RadeonHD6750/Relay4bitComputer/README.md

# Relay4bitComputer
릴레이로 만드는 4bit 컴퓨터

였느나 이왕하는거 8bit로 했다.

2026-05-25, 3-8디코더의 입력단LED 배치가 이상하게 되었으나 디코딩 기능 자체는 정상,
Enabler를 통하여 신호 전력 유지를 하려 했으나 의외로 없어도 잘 됨.
근데 있기는 해야 되는게 신호를 Enable/disable 해야 됨
