RadeonHD6750/Relay4bitComputer/Counter/tDDIFFF.png

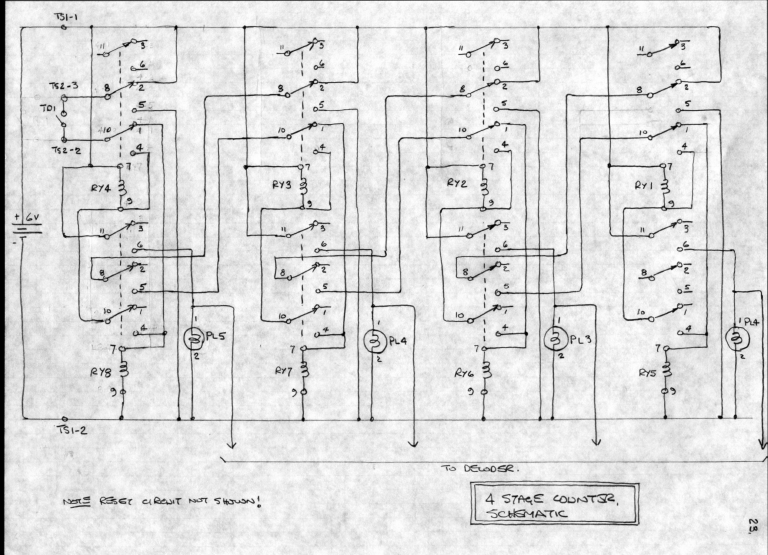
Counter/tDDIFFF.png
