RadeonHD6750/Relay4bitComputer/설계/4bit 가감산기 논리회로.png

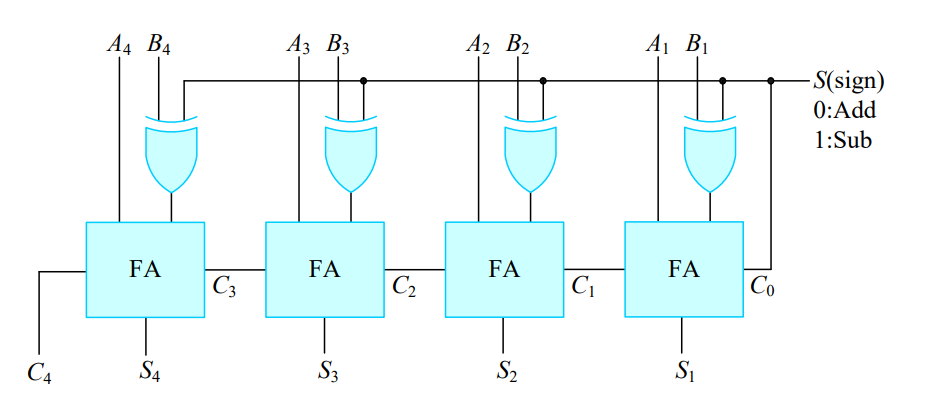
설계/4bit 가감산기 논리회로.png
