RadeonHD6750/Relay4bitComputer/제조/네트클래스 제약조건.png

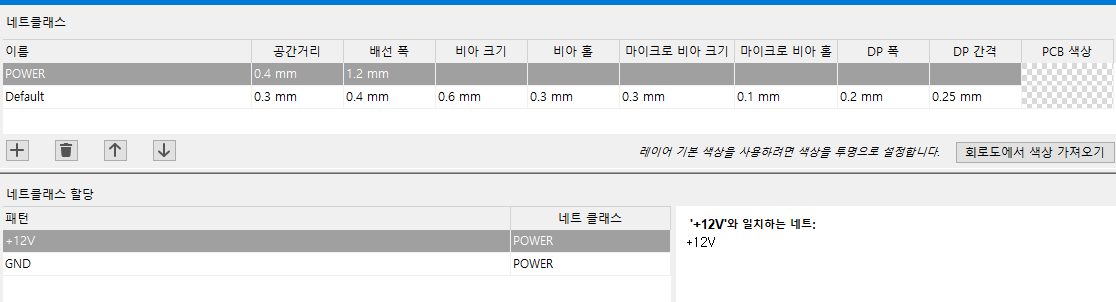
제조/네트클래스 제약조건.png
