RadeonHD6750/Relay4bitComputer/제조/제약조건.png

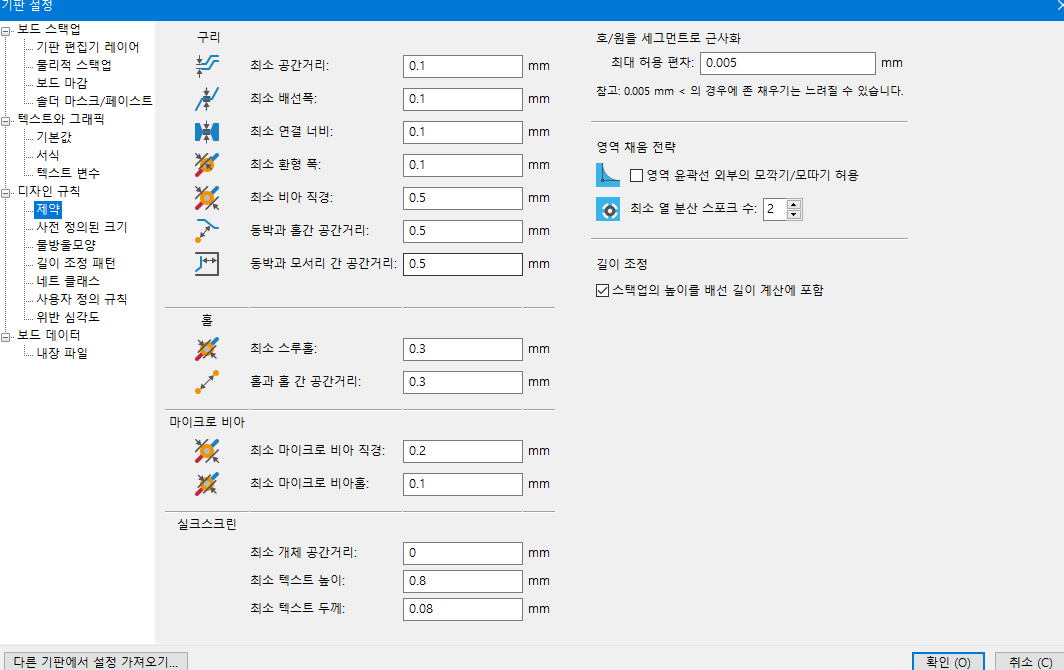
제조/제약조건.png
