RadeonHD6750/Relay4bitComputer/회로도/diode-matrix.jpg

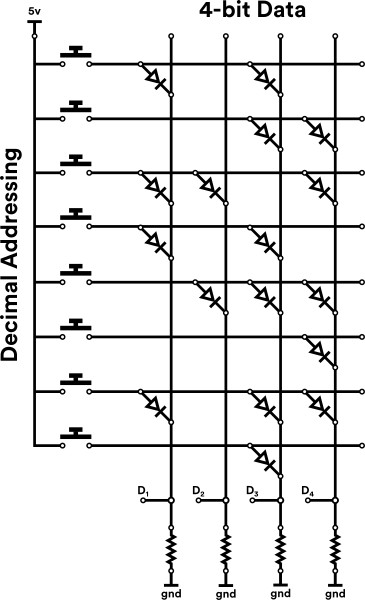
회로도/diode-matrix.jpg
