RadeonHD6750/Relay4bitComputer/Counter/Counter.pdf

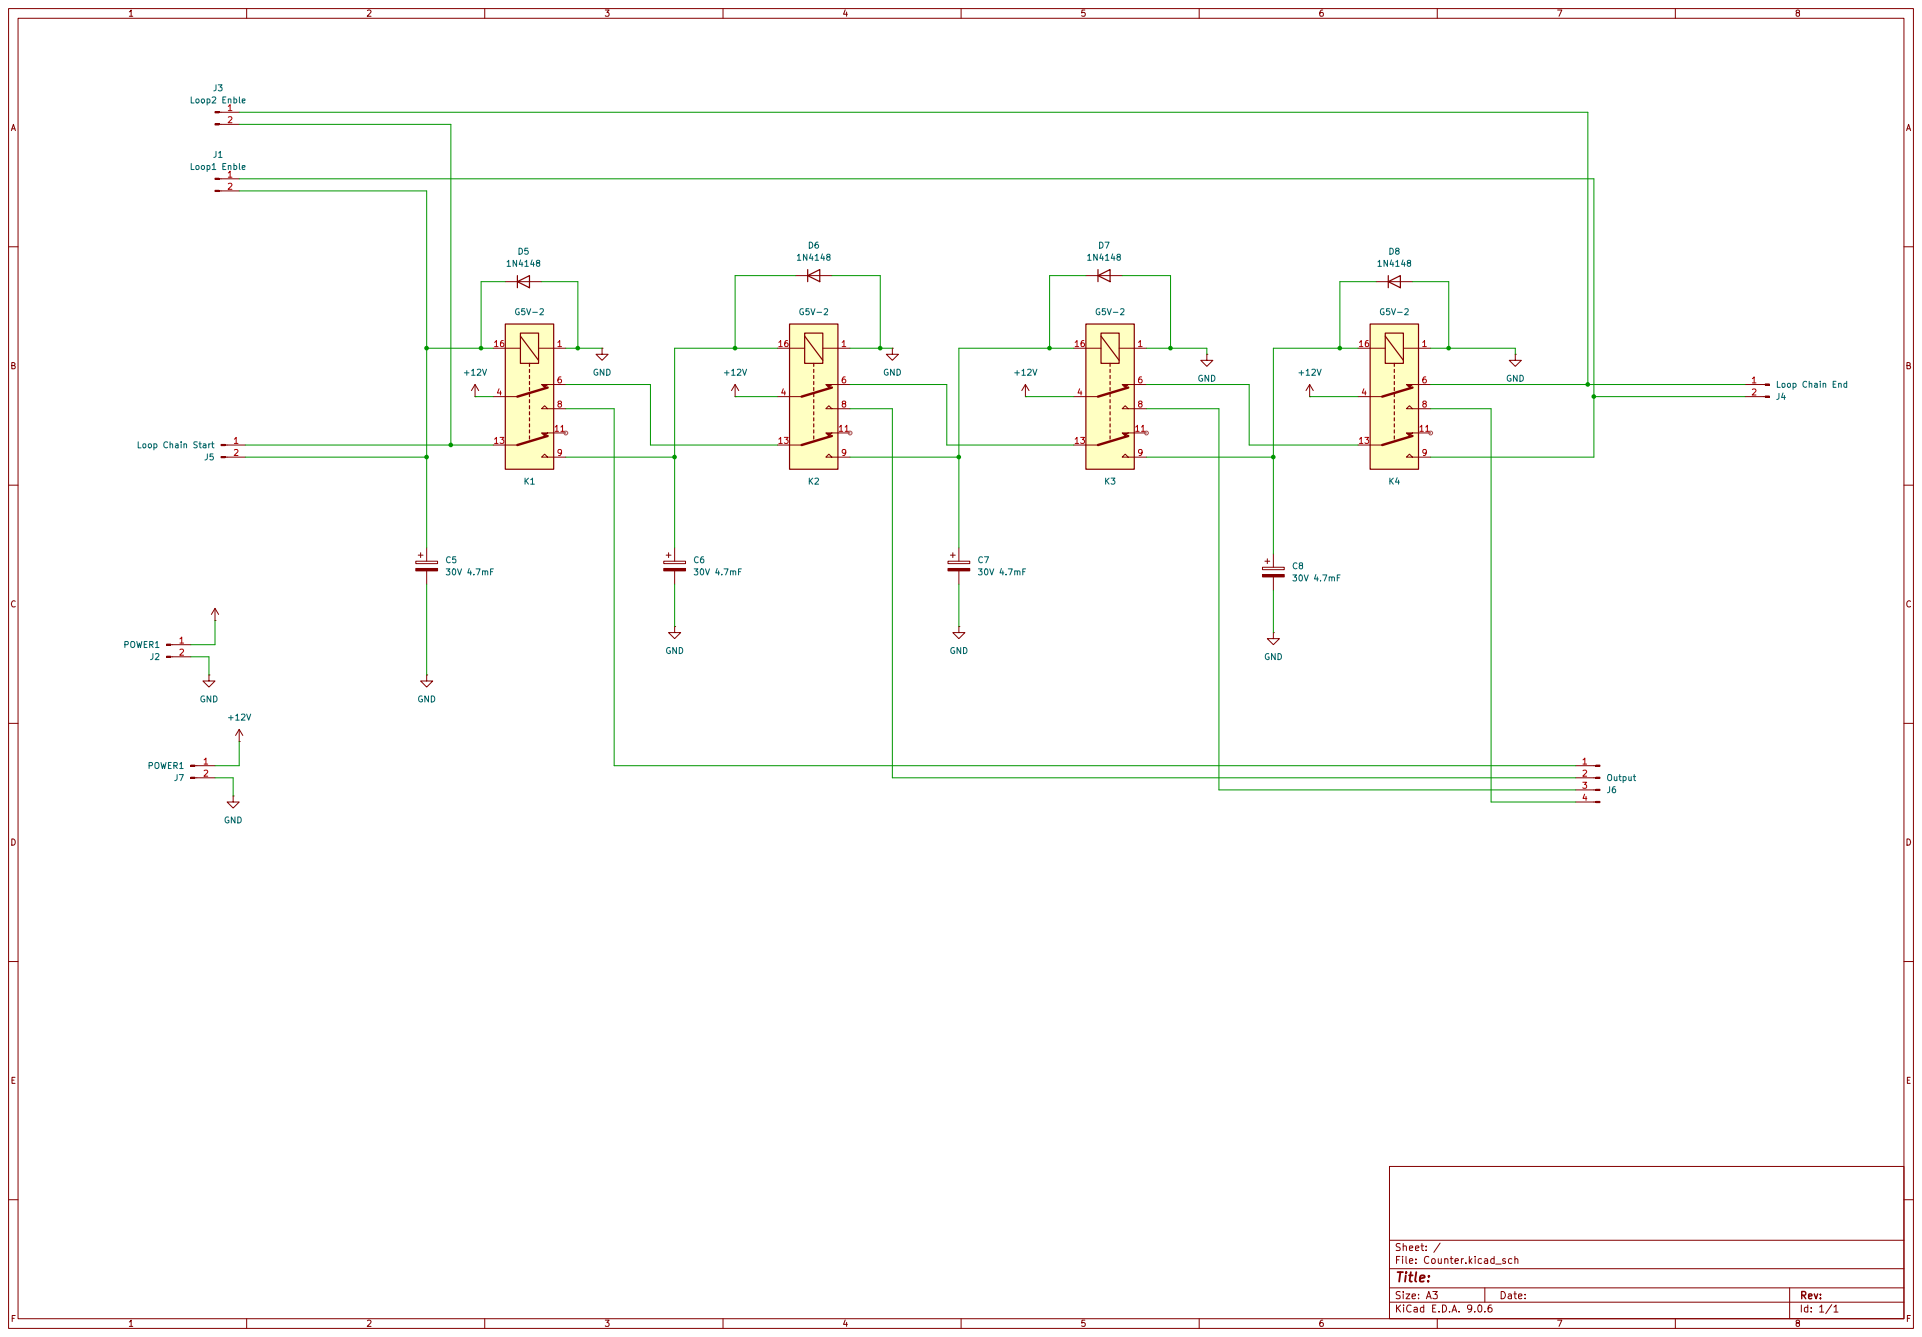
[picture p105: page 1]
