RadeonHD6750/Relay4bitComputer/Enabler/Enabler.pdf

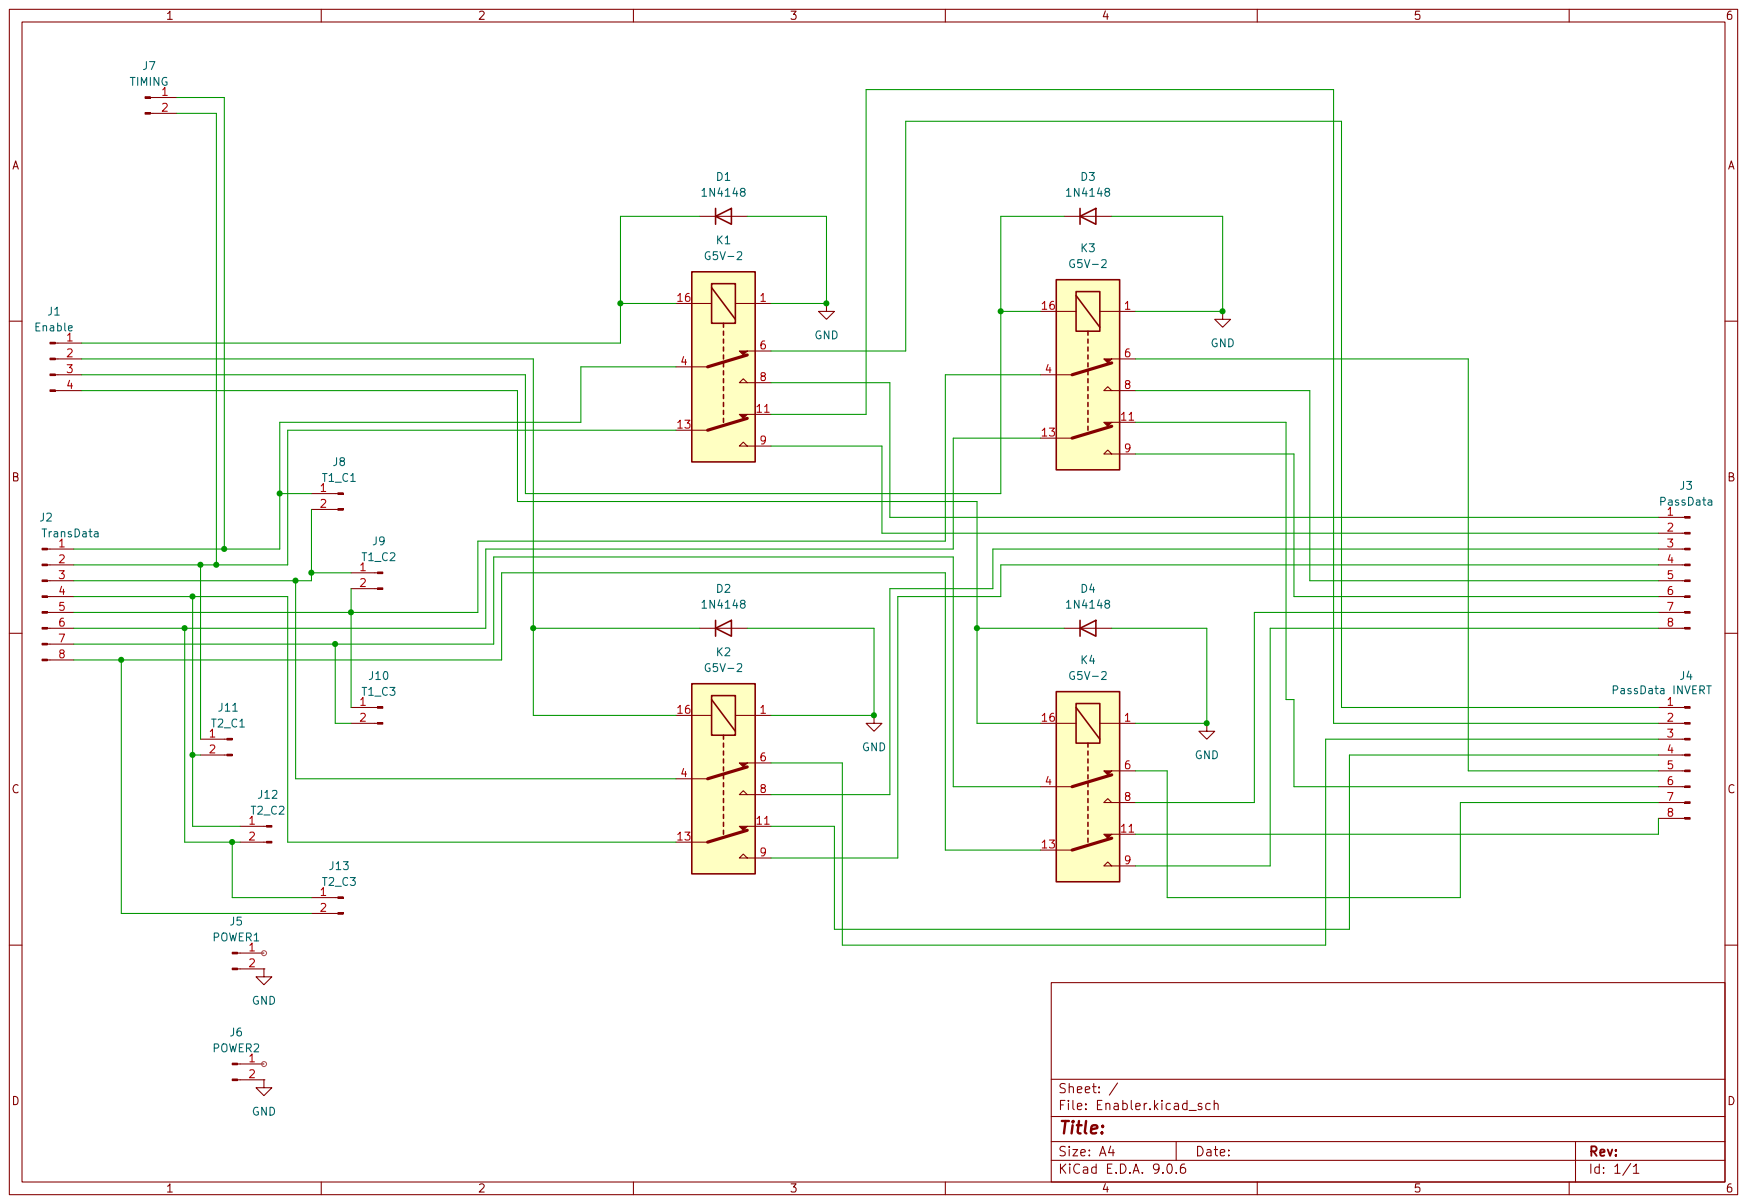
[picture p106: page 1]
