RadeonHD6750/Relay4bitComputer/Decoder/Decoder.kicad_pcb

## KiCad design Decoder/Decoder.kicad_pcb (2026-08-02)

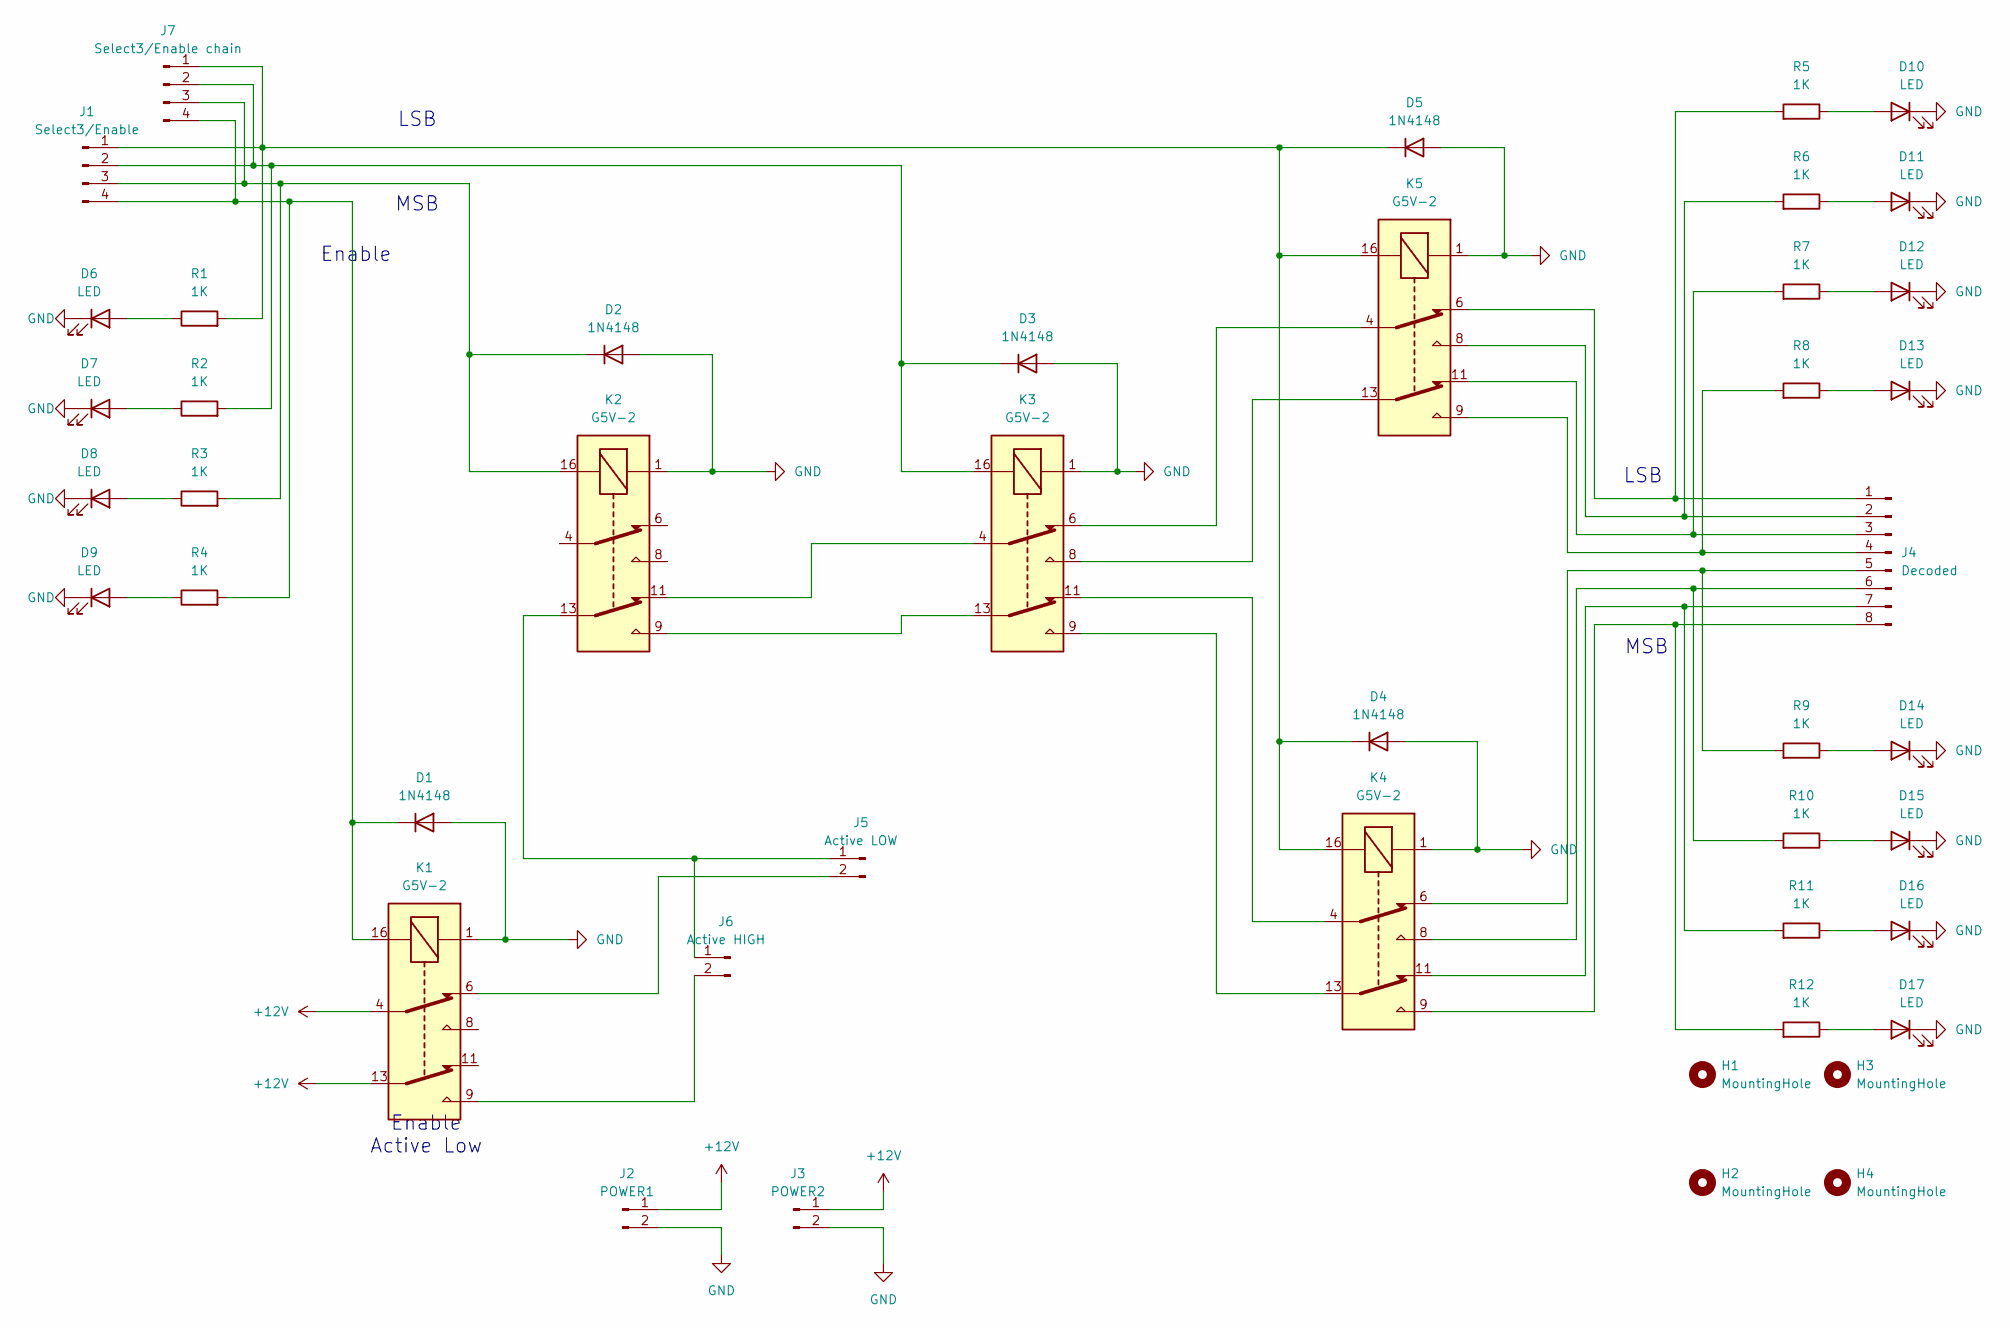
[picture p107: schematic Decoder.kicad_sch]

Parts:
D1, D2, D3, D4, D5: 1N4148; D_DO-35_SOD27_P7.62mm_Horizontal
D6, D7, D8, D9, D10, D11, D12, D13, D14, D15, D16, D17: LED; LED_D5.0mm
H1, H2, H3, H4: MountingHole; MountingHole_3.2mm_M3_Pad
J1: Select3/Enable; PinHeader_1x04_P2.54mm_Vertical
J2: POWER1; PinHeader_1x02_P2.54mm_Vertical
J3: POWER2; PinHeader_1x02_P2.54mm_Vertical
J4: Decoded; PinHeader_1x08_P2.54mm_Vertical
J5: Active LOW; PinHeader_1x02_P2.54mm_Vertical
J6: Active HIGH; PinHeader_1x02_P2.54mm_Vertical
J7: Select3/Enable chain; PinHeader_1x04_P2.54mm_Vertical
K1, K2, K3, K4, K5: G5V-2; Relay_DPDT_Omron_G5V-2
R1, R2, R3, R4, R5, R6, R7, R8, R9, R10, R11, R12: 1K; R_Axial_DIN0207_L6.3mm_D2.5mm_P10.16mm_Horizontal

Connections:
+12V: J2.1, J3.1, K1.4, K1.13
GND: D1.2 (A), D2.2 (A), D3.2 (A), D4.2 (A), D5.2 (A), D6.1 (K), D7.1 (K), D8.1 (K), D9.1 (K), D10.1 (K), D11.1 (K), D12.1 (K), D13.1 (K), D14.1 (K), D15.1 (K), D16.1 (K), D17.1 (K), J2.2, J3.2, K1.1, K2.1, K3.1, K4.1, K5.1
unnamed: D1.1 (K), J1.4, J7.4, K1.16, R4.2
unnamed: D2.1 (K), J1.3, J7.3, K2.16, R3.2
unnamed: D3.1 (K), J1.2, J7.2, K3.16, R2.2
unnamed: D4.1 (K), D5.1 (K), J1.1, J7.1, K4.16, K5.16, R1.2
unnamed: D6.2 (A), R1.1
unnamed: D7.2 (A), R2.1
unnamed: D8.2 (A), R3.1
unnamed: D9.2 (A), R4.1
unnamed: D10.2 (A), R5.1
unnamed: D11.2 (A), R6.1
unnamed: D12.2 (A), R7.1
unnamed: D13.2 (A), R8.1
unnamed: D14.2 (A), R9.1
unnamed: D15.2 (A), R10.1
unnamed: D16.2 (A), R11.1
unnamed: D17.2 (A), R12.1
unnamed: J4.1, K5.6, R5.2
unnamed: J4.2, K5.8, R6.2
unnamed: J4.3, K5.11, R7.2
unnamed: J4.4, K5.9, R8.2
unnamed: J4.5, K4.6, R9.2
unnamed: J4.6, K4.8, R10.2
unnamed: J4.7, K4.11, R11.2
unnamed: J4.8, K4.9, R12.2
unnamed: J5.1, J6.1, K2.13
unnamed: J5.2, K1.6
unnamed: J6.2, K1.9
unnamed: K2.9, K3.13
unnamed: K2.11, K3.4
unnamed: K3.6, K5.4
unnamed: K3.8, K5.13
unnamed: K3.9, K4.13
unnamed: K3.11, K4.4

Notes on the sheet:
LSB
MSB
Enable
Enable Active Low

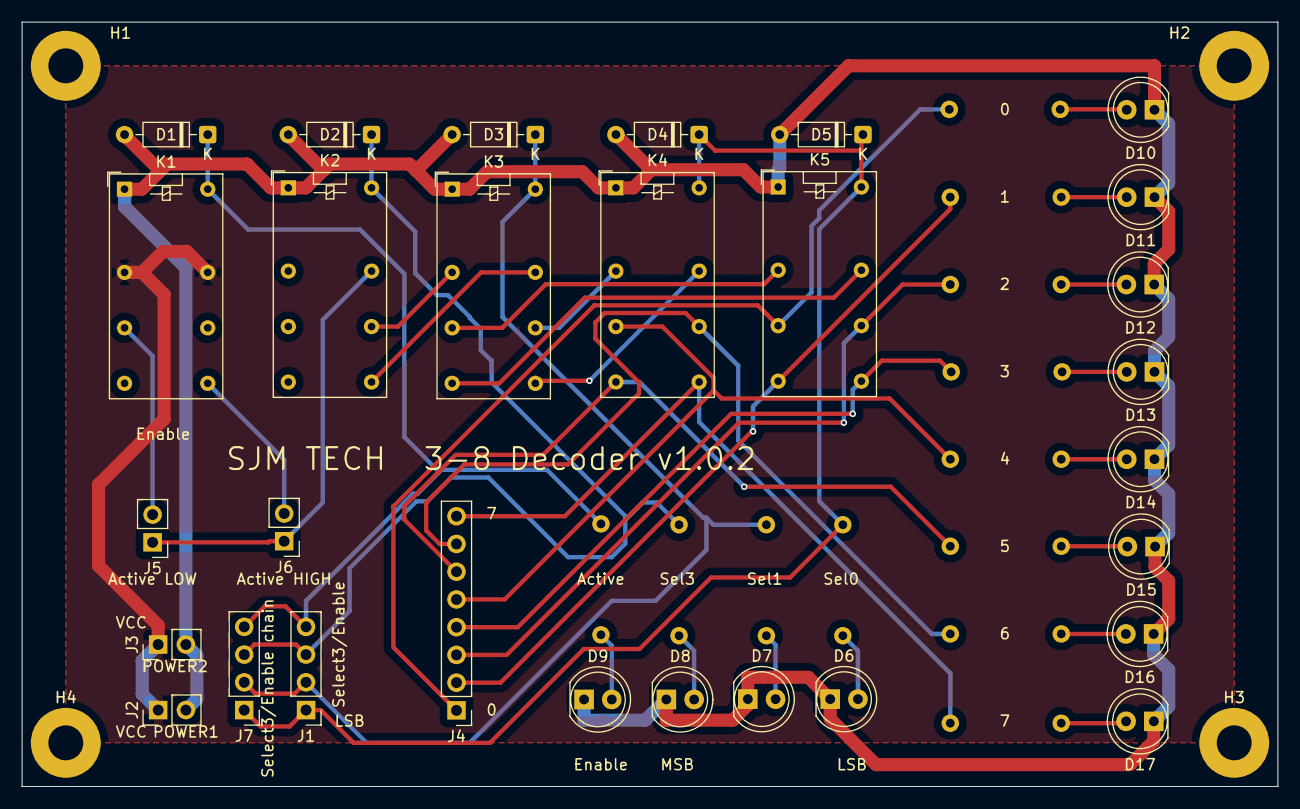
[picture p108: board Decoder.kicad_pcb from above]

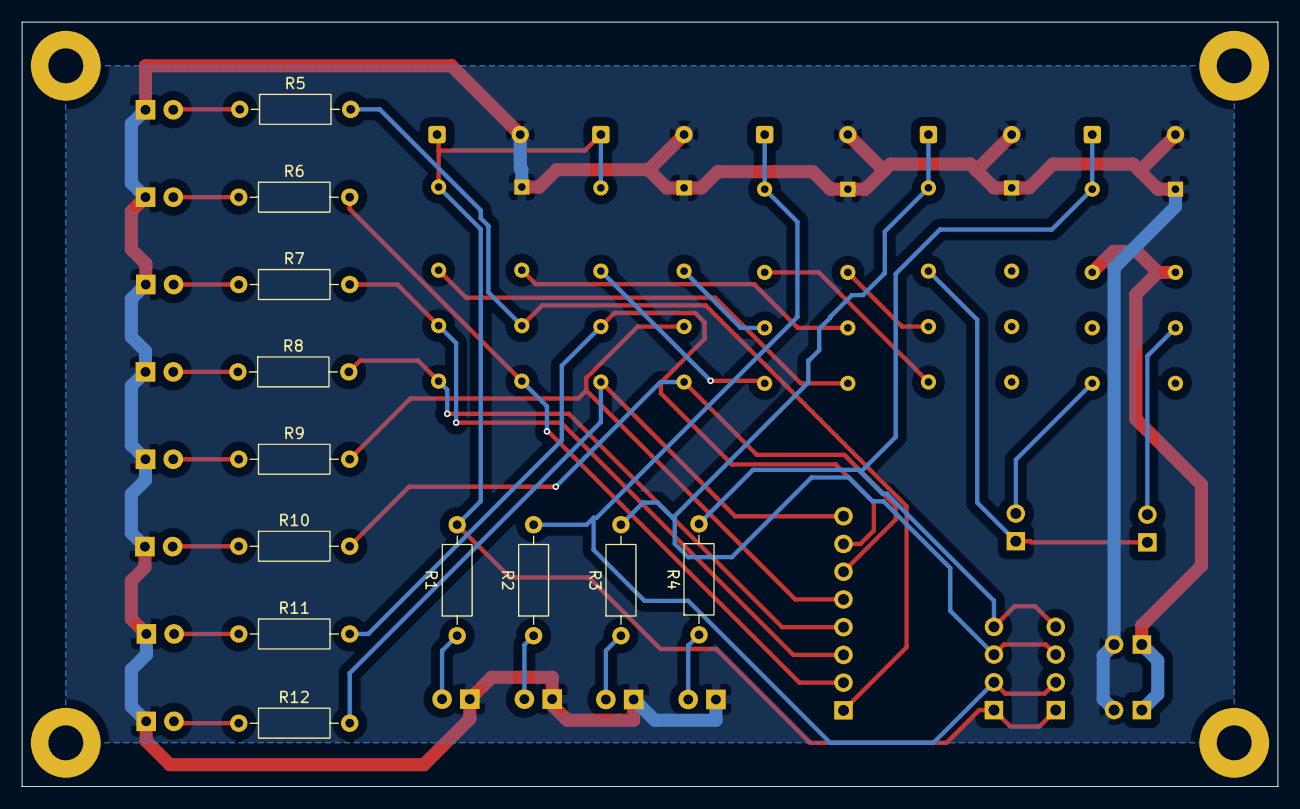
[picture p109: board Decoder.kicad_pcb from below]

Board: 2 copper layers, 115.0 x 70.0 mm, 45 parts (12 on the bottom side), 35 nets.
