RadeonHD6750/Relay4bitComputer/Counter/Counter.kicad_pcb

## KiCad design Counter/Counter.kicad_pcb (2026-07-11)

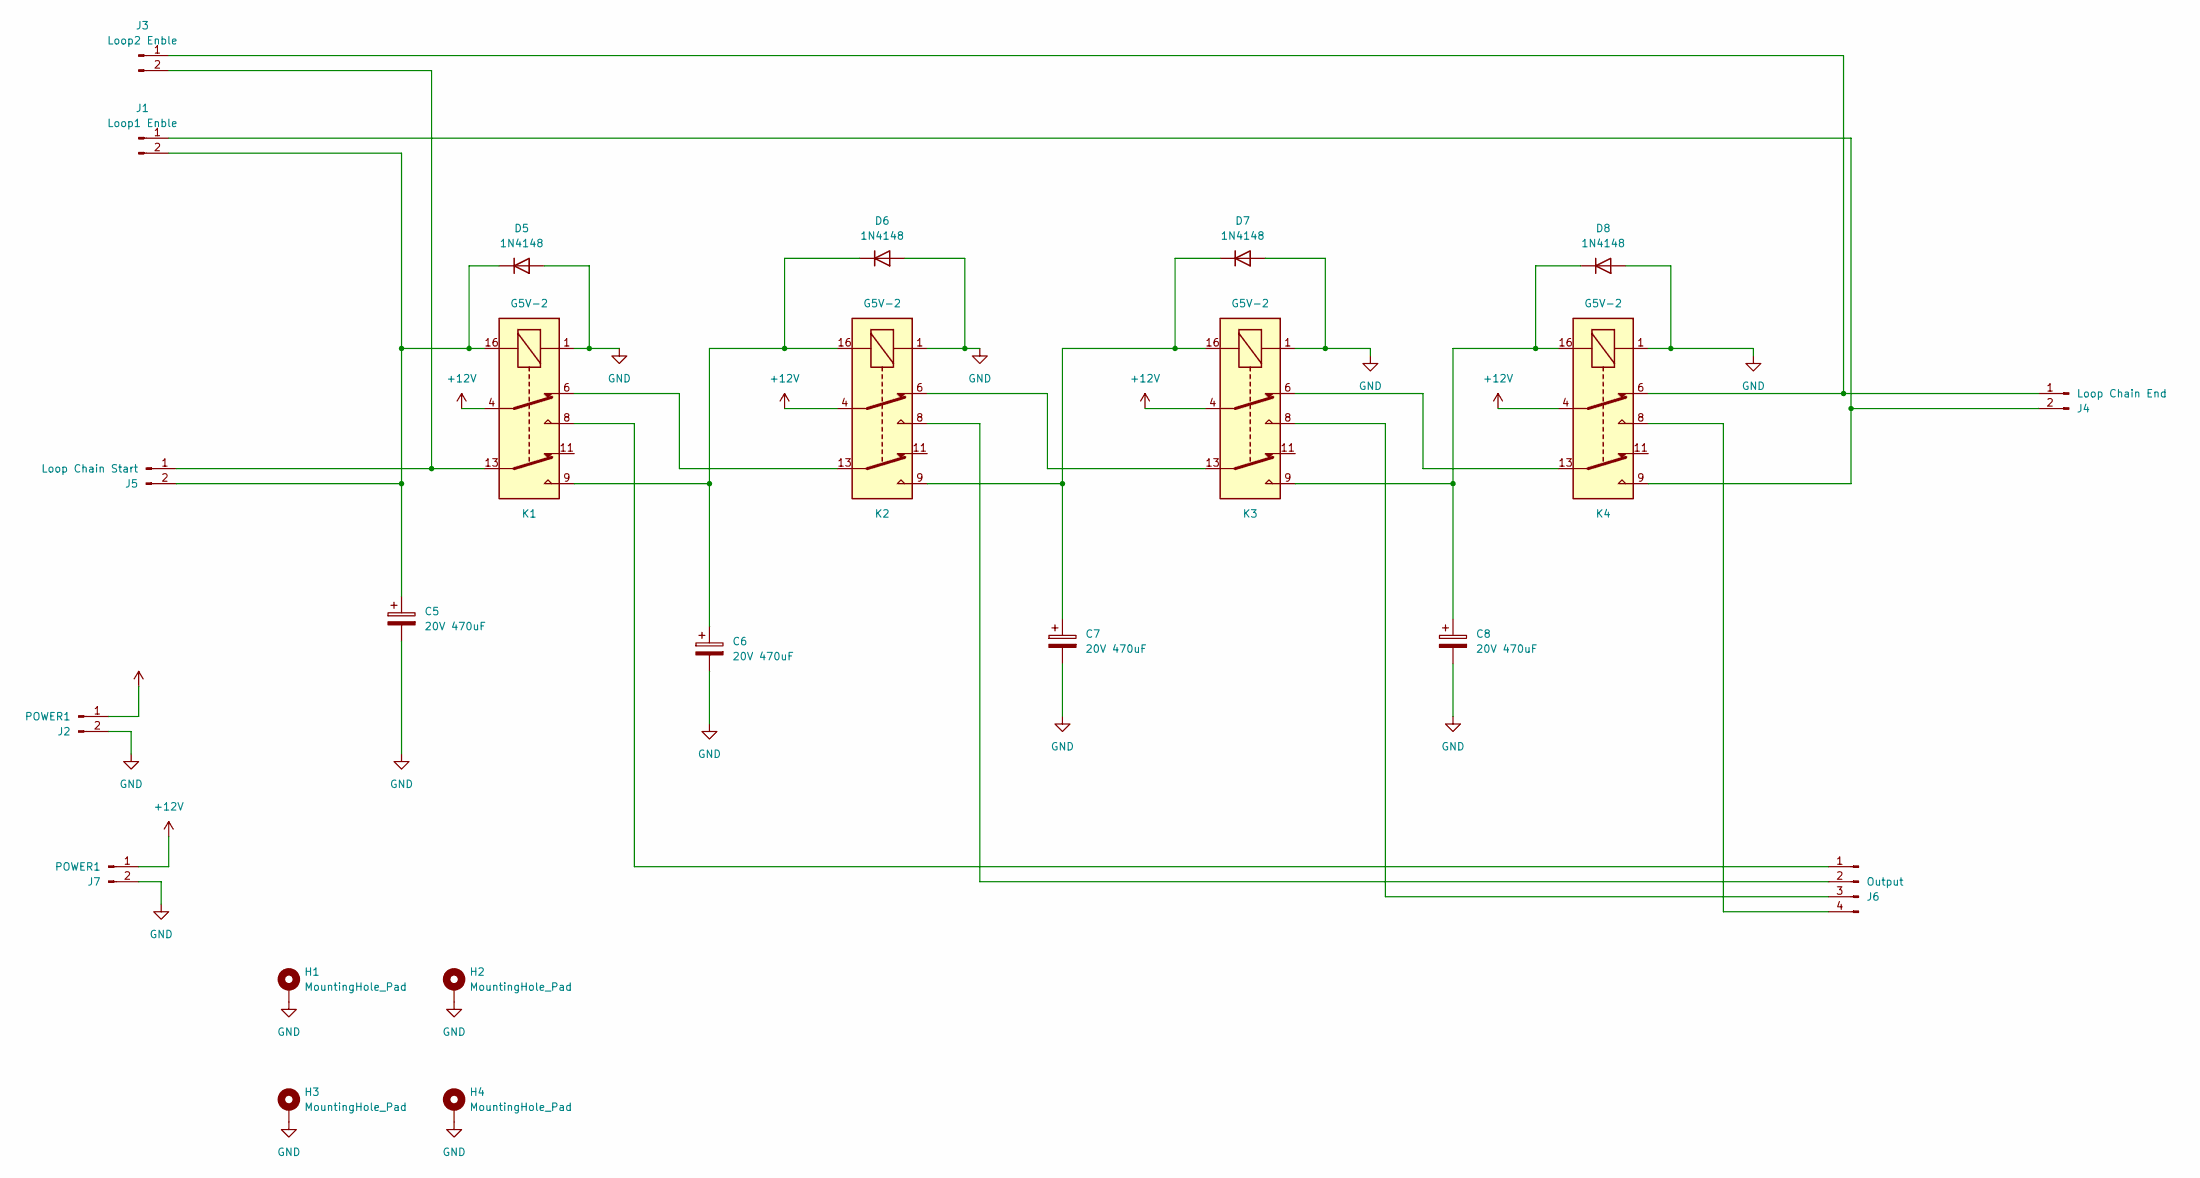
[picture p110: schematic Counter.kicad_sch]

Parts:
C5, C6, C7, C8: 20V 470uF; CP_Radial_D12.5mm_P5.00mm
D5, D6, D7, D8: 1N4148; D_DO-35_SOD27_P7.62mm_Horizontal
H1, H2, H3, H4: MountingHole_Pad; MountingHole_3.2mm_M3_Pad
J1: Loop1 Enble; PinHeader_1x02_P2.54mm_Vertical
J2, J7: POWER1; PinHeader_1x02_P2.54mm_Vertical
J3: Loop2 Enble; PinHeader_1x02_P2.54mm_Vertical
J4: Loop Chain End; PinHeader_1x02_P2.54mm_Vertical
J5: Loop Chain Start; PinHeader_1x02_P2.54mm_Vertical
J6: Output; PinHeader_1x04_P2.54mm_Vertical
K1, K2, K3, K4: G5V-2; Relay_DPDT_Omron_G5V-2

Connections:
+12V: J2.1, J7.1, K1.4, K2.4, K3.4, K4.4
GND: C5.2, C6.2, C7.2, C8.2, D5.2 (A), D6.2 (A), D7.2 (A), D8.2 (A), H1.1, H2.1, H3.1, H4.1, J2.2, J7.2, K1.1, K2.1, K3.1, K4.1
unnamed: C5.1, D5.1 (K), J1.2, J5.2, K1.16
unnamed: C6.1, D6.1 (K), K1.9, K2.16
unnamed: C7.1, D7.1 (K), K2.9, K3.16
unnamed: C8.1, D8.1 (K), K3.9, K4.16
unnamed: J1.1, J4.2, K4.9
unnamed: J3.1, J4.1, K4.6
unnamed: J3.2, J5.1, K1.13
unnamed: J6.1, K1.8
unnamed: J6.2, K2.8
unnamed: J6.3, K3.8
unnamed: J6.4, K4.8
unnamed: K1.6, K2.13
unnamed: K2.6, K3.13
unnamed: K3.6, K4.13

Board: 2 copper layers, 23 parts (0 on the bottom side), 16 nets, no tracks yet.
