RadeonHD6750/Relay4bitComputer/Enabler/Enabler.kicad_pcb

## KiCad design Enabler/Enabler.kicad_pcb (2026-07-11)

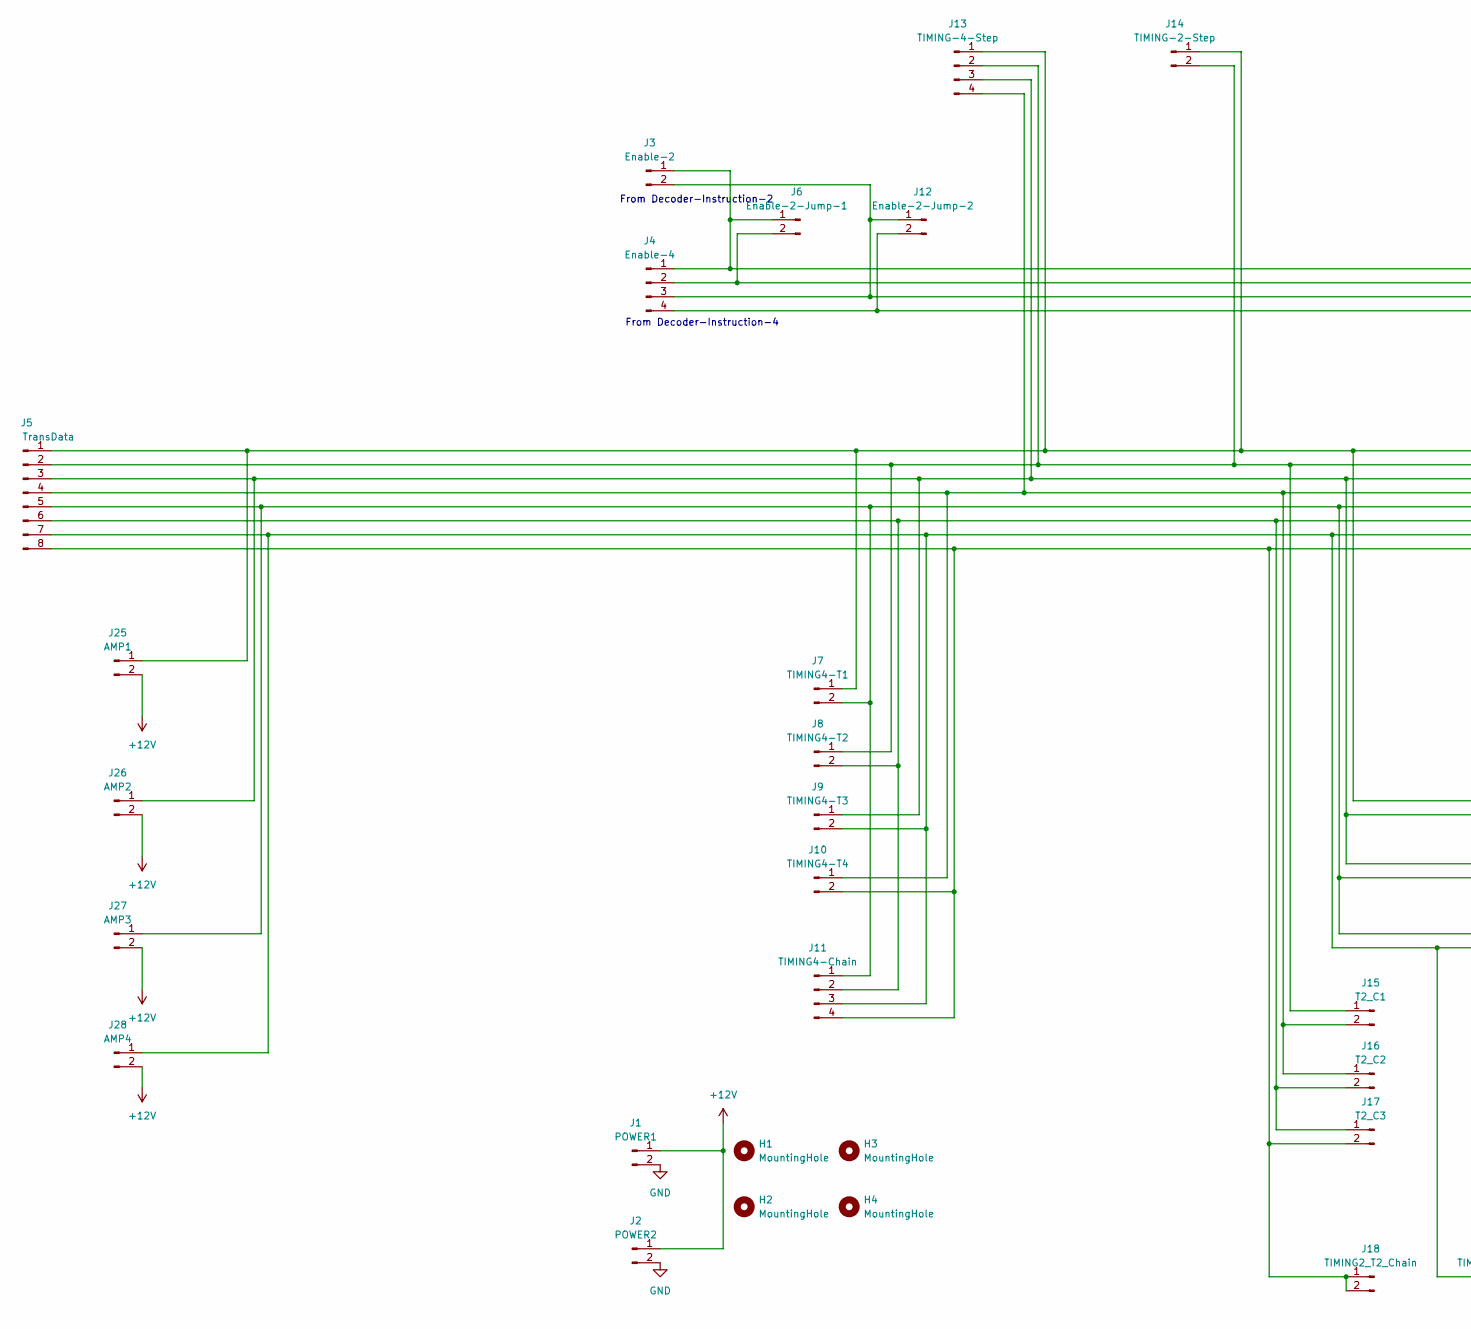
[picture p111: schematic Enabler.kicad_sch, part in row 1, column 1]

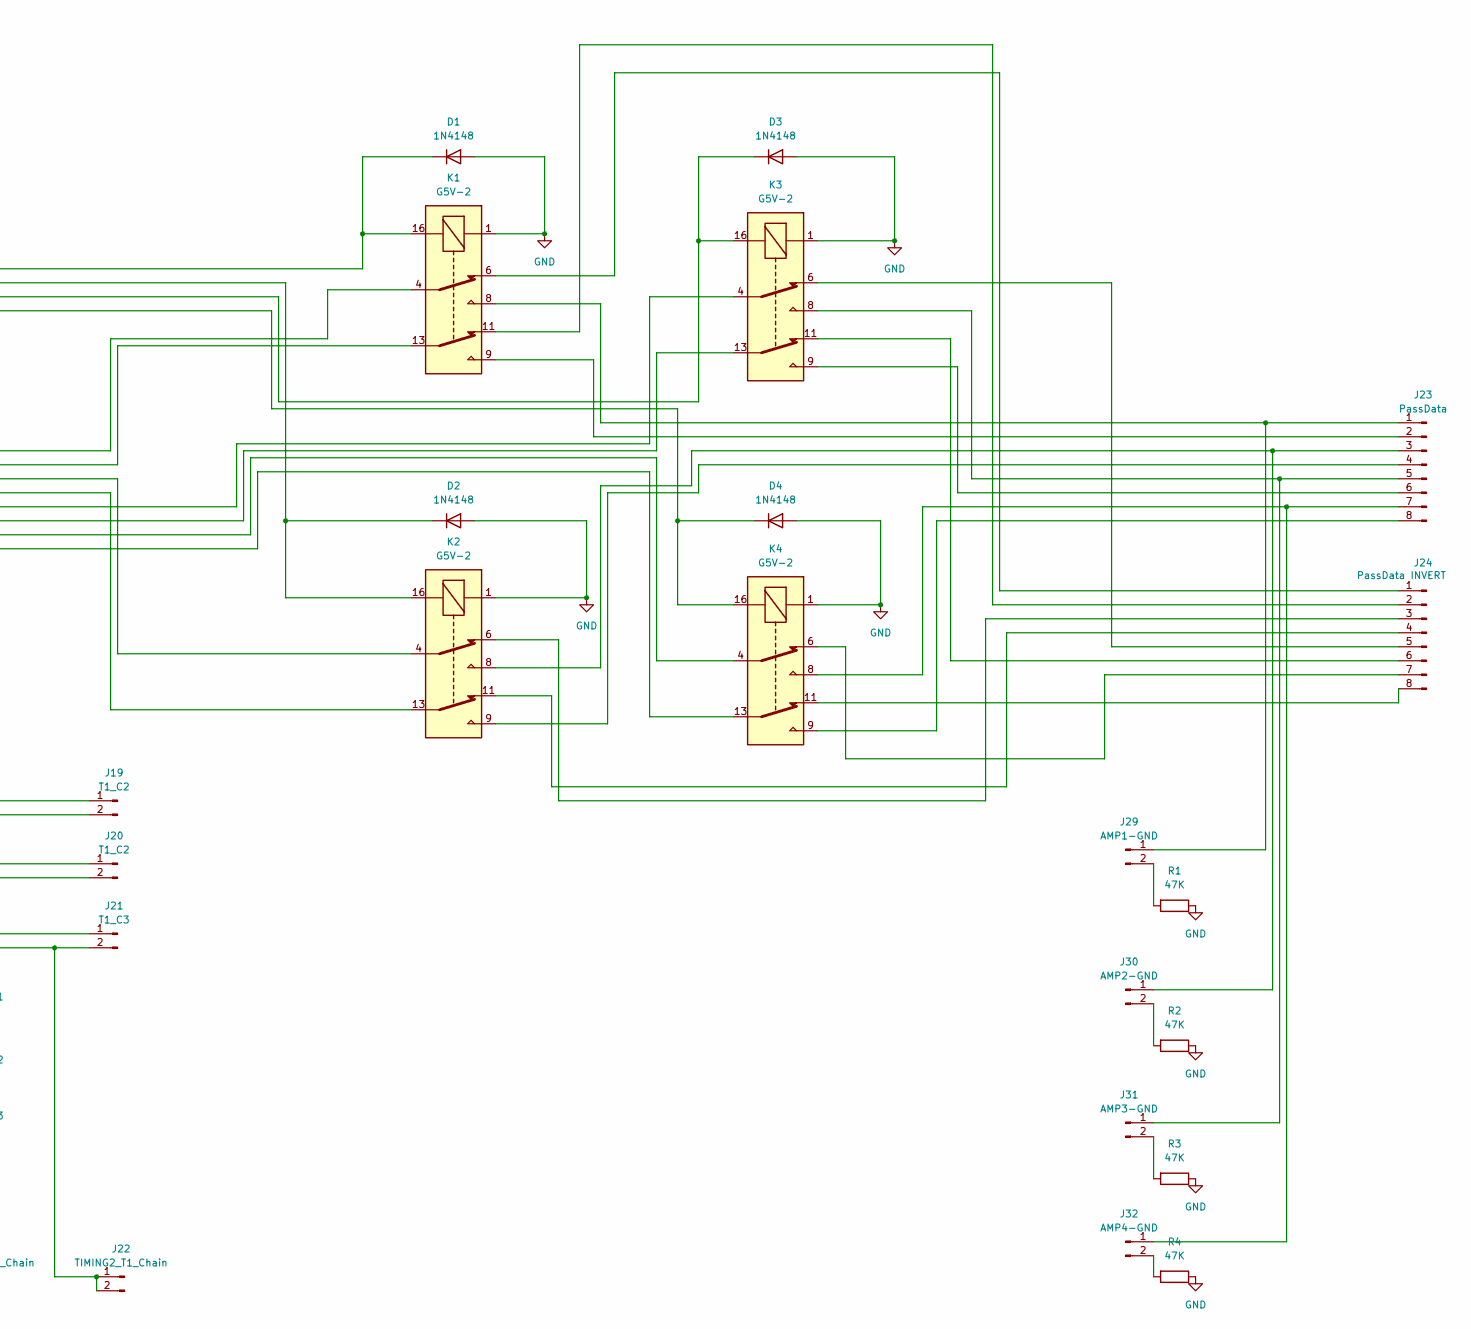
[picture p112: schematic Enabler.kicad_sch, part in row 1, column 2]

Parts:
D1, D2, D3, D4: 1N4148; D_DO-35_SOD27_P7.62mm_Horizontal
H1, H2, H3, H4: MountingHole; MountingHole_3.2mm_M3
J1: POWER1; PinHeader_1x02_P2.54mm_Vertical
J2: POWER2; PinHeader_1x02_P2.54mm_Vertical
J3: Enable-2; PinHeader_1x02_P2.54mm_Vertical
J4: Enable-4; PinHeader_1x04_P2.54mm_Vertical
J5: TransData; PinHeader_1x08_P2.54mm_Vertical
J6: Enable-2-Jump-1; PinHeader_1x02_P2.54mm_Vertical
J7: TIMING4-T1; PinHeader_1x02_P2.54mm_Vertical
J8: TIMING4-T2; PinHeader_1x02_P2.54mm_Vertical
J9: TIMING4-T3; PinHeader_1x02_P2.54mm_Vertical
J10: TIMING4-T4; PinHeader_1x02_P2.54mm_Vertical
J11: TIMING4-Chain; PinHeader_1x04_P2.54mm_Vertical
J12: Enable-2-Jump-2; PinHeader_1x02_P2.54mm_Vertical
J13: TIMING-4-Step; PinHeader_1x04_P2.54mm_Vertical
J14: TIMING-2-Step; PinHeader_1x02_P2.54mm_Vertical
J15: T2_C1; PinHeader_1x02_P2.54mm_Vertical
J16: T2_C2; PinHeader_1x02_P2.54mm_Vertical
J17: T2_C3; PinHeader_1x02_P2.54mm_Vertical
J18: TIMING2_T2_Chain; PinHeader_1x02_P2.54mm_Vertical
J19, J20: T1_C2; PinHeader_1x02_P2.54mm_Vertical
J21: T1_C3; PinHeader_1x02_P2.54mm_Vertical
J22: TIMING2_T1_Chain; PinHeader_1x02_P2.54mm_Vertical
J23: PassData; PinHeader_1x08_P2.54mm_Vertical
J24: PassData INVERT; PinHeader_1x08_P2.54mm_Vertical
J25: AMP1; PinHeader_1x02_P2.54mm_Vertical
J26: AMP2; PinHeader_1x02_P2.54mm_Vertical
J27: AMP3; PinHeader_1x02_P2.54mm_Vertical
J28: AMP4; PinHeader_1x02_P2.54mm_Vertical
J29: AMP1-GND; PinHeader_1x02_P2.54mm_Vertical
J30: AMP2-GND; PinHeader_1x02_P2.54mm_Vertical
J31: AMP3-GND; PinHeader_1x02_P2.54mm_Vertical
J32: AMP4-GND; PinHeader_1x02_P2.54mm_Vertical
K1, K2, K3, K4: G5V-2; Relay_DPDT_Omron_G5V-2
R1, R2, R3, R4: 47K; R_Axial_DIN0207_L6.3mm_D2.5mm_P10.16mm_Horizontal

Connections:
+12V: J1.1, J2.1, J25.2, J26.2, J27.2, J28.2
GND: D1.2 (A), D2.2 (A), D3.2 (A), D4.2 (A), J1.2, J2.2, K1.1, K2.1, K3.1, K4.1, R1.1, R2.1, R3.1, R4.1
unnamed: D1.1 (K), J3.1, J4.1, J6.1, K1.16
unnamed: D2.1 (K), J4.2, J6.2, K2.16
unnamed: D3.1 (K), J3.2, J4.3, J12.1, K3.16
unnamed: D4.1 (K), J4.4, J12.2, K4.16
unnamed: J5.4, J10.1, J13.4, J15.2, J16.1, K2.13
unnamed: J5.8, J10.2, J11.4, J17.2, J18.1, J18.2, K4.13
unnamed: J5.5, J7.2, J11.1, J20.2, J21.1, J27.1, K3.4
unnamed: J5.6, J8.2, J11.2, J16.2, J17.1, K3.13
unnamed: J5.7, J9.2, J11.3, J21.2, J22.1, J22.2, J28.1, K4.4
unnamed: J5.1, J7.1, J13.1, J14.1, J19.1, J25.1, K1.4
unnamed: J5.2, J8.1, J13.2, J14.2, J15.1, K1.13
unnamed: J5.3, J9.1, J13.3, J19.2, J20.1, J26.1, K2.4
unnamed: J23.1, J29.1, K1.8
unnamed: J23.2, K1.9
unnamed: J23.3, J30.1, K2.8
unnamed: J23.4, K2.9
unnamed: J23.5, J31.1, K3.8
unnamed: J23.6, K3.9
unnamed: J23.7, J32.1, K4.8
unnamed: J23.8, K4.9
unnamed: J24.1, K1.6
unnamed: J24.2, K1.11
unnamed: J24.3, K2.6
unnamed: J24.4, K2.11
unnamed: J24.5, K3.6
unnamed: J24.6, K3.11
unnamed: J24.7, K4.6
unnamed: J24.8, K4.11
unnamed: J29.2, R1.2
unnamed: J30.2, R2.2
unnamed: J31.2, R3.2
unnamed: J32.2, R4.2

Notes on the sheet:
From Decoder-Instruction-4
From Decoder-Instruction-2

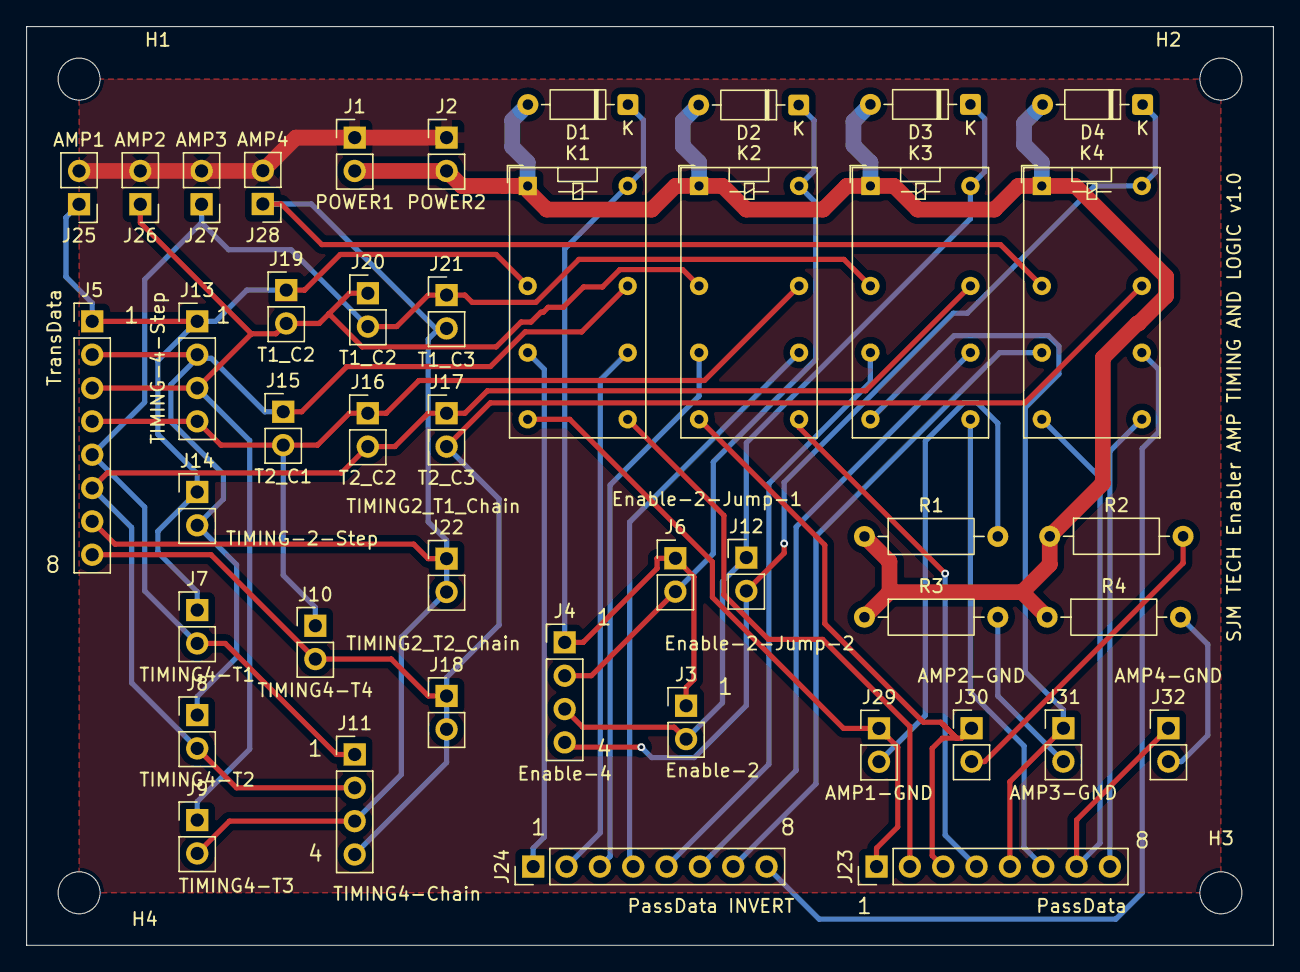
[picture p113: board Enabler.kicad_pcb from above]

Board: 2 copper layers, 95.0 x 70.0 mm, 48 parts (0 on the bottom side), 34 nets.
