RadeonHD6750/Relay4bitComputer/MatrixROM/MatrixROM.kicad_pcb

## KiCad design MatrixROM/MatrixROM.kicad_pcb (2026-07-05)

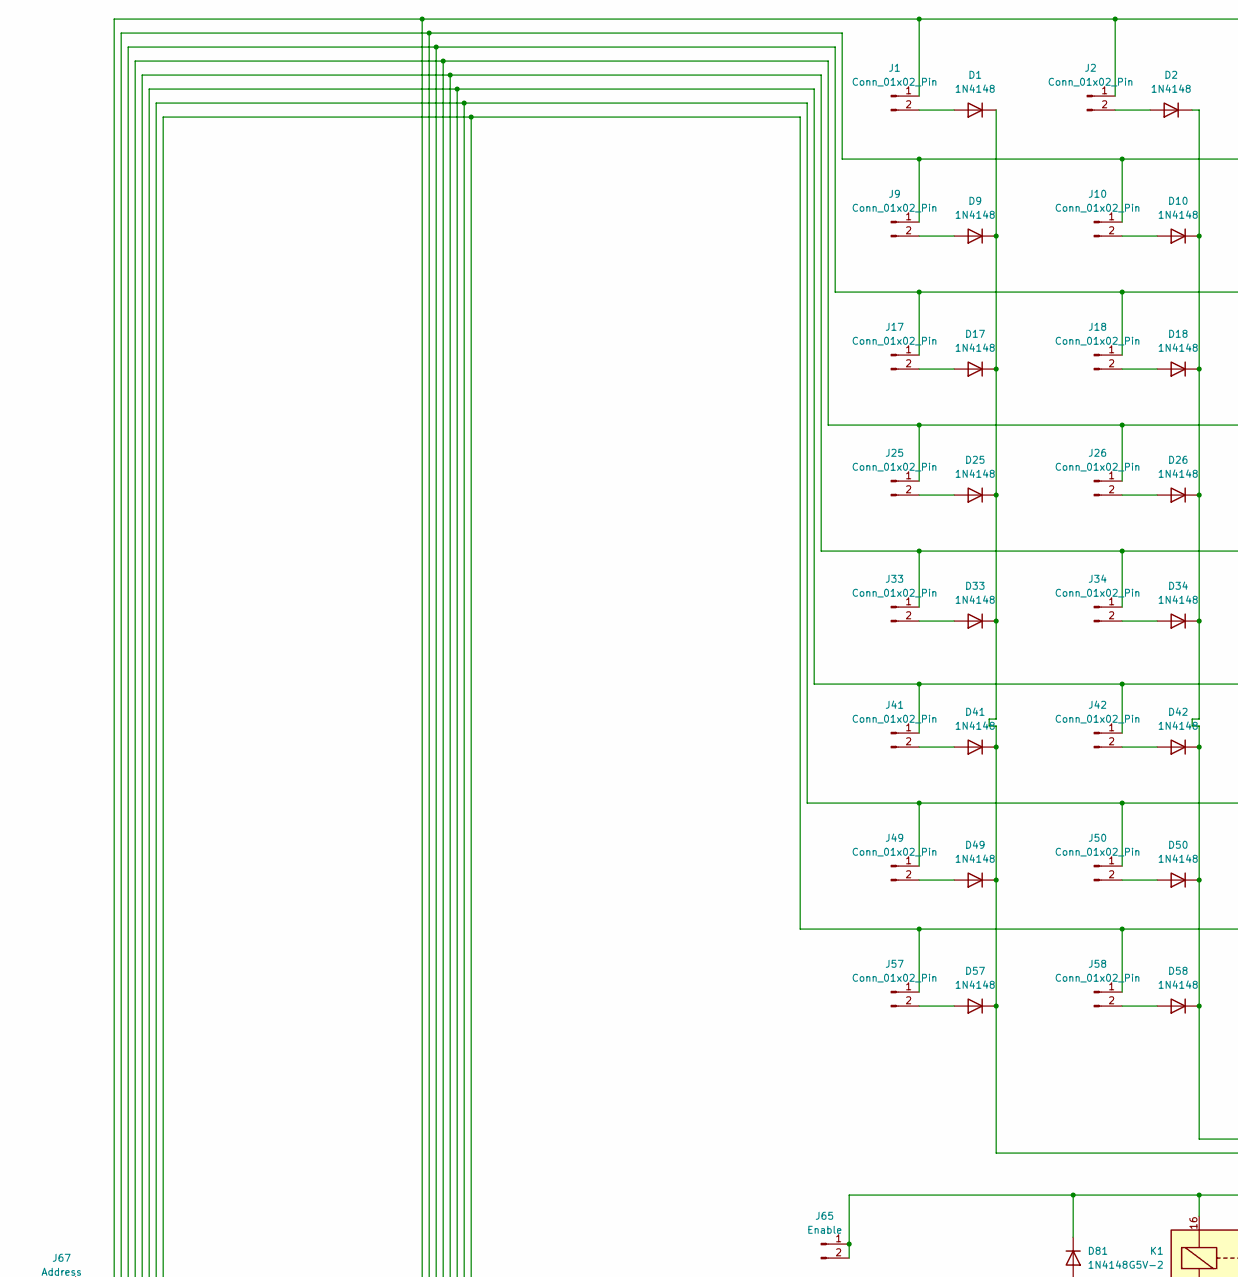
[picture p114: schematic MatrixROM.kicad_sch, part in row 1, column 1]

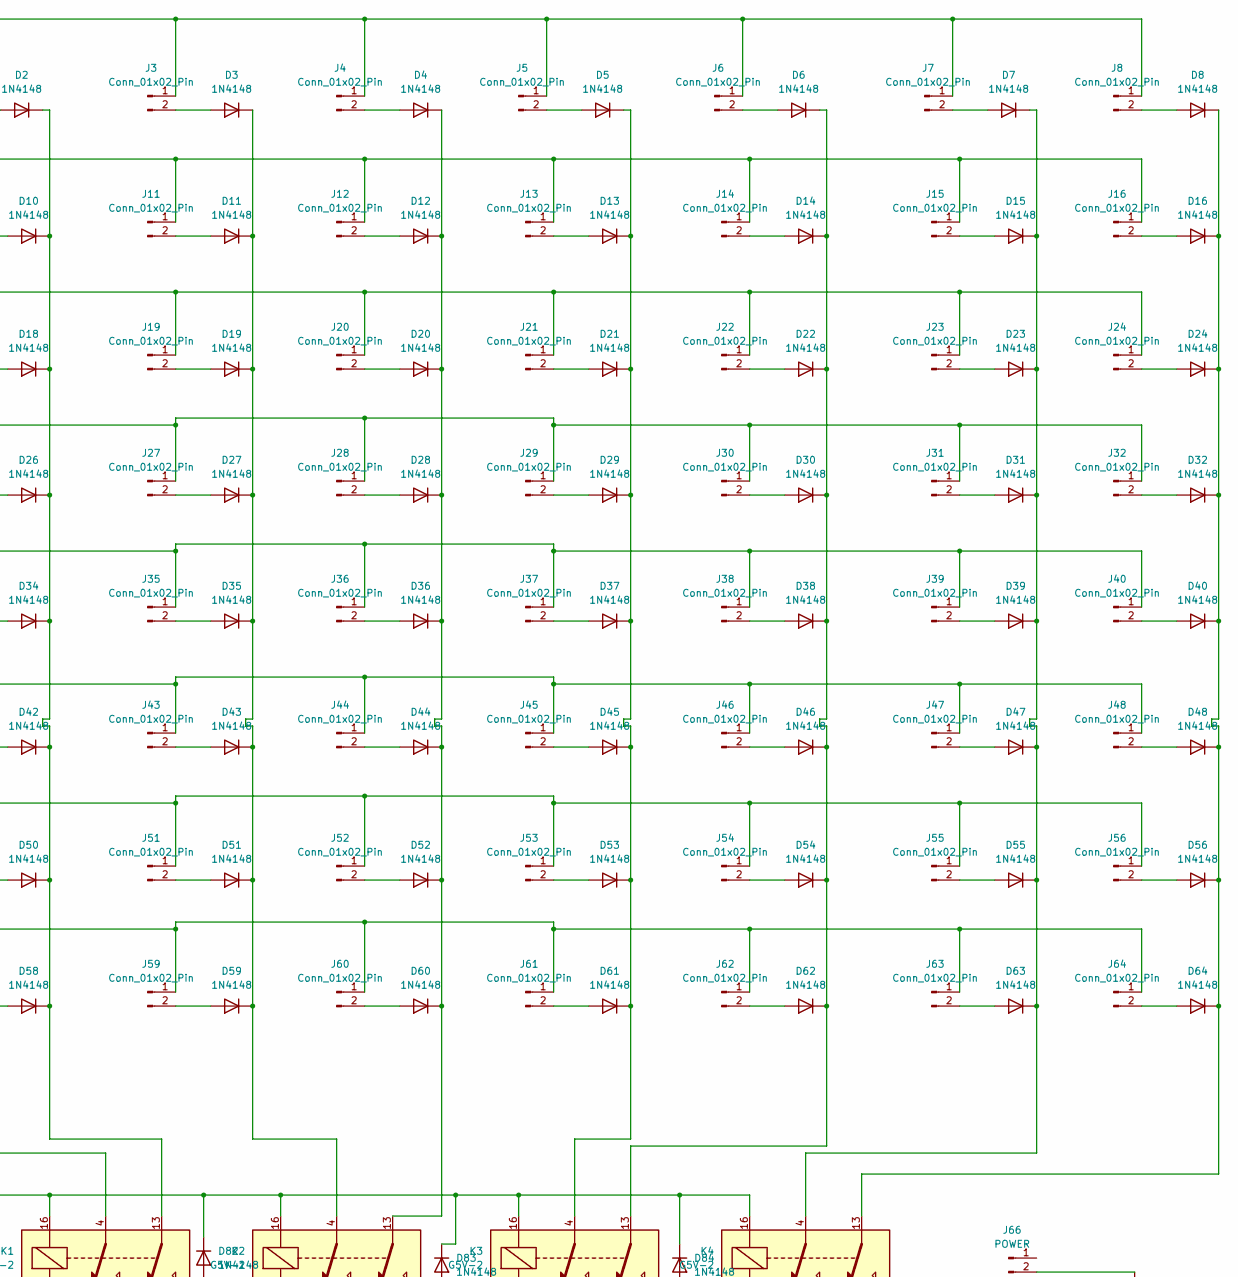
[picture p115: schematic MatrixROM.kicad_sch, part in row 1, column 2]

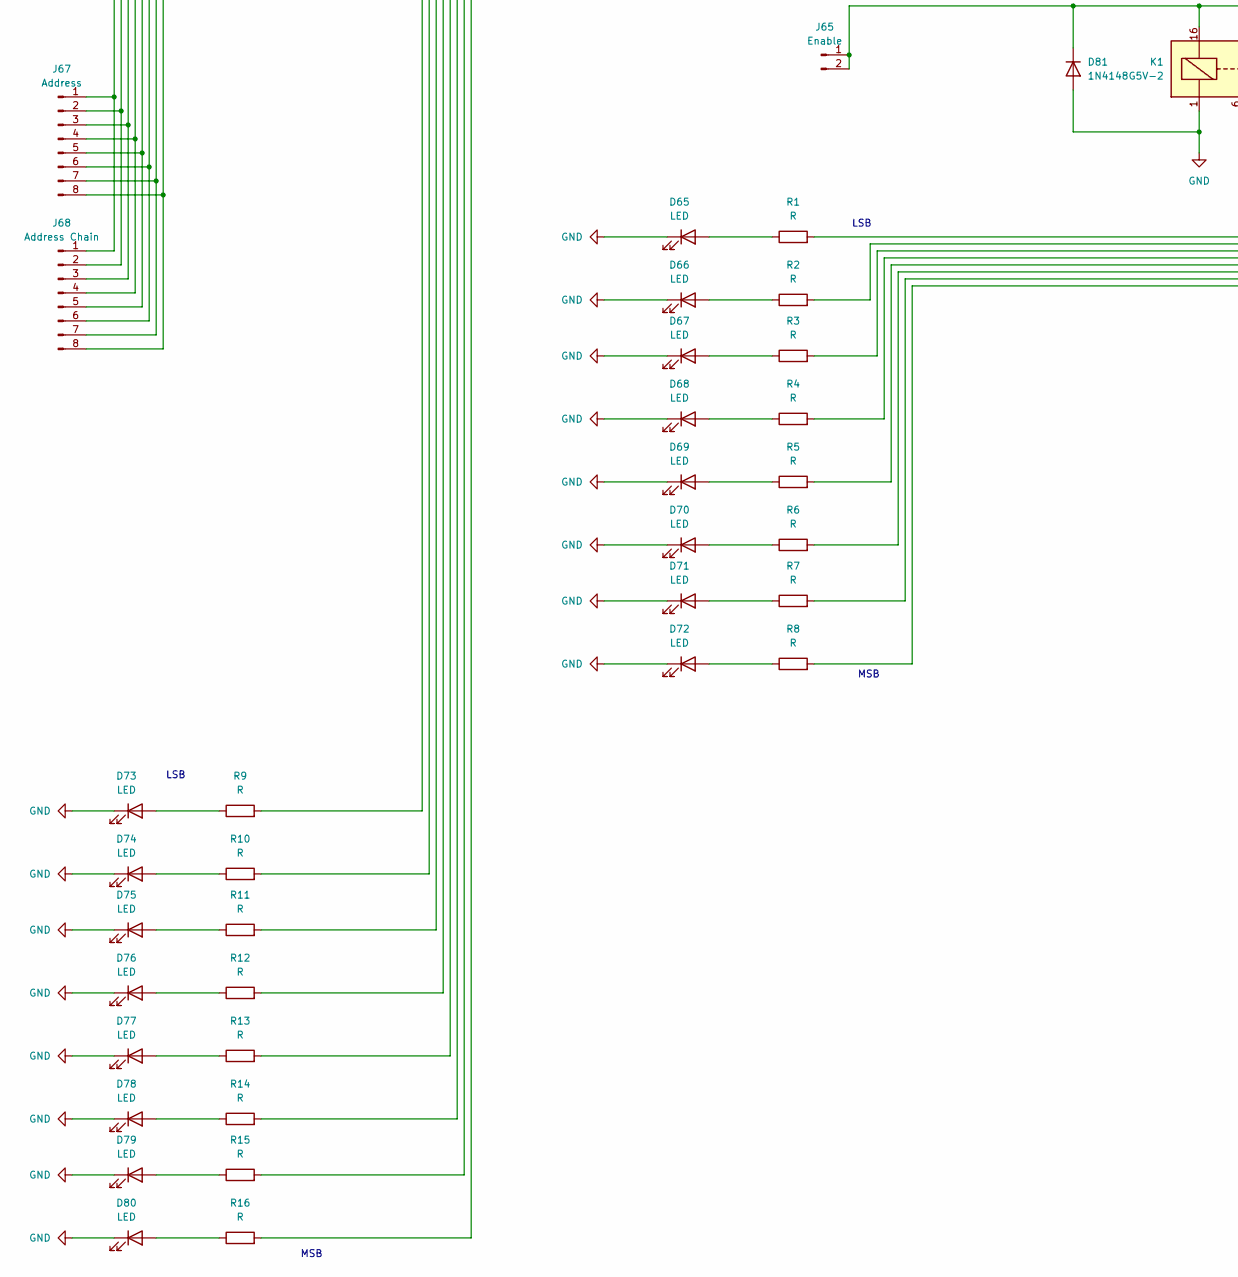
[picture p116: schematic MatrixROM.kicad_sch, part in row 2, column 1]

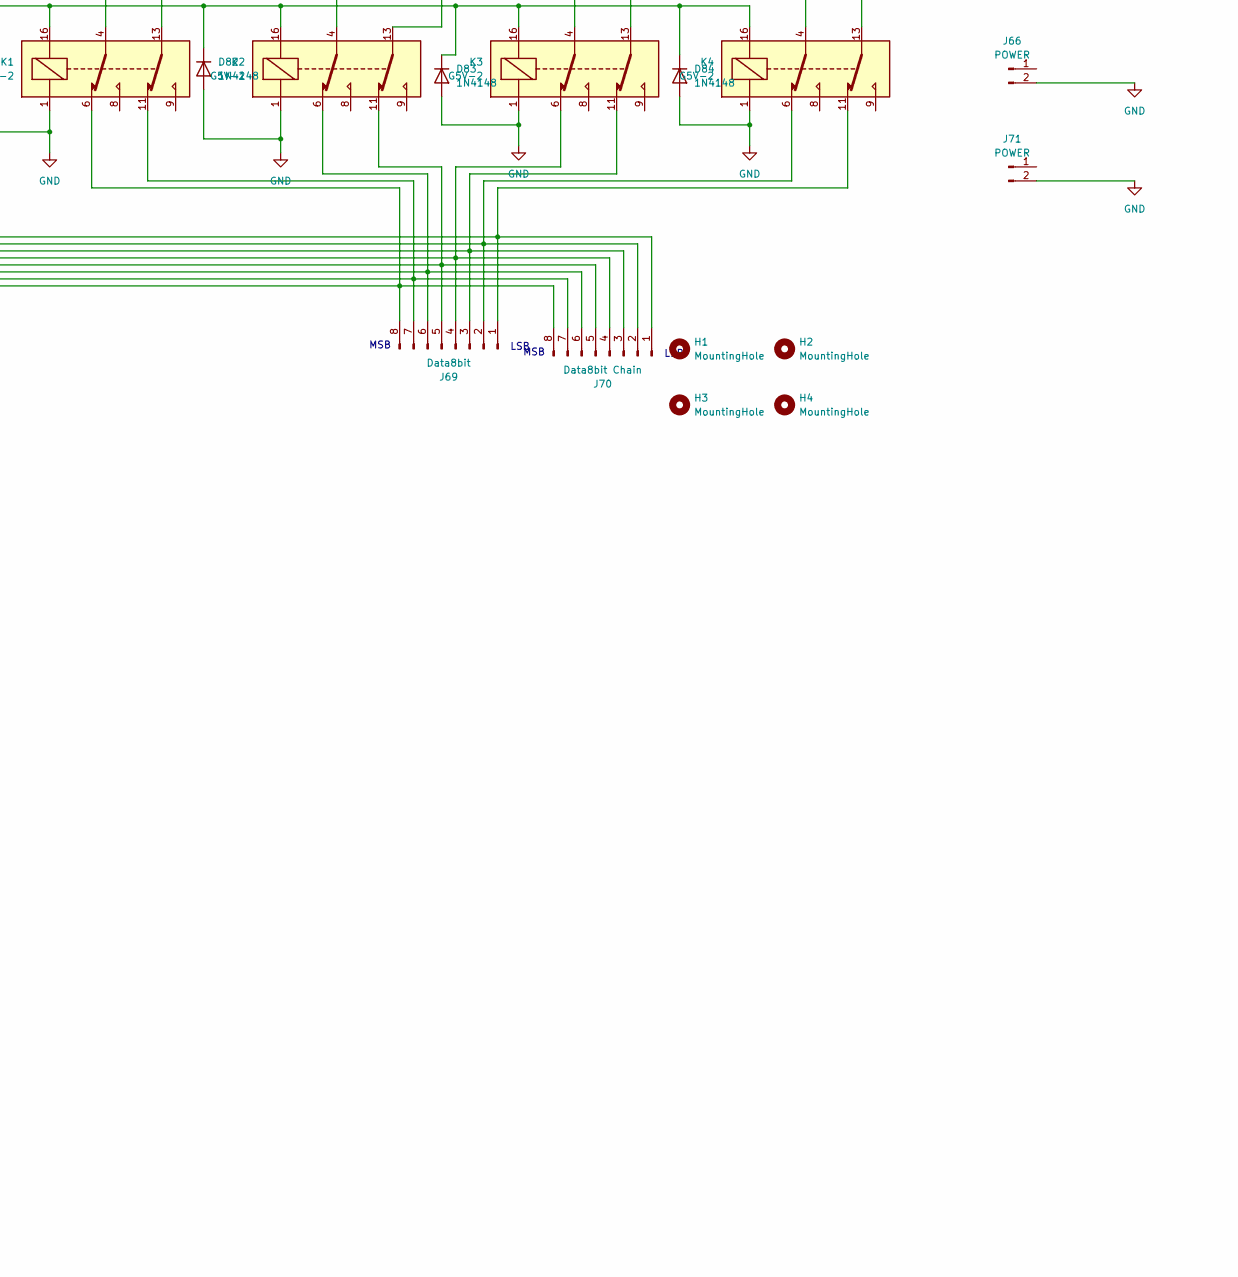
[picture p117: schematic MatrixROM.kicad_sch, part in row 2, column 2]

Parts:
D1, D2, D3, D4, D5, D6, D7, D8, D9, D10, D11, D12, D13, D14, D15, D16, D17, D18, D19, D20, D21, D22, D23, D24, D25, D26, D27, D28, D29, D30, D31, D32, D33, D34, D35, D36, D37, D38, D39, D40, D41, D42, D43, D44, D45, D46, D47, D48, D49, D50, D51, D52, D53, D54, D55, D56, D57, D58, D59, D60, D61, D62, D63, D64, D81, D82, D83, D84: 1N4148; D_DO-35_SOD27_P7.62mm_Horizontal
D65, D66, D67, D68, D69, D70, D71, D72, D73, D74, D75, D76, D77, D78, D79, D80: LED; LED_D5.0mm
H1, H2, H3, H4: MountingHole; MountingHole_3.2mm_M3_Pad
J1, J2, J3, J4, J5, J6, J7, J8, J9, J10, J11, J12, J13, J14, J15, J16, J17, J18, J19, J20, J21, J22, J23, J24, J25, J26, J27, J28, J29, J30, J31, J32, J33, J34, J35, J36, J37, J38, J39, J40, J41, J42, J43, J44, J45, J46, J47, J48, J49, J50, J51, J52, J53, J54, J55, J56, J57, J58, J59, J60, J61, J62, J63, J64: Conn_01x02_Pin; PinHeader_1x02_P2.54mm_Vertical
J65: Enable; PinHeader_1x02_P2.54mm_Vertical
J66, J71: POWER; PinHeader_1x02_P2.54mm_Vertical
J67: Address; PinHeader_1x08_P2.54mm_Vertical
J68: Address Chain; PinHeader_1x08_P2.54mm_Vertical
J69: Data8bit; PinHeader_1x08_P2.54mm_Vertical
J70: Data8bit Chain; PinHeader_1x08_P2.54mm_Vertical
K1, K2, K3, K4: G5V-2; Relay_DPDT_Omron_G5V-2
R1, R2, R3, R4, R5, R6, R7, R8, R9, R10, R11, R12, R13, R14, R15, R16: R; R_Axial_DIN0207_L6.3mm_D2.5mm_P10.16mm_Horizontal

Connections:
GND: D65.1 (K), D66.1 (K), D67.1 (K), D68.1 (K), D69.1 (K), D70.1 (K), D71.1 (K), D72.1 (K), D73.1 (K), D74.1 (K), D75.1 (K), D76.1 (K), D77.1 (K), D78.1 (K), D79.1 (K), D80.1 (K), D81.2 (A), D82.2 (A), D83.2 (A), D84.2 (A), J66.2, J71.2, K1.1, K2.1, K3.1, K4.1
unnamed: D1.2 (A), J1.2
unnamed: D1.1 (K), D9.1 (K), D17.1 (K), D25.1 (K), D33.1 (K), D41.1 (K), D49.1 (K), D57.1 (K), K1.4
unnamed: D2.2 (A), J2.2
unnamed: D3.2 (A), J3.2
unnamed: D4.2 (A), J4.2
unnamed: D5.2 (A), J5.2
unnamed: D6.2 (A), J6.2
unnamed: D7.2 (A), J7.2
unnamed: D8.2 (A), J8.2
unnamed: D9.2 (A), J9.2
unnamed: D10.2 (A), J10.2
unnamed: D2.1 (K), D10.1 (K), D18.1 (K), D26.1 (K), D34.1 (K), D42.1 (K), D50.1 (K), D58.1 (K), K1.13
unnamed: D11.2 (A), J11.2
unnamed: D3.1 (K), D11.1 (K), D19.1 (K), D27.1 (K), D35.1 (K), D43.1 (K), D51.1 (K), D59.1 (K), K2.4
unnamed: D12.2 (A), J12.2
unnamed: D4.1 (K), D12.1 (K), D20.1 (K), D28.1 (K), D36.1 (K), D44.1 (K), D52.1 (K), D60.1 (K), K2.13
unnamed: D13.2 (A), J13.2
unnamed: D5.1 (K), D13.1 (K), D21.1 (K), D29.1 (K), D37.1 (K), D45.1 (K), D53.1 (K), D61.1 (K), K3.4
unnamed: D14.2 (A), J14.2
unnamed: D6.1 (K), D14.1 (K), D22.1 (K), D30.1 (K), D38.1 (K), D46.1 (K), D54.1 (K), D62.1 (K), K3.13
unnamed: D15.2 (A), J15.2
unnamed: D7.1 (K), D15.1 (K), D23.1 (K), D31.1 (K), D39.1 (K), D47.1 (K), D55.1 (K), D63.1 (K), K4.4
unnamed: D16.2 (A), J16.2
unnamed: D8.1 (K), D16.1 (K), D24.1 (K), D32.1 (K), D40.1 (K), D48.1 (K), D56.1 (K), D64.1 (K), K4.13
unnamed: D17.2 (A), J17.2
unnamed: D18.2 (A), J18.2
unnamed: D19.2 (A), J19.2
unnamed: D20.2 (A), J20.2
unnamed: D21.2 (A), J21.2
unnamed: D22.2 (A), J22.2
unnamed: D23.2 (A), J23.2
unnamed: D24.2 (A), J24.2
unnamed: D25.2 (A), J25.2
unnamed: D26.2 (A), J26.2
unnamed: D27.2 (A), J27.2
unnamed: D28.2 (A), J28.2
unnamed: D29.2 (A), J29.2
unnamed: D30.2 (A), J30.2
unnamed: D31.2 (A), J31.2
unnamed: D32.2 (A), J32.2
unnamed: D33.2 (A), J33.2
unnamed: D34.2 (A), J34.2
unnamed: D35.2 (A), J35.2
unnamed: D36.2 (A), J36.2
unnamed: D37.2 (A), J37.2
unnamed: D38.2 (A), J38.2
unnamed: D39.2 (A), J39.2
unnamed: D40.2 (A), J40.2
unnamed: D41.2 (A), J41.2
unnamed: D42.2 (A), J42.2
unnamed: D43.2 (A), J43.2
unnamed: D44.2 (A), J44.2
unnamed: D45.2 (A), J45.2
unnamed: D46.2 (A), J46.2
unnamed: D47.2 (A), J47.2
unnamed: D48.2 (A), J48.2
unnamed: D49.2 (A), J49.2
unnamed: D50.2 (A), J50.2
unnamed: D51.2 (A), J51.2
unnamed: D52.2 (A), J52.2
unnamed: D53.2 (A), J53.2
unnamed: D54.2 (A), J54.2
unnamed: D55.2 (A), J55.2
unnamed: D56.2 (A), J56.2
unnamed: D57.2 (A), J57.2
unnamed: D58.2 (A), J58.2
unnamed: D59.2 (A), J59.2
unnamed: D60.2 (A), J60.2
unnamed: D61.2 (A), J61.2
unnamed: D62.2 (A), J62.2
unnamed: D63.2 (A), J63.2
unnamed: D64.2 (A), J64.2
unnamed: D65.2 (A), R1.1
unnamed: D66.2 (A), R2.1
unnamed: D67.2 (A), R3.1
unnamed: D68.2 (A), R4.1
unnamed: D69.2 (A), R5.1
unnamed: D70.2 (A), R6.1
unnamed: D71.2 (A), R7.1
unnamed: D72.2 (A), R8.1
unnamed: D73.2 (A), R9.1
unnamed: D74.2 (A), R10.1
unnamed: D75.2 (A), R11.1
unnamed: D76.2 (A), R12.1
unnamed: D77.2 (A), R13.1
unnamed: D78.2 (A), R14.1
unnamed: D79.2 (A), R15.1
unnamed: D80.2 (A), R16.1
unnamed: D81.1 (K), D82.1 (K), D83.1 (K), D84.1 (K), J65.1, J65.2, K1.16, K2.16, K3.16, K4.16
unnamed: J1.1, J2.1, J3.1, J4.1, J5.1, J6.1, J7.1, J8.1, J67.1, J68.1, R9.2
unnamed: J9.1, J10.1, J11.1, J12.1, J13.1, J14.1, J15.1, J16.1, J67.2, J68.2, R10.2
unnamed: J17.1, J18.1, J19.1, J20.1, J21.1, J22.1, J23.1, J24.1, J67.3, J68.3, R11.2
unnamed: J25.1, J26.1, J27.1, J28.1, J29.1, J30.1, J31.1, J32.1, J67.4, J68.4, R12.2
unnamed: J33.1, J34.1, J35.1, J36.1, J37.1, J38.1, J39.1, J40.1, J67.5, J68.5, R13.2
unnamed: J41.1, J42.1, J43.1, J44.1, J45.1, J46.1, J47.1, J48.1, J67.6, J68.6, R14.2
unnamed: J49.1, J50.1, J51.1, J52.1, J53.1, J54.1, J55.1, J56.1, J67.7, J68.7, R15.2
unnamed: J57.1, J58.1, J59.1, J60.1, J61.1, J62.1, J63.1, J64.1, J67.8, J68.8, R16.2
unnamed: J69.1, J70.1, K4.11, R1.2
unnamed: J69.2, J70.2, K4.6, R2.2
unnamed: J69.3, J70.3, K3.11, R3.2
unnamed: J69.4, J70.4, K3.6, R4.2
unnamed: J69.5, J70.5, K2.11, R5.2
unnamed: J69.6, J70.6, K2.6, R6.2
unnamed: J69.7, J70.7, K1.11, R7.2
unnamed: J69.8, J70.8, K1.6, R8.2

Notes on the sheet:
MSB
LSB

Board: 2 copper layers, 179 parts (16 on the bottom side), 106 nets, no tracks yet.
