RadeonHD6750/Relay4bitComputer/Bus-Interface-Unit/Bus-Interface-Unit.kicad_pcb

## KiCad design Bus-Interface-Unit/Bus-Interface-Unit.kicad_pcb (2026-06-11)

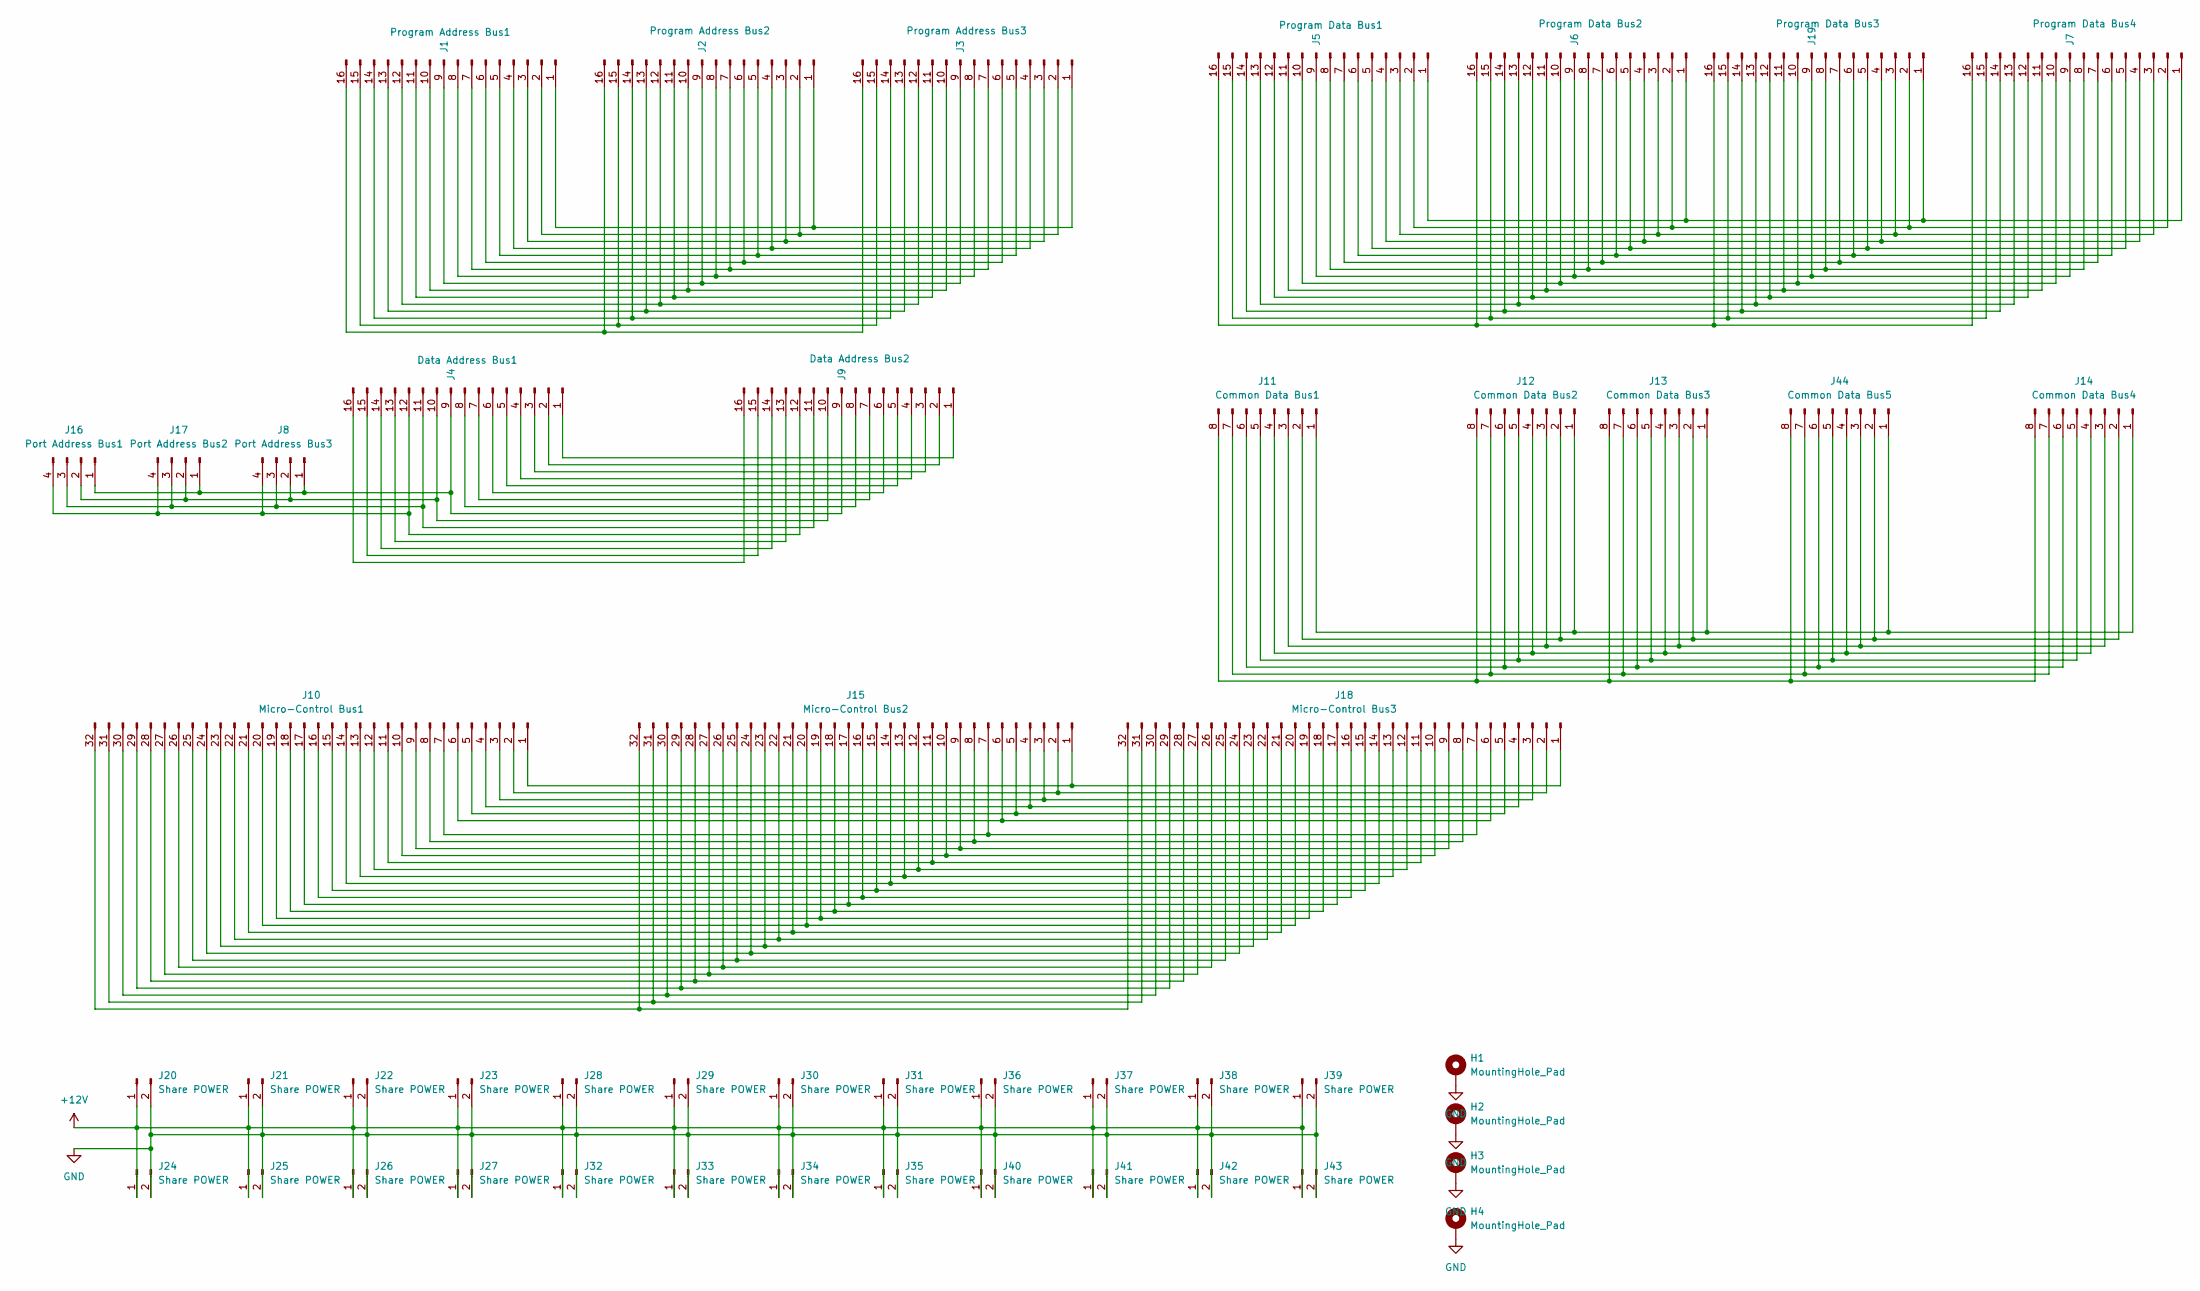
[picture p118: schematic Bus-Interface-Unit.kicad_sch]

Parts:
H1, H2, H3, H4: MountingHole_Pad; MountingHole_3.2mm_M3_Pad
J1: Program Address Bus1; PinHeader_1x16_P2.54mm_Vertical
J2: Program Address Bus2; PinHeader_1x16_P2.54mm_Vertical
J3: Program Address Bus3; PinHeader_1x16_P2.54mm_Vertical
J4: Data Address Bus1; PinHeader_1x16_P2.54mm_Vertical
J5: Program Data Bus1; PinHeader_1x16_P2.54mm_Vertical
J6: Program Data Bus2; PinHeader_1x16_P2.54mm_Vertical
J7: Program Data Bus4; PinHeader_1x16_P2.54mm_Vertical
J8: Port Address Bus3; PinHeader_1x04_P2.54mm_Vertical
J9: Data Address Bus2; PinHeader_1x16_P2.54mm_Vertical
J10: Micro-Control Bus1; PinHeader_1x32_P2.54mm_Vertical
J11: Common Data Bus1; PinHeader_1x08_P2.54mm_Vertical
J12: Common Data Bus2; PinHeader_1x08_P2.54mm_Vertical
J13: Common Data Bus3; PinHeader_1x08_P2.54mm_Vertical
J14: Common Data Bus4; PinHeader_1x08_P2.54mm_Vertical
J15: Micro-Control Bus2; PinHeader_1x32_P2.54mm_Vertical
J16: Port Address Bus1; PinHeader_1x04_P2.54mm_Vertical
J17: Port Address Bus2; PinHeader_1x04_P2.54mm_Vertical
J18: Micro-Control Bus3; PinHeader_1x32_P2.54mm_Vertical
J19: Program Data Bus3; PinHeader_1x16_P2.54mm_Vertical
J20, J21, J22, J23, J24, J25, J26, J27, J28, J29, J30, J31, J32, J33, J34, J35, J36, J37, J38, J39, J40, J41, J42, J43: Share POWER; PinHeader_1x02_P2.54mm_Vertical
J44: Common Data Bus5; PinHeader_1x08_P2.54mm_Vertical

Connections:
+12V: J20.1, J21.1, J22.1, J23.1, J24.1, J25.1, J26.1, J27.1, J28.1, J29.1, J30.1, J31.1, J32.1, J33.1, J34.1, J35.1, J36.1, J37.1, J38.1, J39.1, J40.1, J41.1, J42.1, J43.1
GND: H1.1, H2.1, H3.1, H4.1, J20.2, J21.2, J22.2, J23.2, J24.2, J25.2, J26.2, J27.2, J28.2, J29.2, J30.2, J31.2, J32.2, J33.2, J34.2, J35.2, J36.2, J37.2, J38.2, J39.2, J40.2, J41.2, J42.2, J43.2
unnamed: J1.1, J2.1, J3.1
unnamed: J1.2, J2.2, J3.2
unnamed: J1.3, J2.3, J3.3
unnamed: J1.4, J2.4, J3.4
unnamed: J1.5, J2.5, J3.5
unnamed: J1.6, J2.6, J3.6
unnamed: J1.7, J2.7, J3.7
unnamed: J1.8, J2.8, J3.8
unnamed: J1.9, J2.9, J3.9
unnamed: J1.10, J2.10, J3.10
unnamed: J1.11, J2.11, J3.11
unnamed: J1.12, J2.12, J3.12
unnamed: J1.13, J2.13, J3.13
unnamed: J1.14, J2.14, J3.14
unnamed: J1.15, J2.15, J3.15
unnamed: J1.16, J2.16, J3.16
unnamed: J4.1, J9.1
unnamed: J4.2, J9.2
unnamed: J4.3, J9.3
unnamed: J4.4, J9.4
unnamed: J4.5, J9.5
unnamed: J4.6, J9.6
unnamed: J4.7, J9.7
unnamed: J4.8, J9.8
unnamed: J4.13, J9.13
unnamed: J4.14, J9.14
unnamed: J4.15, J9.15
unnamed: J4.16, J9.16
unnamed: J10.1, J15.1, J18.1
unnamed: J10.2, J15.2, J18.2
unnamed: J10.3, J15.3, J18.3
unnamed: J10.4, J15.4, J18.4
unnamed: J10.5, J15.5, J18.5
unnamed: J10.6, J15.6, J18.6
unnamed: J10.7, J15.7, J18.7
unnamed: J10.8, J15.8, J18.8
unnamed: J10.9, J15.9, J18.9
unnamed: J10.10, J15.10, J18.10
unnamed: J10.11, J15.11, J18.11
unnamed: J10.12, J15.12, J18.12
unnamed: J10.13, J15.13, J18.13
unnamed: J10.14, J15.14, J18.14
unnamed: J10.15, J15.15, J18.15
unnamed: J10.16, J15.16, J18.16
unnamed: J10.17, J15.17, J18.17
unnamed: J10.18, J15.18, J18.18
unnamed: J10.19, J15.19, J18.19
unnamed: J10.20, J15.20, J18.20
unnamed: J10.21, J15.21, J18.21
unnamed: J10.22, J15.22, J18.22
unnamed: J10.23, J15.23, J18.23
unnamed: J10.24, J15.24, J18.24
unnamed: J10.25, J15.25, J18.25
unnamed: J10.26, J15.26, J18.26
unnamed: J10.27, J15.27, J18.27
unnamed: J10.28, J15.28, J18.28
unnamed: J10.29, J15.29, J18.29
unnamed: J10.30, J15.30, J18.30
unnamed: J10.31, J15.31, J18.31
unnamed: J10.32, J15.32, J18.32
unnamed: J11.1, J12.1, J13.1, J14.1, J44.1
unnamed: J11.2, J12.2, J13.2, J14.2, J44.2
unnamed: J11.3, J12.3, J13.3, J14.3, J44.3
unnamed: J11.4, J12.4, J13.4, J14.4, J44.4
unnamed: J11.5, J12.5, J13.5, J14.5, J44.5
unnamed: J11.6, J12.6, J13.6, J14.6, J44.6
unnamed: J11.7, J12.7, J13.7, J14.7, J44.7
unnamed: J11.8, J12.8, J13.8, J14.8, J44.8
unnamed: J4.9, J8.1, J9.9, J16.1, J17.1
unnamed: J4.10, J8.2, J9.10, J16.2, J17.2
unnamed: J4.11, J8.3, J9.11, J16.3, J17.3
unnamed: J4.12, J8.4, J9.12, J16.4, J17.4
unnamed: J5.1, J6.1, J7.1, J19.1
unnamed: J5.2, J6.2, J7.2, J19.2
unnamed: J5.3, J6.3, J7.3, J19.3
unnamed: J5.4, J6.4, J7.4, J19.4
unnamed: J5.5, J6.5, J7.5, J19.5
unnamed: J5.6, J6.6, J7.6, J19.6
unnamed: J5.7, J6.7, J7.7, J19.7
unnamed: J5.8, J6.8, J7.8, J19.8
unnamed: J5.9, J6.9, J7.9, J19.9
unnamed: J5.10, J6.10, J7.10, J19.10
unnamed: J5.11, J6.11, J7.11, J19.11
unnamed: J5.12, J6.12, J7.12, J19.12
unnamed: J5.13, J6.13, J7.13, J19.13
unnamed: J5.14, J6.14, J7.14, J19.14
unnamed: J5.15, J6.15, J7.15, J19.15
unnamed: J5.16, J6.16, J7.16, J19.16

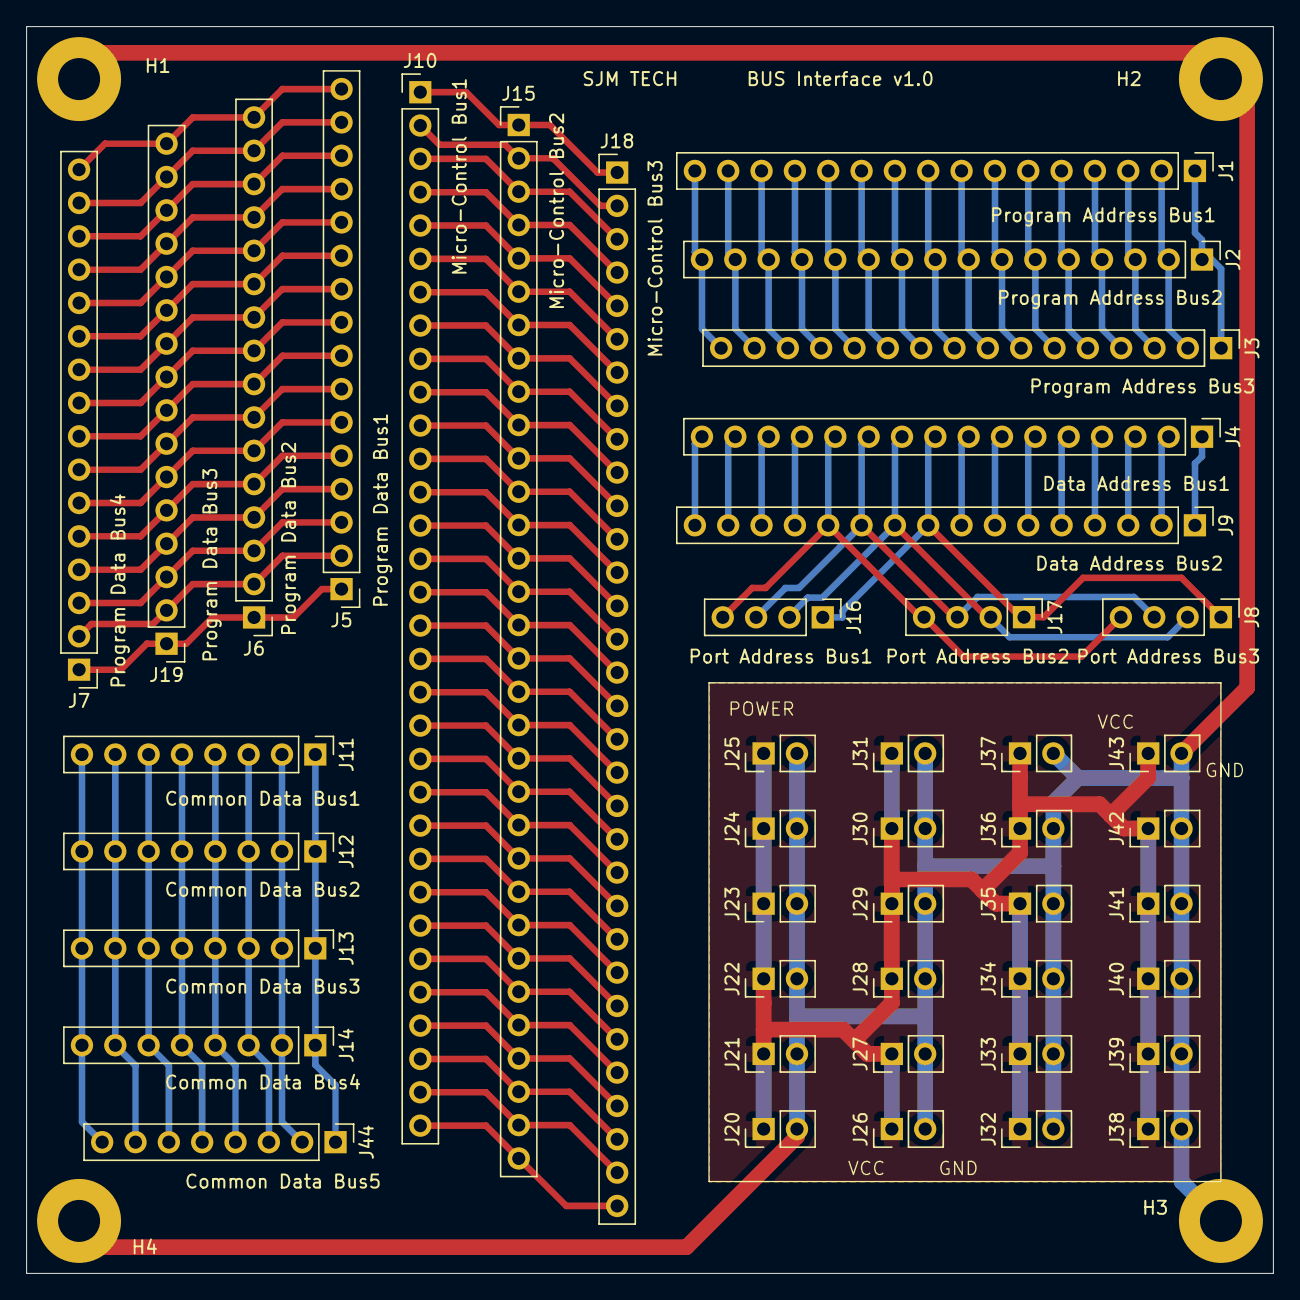
[picture p119: board Bus-Interface-Unit.kicad_pcb from above]

Board: 2 copper layers, 95.0 x 95.0 mm, 48 parts (0 on the bottom side), 90 nets.
