RadeonHD6750/Relay4bitComputer/Arithmetic-Unit/Arithmetic-Unit.kicad_pcb

## KiCad design Arithmetic-Unit/Arithmetic-Unit.kicad_pcb (2026-06-11)

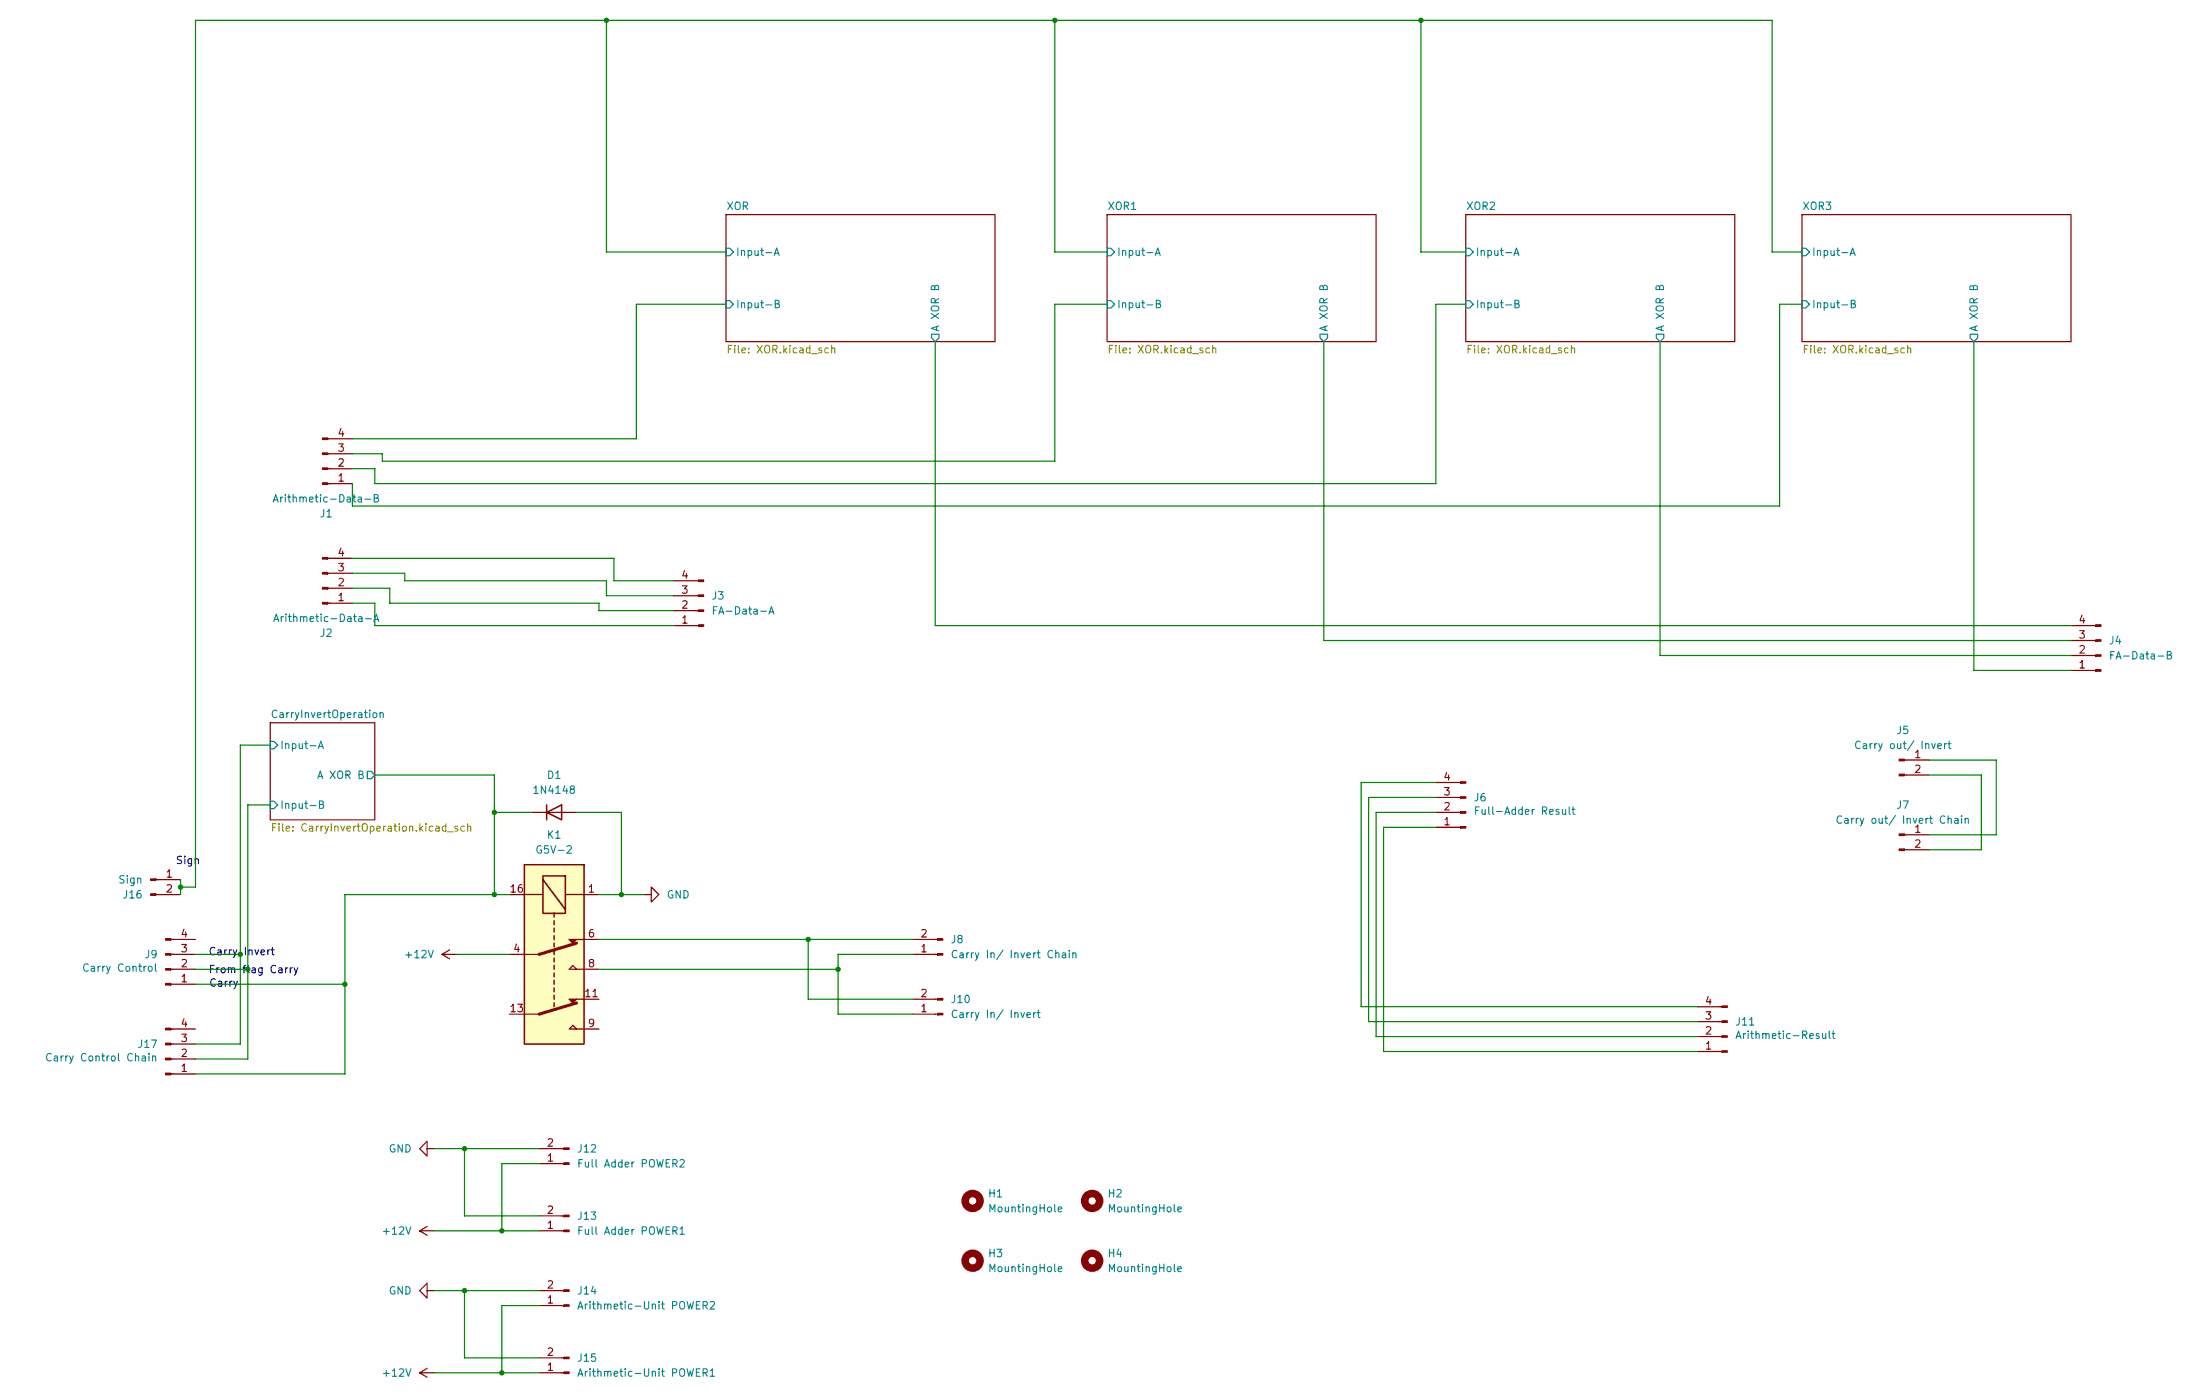
[picture p120: schematic Arithmetic-Unit.kicad_sch]

Parts:
D1: 1N4148; D_DO-35_SOD27_P7.62mm_Horizontal
H1, H2, H3, H4: MountingHole; MountingHole_3.2mm_M3_Pad
J1: Arithmetic-Data-B; PinHeader_1x04_P2.54mm_Vertical
J2: Arithmetic-Data-A; PinHeader_1x04_P2.54mm_Vertical
J3: FA-Data-A; PinHeader_1x04_P2.54mm_Vertical
J4: FA-Data-B; PinHeader_1x04_P2.54mm_Vertical
J5: Carry out/ Invert; PinHeader_1x02_P2.54mm_Vertical
J6: Full-Adder Result; PinHeader_1x04_P2.54mm_Vertical
J7: Carry out/ Invert Chain; PinHeader_1x02_P2.54mm_Vertical
J8: Carry In/ Invert Chain; PinHeader_1x02_P2.54mm_Vertical
J9: Carry Control; PinHeader_1x04_P2.54mm_Vertical
J10: Carry In/ Invert; PinHeader_1x02_P2.54mm_Vertical
J11: Arithmetic-Result; PinHeader_1x04_P2.54mm_Vertical
J12: Full Adder POWER2; PinHeader_1x02_P2.54mm_Vertical
J13: Full Adder POWER1; PinHeader_1x02_P2.54mm_Vertical
J14: Arithmetic-Unit POWER2; PinHeader_1x02_P2.54mm_Vertical
J15: Arithmetic-Unit POWER1; PinHeader_1x02_P2.54mm_Vertical
J16: Sign; PinHeader_1x02_P2.54mm_Vertical
J17: Carry Control Chain; PinHeader_1x04_P2.54mm_Vertical
K1: G5V-2; Relay_DPDT_Omron_G5V-2

Connections:
+12V: J12.1, J13.1, J14.1, J15.1, K1.4; also elsewhere on the board
/CarryInvertOperation/A XOR B: D1.1 (K), J9.1, J17.1, K1.16; also elsewhere on the board
/CarryInvertOperation/Input-A: J9.3, J17.3; also elsewhere on the board
/CarryInvertOperation/Input-B: J9.2, J17.2; also elsewhere on the board
/XOR1/A XOR B: J4.3; also elsewhere on the board
/XOR1/Input-B: J1.3; also elsewhere on the board
/XOR2/A XOR B: J4.2; also elsewhere on the board
/XOR2/Input-B: J1.2; also elsewhere on the board
/XOR3/A XOR B: J4.1; also elsewhere on the board
/XOR3/Input-B: J1.1; also elsewhere on the board
/XOR/A XOR B: J4.4; also elsewhere on the board
/XOR/Input-A: J16.1, J16.2; also elsewhere on the board
/XOR/Input-B: J1.4; also elsewhere on the board
GND: D1.2 (A), J12.2, J13.2, J14.2, J15.2, K1.1; also elsewhere on the board
unnamed: J2.1, J3.1
unnamed: J2.2, J3.2
unnamed: J2.3, J3.3
unnamed: J2.4, J3.4
unnamed: J5.1, J7.1
unnamed: J5.2, J7.2
unnamed: J8.1, J10.1, K1.8
unnamed: J8.2, J10.2, K1.6
unnamed: J6.1, J11.1
unnamed: J6.2, J11.2
unnamed: J6.3, J11.3
unnamed: J6.4, J11.4

Notes on the sheet:
From flag Carry
Carry Invert
Carry
Sign
