RadeonHD6750/Relay4bitComputer/Arithmetic-Unit/Arithmetic-Unit.kicad_pcb

## KiCad design Arithmetic-Unit/Arithmetic-Unit.kicad_pcb (continued)

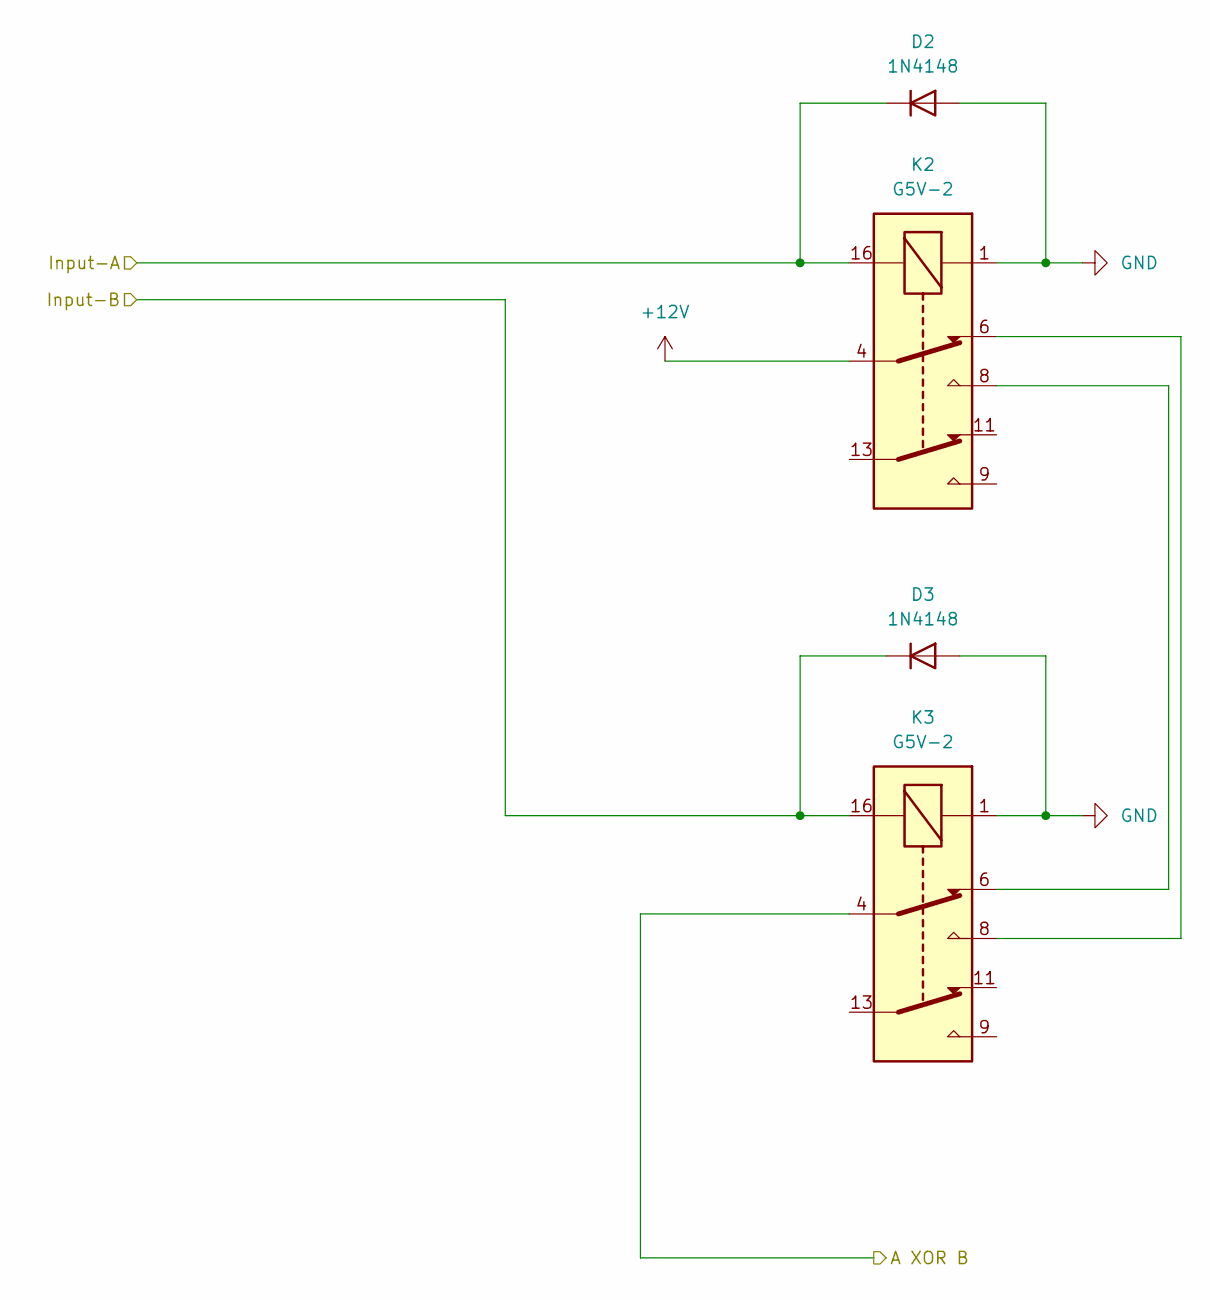
[picture p121: schematic XOR.kicad_sch]

Parts:
D2, D3: 1N4148; D_DO-35_SOD27_P7.62mm_Horizontal
K2, K3: G5V-2; Relay_DPDT_Omron_G5V-2

Connections:
+12V: K2.4; also elsewhere on the board
/XOR/A XOR B: K3.4; also elsewhere on the board
/XOR/Input-A: D2.1 (K), K2.16; also elsewhere on the board
/XOR/Input-B: D3.1 (K), K3.16; also elsewhere on the board
GND: D2.2 (A), D3.2 (A), K2.1, K3.1; also elsewhere on the board
unnamed: K2.6, K3.8
unnamed: K2.8, K3.6

Parts of its further copies:
D4, D5, D6, D7, D8, D9: 1N4148; D_DO-35_SOD27_P7.62mm_Horizontal
K4, K5, K6, K7, K8, K9: G5V-2; Relay_DPDT_Omron_G5V-2

Connections of its further copies:
+12V: K4.4, K6.4, K8.4; also elsewhere on the board
/XOR1/A XOR B: K5.4; also elsewhere on the board
/XOR1/Input-B: D5.1 (K), K5.16; also elsewhere on the board
/XOR2/A XOR B: K7.4; also elsewhere on the board
/XOR2/Input-B: D7.1 (K), K7.16; also elsewhere on the board
/XOR3/A XOR B: K9.4; also elsewhere on the board
/XOR3/Input-B: D9.1 (K), K9.16; also elsewhere on the board
/XOR/Input-A: D4.1 (K), D6.1 (K), D8.1 (K), K4.16, K6.16, K8.16; also elsewhere on the board
GND: D4.2 (A), D5.2 (A), D6.2 (A), D7.2 (A), D8.2 (A), D9.2 (A), K4.1, K5.1, K6.1, K7.1, K8.1, K9.1; also elsewhere on the board
unnamed: K4.6, K5.8
unnamed: K4.8, K5.6
unnamed: K6.6, K7.8
unnamed: K6.8, K7.6
unnamed: K8.6, K9.8
unnamed: K8.8, K9.6

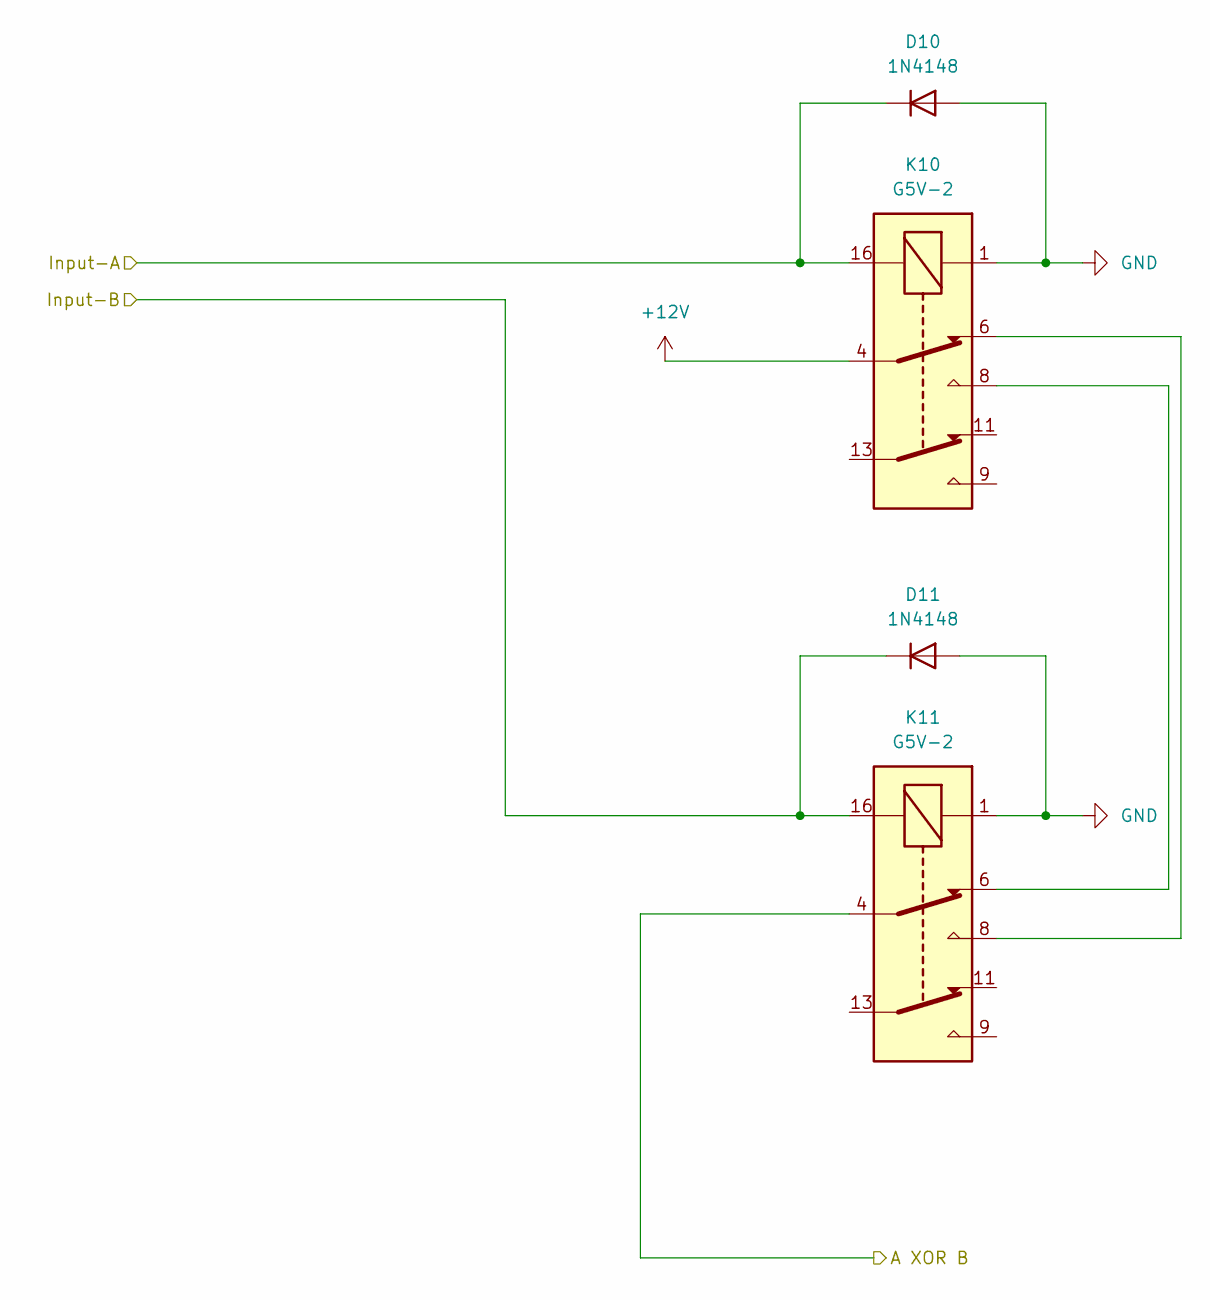
[picture p122: schematic CarryInvertOperation.kicad_sch]

Parts:
D10, D11: 1N4148; D_DO-35_SOD27_P7.62mm_Horizontal
K10, K11: G5V-2; Relay_DPDT_Omron_G5V-2

Connections:
+12V: K10.4; also elsewhere on the board
/CarryInvertOperation/A XOR B: K11.4; also elsewhere on the board
/CarryInvertOperation/Input-A: D10.1 (K), K10.16; also elsewhere on the board
/CarryInvertOperation/Input-B: D11.1 (K), K11.16; also elsewhere on the board
GND: D10.2 (A), D11.2 (A), K10.1, K11.1; also elsewhere on the board
unnamed: K10.6, K11.8
unnamed: K10.8, K11.6

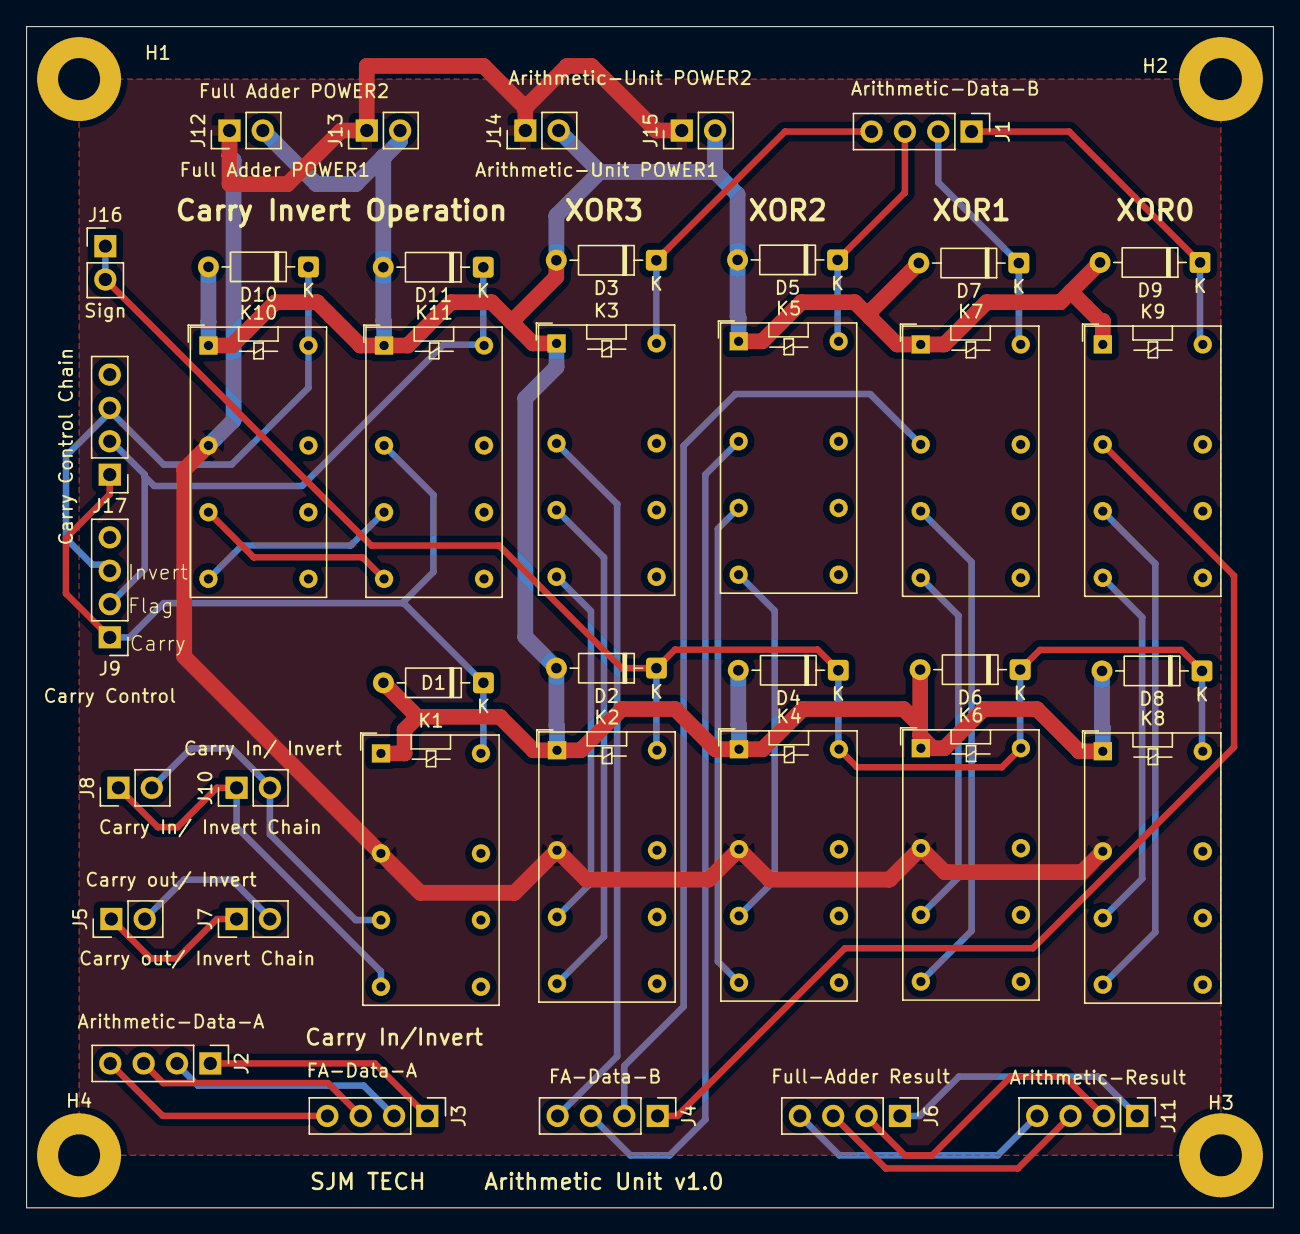
[picture p123: board Arithmetic-Unit.kicad_pcb from above]

Board: 2 copper layers, 95.0 x 90.0 mm, 43 parts (0 on the bottom side), 36 nets.
