RadeonHD6750/Relay4bitComputer/ALU/ALU.kicad_pcb

## KiCad design ALU/ALU.kicad_pcb (2026-06-11)

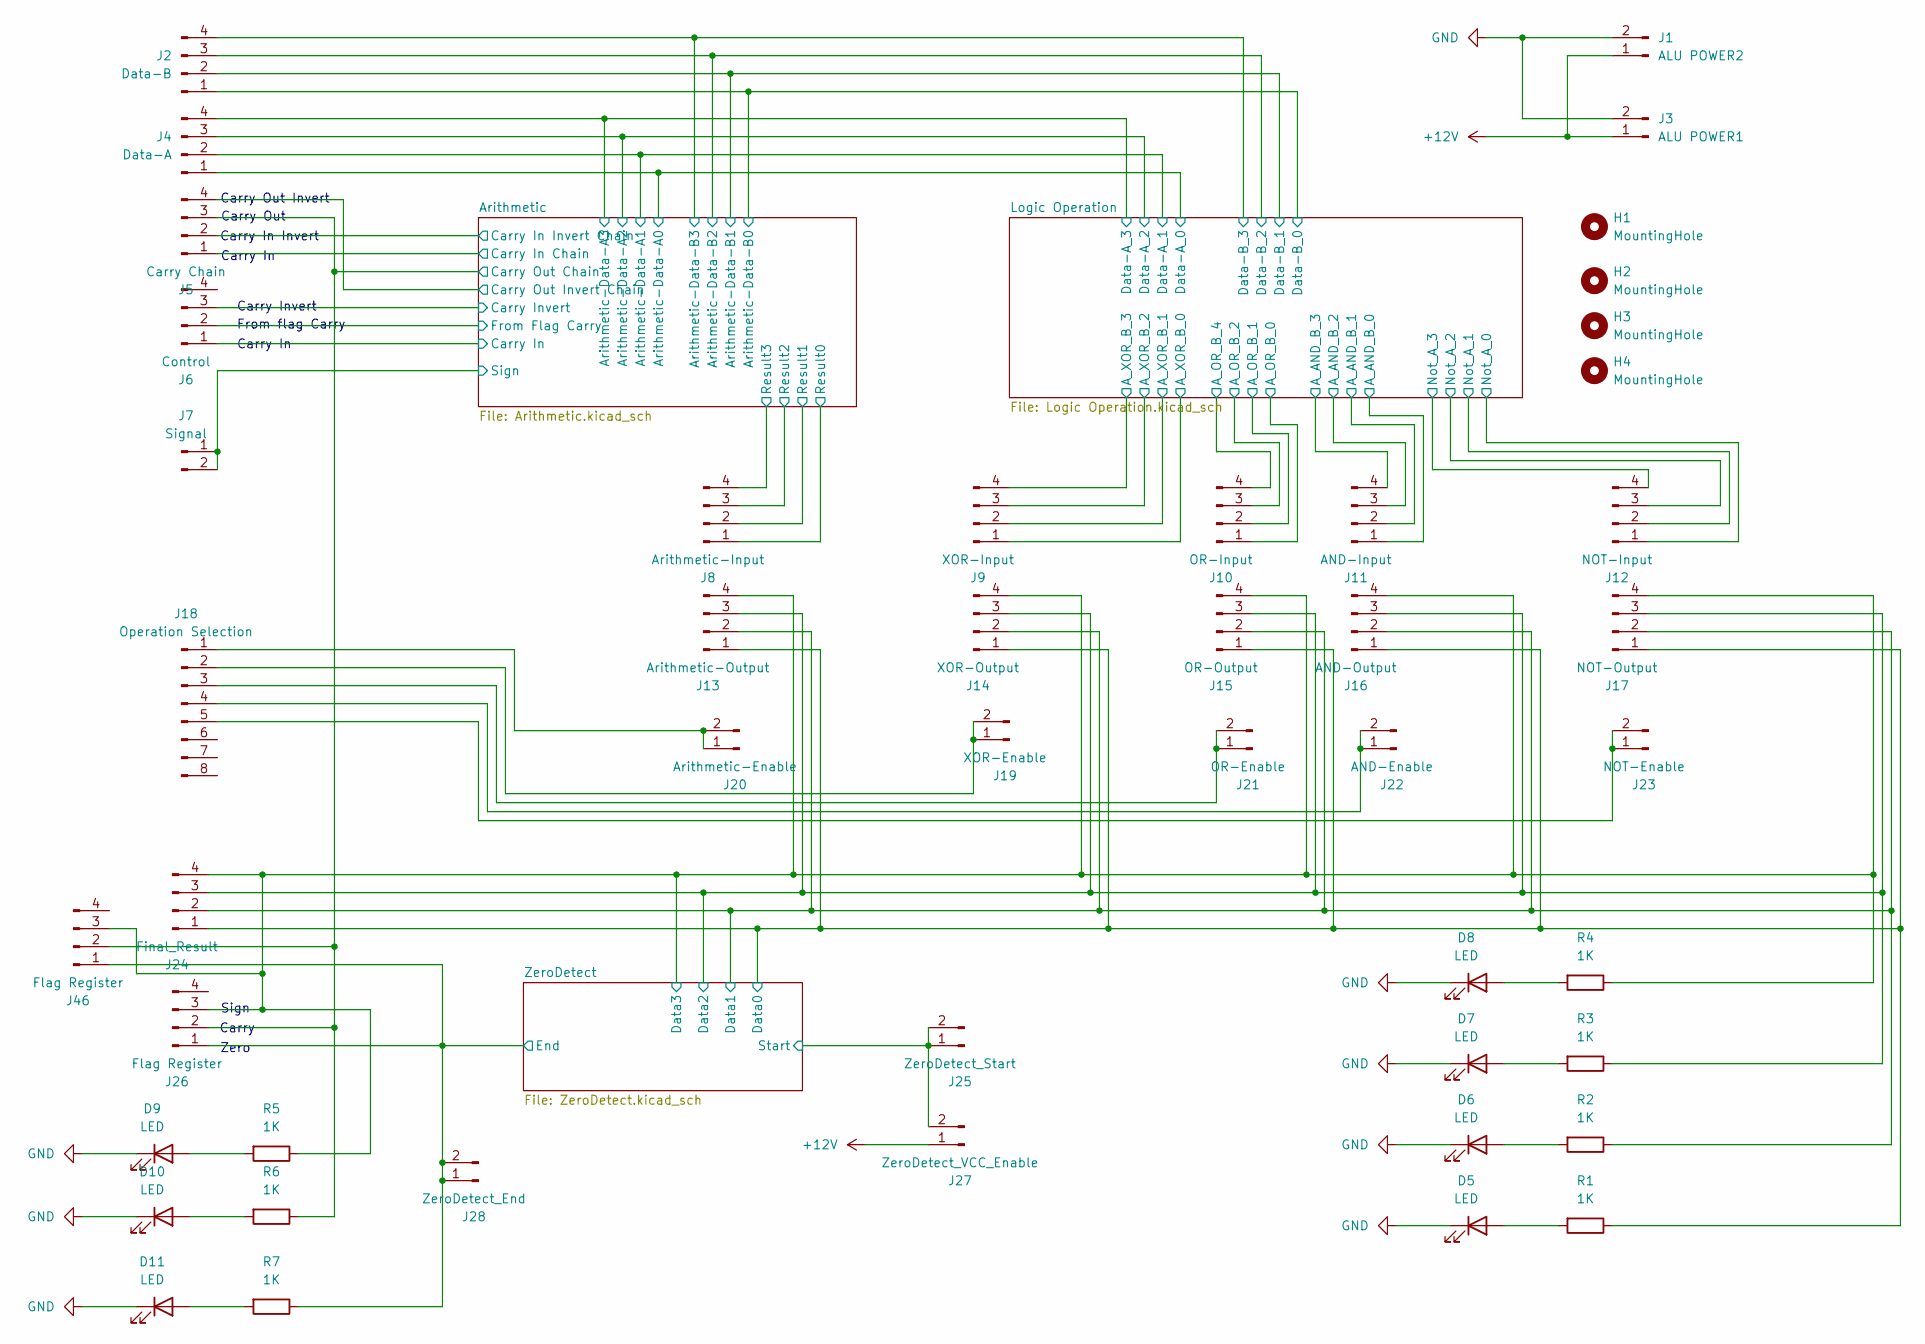
[picture p124: schematic ALU.kicad_sch]

Parts:
D5, D6, D7, D8, D9, D10, D11: LED; LED_D5.0mm
H1, H2, H3, H4: MountingHole; MountingHole_3.2mm_M3_Pad
J1: ALU POWER2; PinHeader_1x02_P2.54mm_Vertical
J2: Data-B; PinHeader_1x04_P2.54mm_Vertical
J3: ALU POWER1; PinHeader_1x02_P2.54mm_Vertical
J4: Data-A; PinHeader_1x04_P2.54mm_Vertical
J5: Carry Chain; PinHeader_1x04_P2.54mm_Vertical
J6: Control; PinHeader_1x04_P2.54mm_Vertical
J7: Signal; PinHeader_1x02_P2.54mm_Vertical
J8: Arithmetic-Input; PinHeader_1x04_P2.54mm_Vertical
J9: XOR-Input; PinHeader_1x04_P2.54mm_Vertical
J10: OR-Input; PinHeader_1x04_P2.54mm_Vertical
J11: AND-Input; PinHeader_1x04_P2.54mm_Vertical
J12: NOT-Input; PinHeader_1x04_P2.54mm_Vertical
J13: Arithmetic-Output; PinHeader_1x04_P2.54mm_Vertical
J14: XOR-Output; PinHeader_1x04_P2.54mm_Vertical
J15: OR-Output; PinHeader_1x04_P2.54mm_Vertical
J16: AND-Output; PinHeader_1x04_P2.54mm_Vertical
J17: NOT-Output; PinHeader_1x04_P2.54mm_Vertical
J18: Operation Selection; PinHeader_1x08_P2.54mm_Vertical
J19: XOR-Enable; PinHeader_1x02_P2.54mm_Vertical
J20: Arithmetic-Enable; PinHeader_1x02_P2.54mm_Vertical
J21: OR-Enable; PinHeader_1x02_P2.54mm_Vertical
J22: AND-Enable; PinHeader_1x02_P2.54mm_Vertical
J23: NOT-Enable; PinHeader_1x02_P2.54mm_Vertical
J24: Final_Result; PinHeader_1x04_P2.54mm_Vertical
J25: ZeroDetect_Start; PinHeader_1x02_P2.54mm_Vertical
J26, J46: Flag Register; PinHeader_1x04_P2.54mm_Vertical
J27: ZeroDetect_VCC_Enable; PinHeader_1x02_P2.54mm_Vertical
J28: ZeroDetect_End; PinHeader_1x02_P2.54mm_Vertical
R1, R2, R3, R4, R5, R6, R7: 1K; R_Axial_DIN0207_L6.3mm_D2.5mm_P10.16mm_Horizontal

Connections:
+12V: J1.1, J3.1, J27.1; also elsewhere on the board
/Arithmetic/Arithmetic-Data-A0: J4.1; also elsewhere on the board
/Arithmetic/Arithmetic-Data-A1: J4.2; also elsewhere on the board
/Arithmetic/Arithmetic-Data-A2: J4.3; also elsewhere on the board
/Arithmetic/Arithmetic-Data-A3: J4.4; also elsewhere on the board
/Arithmetic/Arithmetic-Data-B0: J2.1; also elsewhere on the board
/Arithmetic/Arithmetic-Data-B1: J2.2; also elsewhere on the board
/Arithmetic/Arithmetic-Data-B2: J2.3; also elsewhere on the board
/Arithmetic/Arithmetic-Data-B3: J2.4; also elsewhere on the board
/Arithmetic/Carry In: J6.1; also elsewhere on the board
/Arithmetic/Carry In Chain: J5.1; also elsewhere on the board
/Arithmetic/Carry In Invert Chain: J5.2; also elsewhere on the board
/Arithmetic/Carry Invert: J6.3; also elsewhere on the board
/Arithmetic/Carry Out Chain: J5.3, J26.2, J46.2, R6.1; also elsewhere on the board
/Arithmetic/Carry Out Invert Chain: J5.4; also elsewhere on the board
/Arithmetic/From Flag Carry: J6.2; also elsewhere on the board
/Arithmetic/Result0: J8.1; also elsewhere on the board
/Arithmetic/Result1: J8.2; also elsewhere on the board
/Arithmetic/Result2: J8.3; also elsewhere on the board
/Arithmetic/Result3: J8.4; also elsewhere on the board
/Arithmetic/Sign: J7.1, J7.2; also elsewhere on the board
/Logic Operation/A_AND_B_0: J11.1; also elsewhere on the board
/Logic Operation/A_AND_B_1: J11.2; also elsewhere on the board
/Logic Operation/A_AND_B_2: J11.3; also elsewhere on the board
/Logic Operation/A_AND_B_3: J11.4; also elsewhere on the board
/Logic Operation/A_OR_B_0: J10.1; also elsewhere on the board
/Logic Operation/A_OR_B_1: J10.2; also elsewhere on the board
/Logic Operation/A_OR_B_2: J10.3; also elsewhere on the board
/Logic Operation/A_OR_B_4: J10.4; also elsewhere on the board
/Logic Operation/A_XOR_B_0: J9.1; also elsewhere on the board
/Logic Operation/A_XOR_B_1: J9.2; also elsewhere on the board
/Logic Operation/A_XOR_B_2: J9.3; also elsewhere on the board
/Logic Operation/A_XOR_B_3: J9.4; also elsewhere on the board
/Logic Operation/Not_A_0: J12.1; also elsewhere on the board
/Logic Operation/Not_A_1: J12.2; also elsewhere on the board
/Logic Operation/Not_A_2: J12.3; also elsewhere on the board
/Logic Operation/Not_A_3: J12.4; also elsewhere on the board
/ZeroDetect/Data0: J13.1, J14.1, J15.1, J16.1, J17.1, J24.1, R1.1; also elsewhere on the board
/ZeroDetect/Data1: J13.2, J14.2, J15.2, J16.2, J17.2, J24.2, R2.1; also elsewhere on the board
/ZeroDetect/Data2: J13.3, J14.3, J15.3, J16.3, J17.3, J24.3, R3.1; also elsewhere on the board
/ZeroDetect/Data3: J13.4, J14.4, J15.4, J16.4, J17.4, J24.4, J26.3, J46.3, R4.1, R5.1; also elsewhere on the board
/ZeroDetect/End: J26.1, J28.1, J28.2, J46.1, R7.1; also elsewhere on the board
/ZeroDetect/Start: J25.1, J25.2, J27.2; also elsewhere on the board
GND: D5.1 (K), D6.1 (K), D7.1 (K), D8.1 (K), D9.1 (K), D10.1 (K), D11.1 (K), J1.2, J3.2; also elsewhere on the board
unnamed: D5.2 (A), R1.2
unnamed: D6.2 (A), R2.2
unnamed: D7.2 (A), R3.2
unnamed: D8.2 (A), R4.2
unnamed: D9.2 (A), R5.2
unnamed: D10.2 (A), R6.2
unnamed: D11.2 (A), R7.2
unnamed: J18.1, J20.1, J20.2
unnamed: J18.2, J19.1, J19.2
unnamed: J18.3, J21.1, J21.2
unnamed: J18.4, J22.1, J22.2
unnamed: J18.5, J23.1, J23.2

Notes on the sheet:
Carry In
Sign
Carry
From flag Carry
Carry In Invert
Zero
Carry Out
Carry Out Invert
Carry Invert

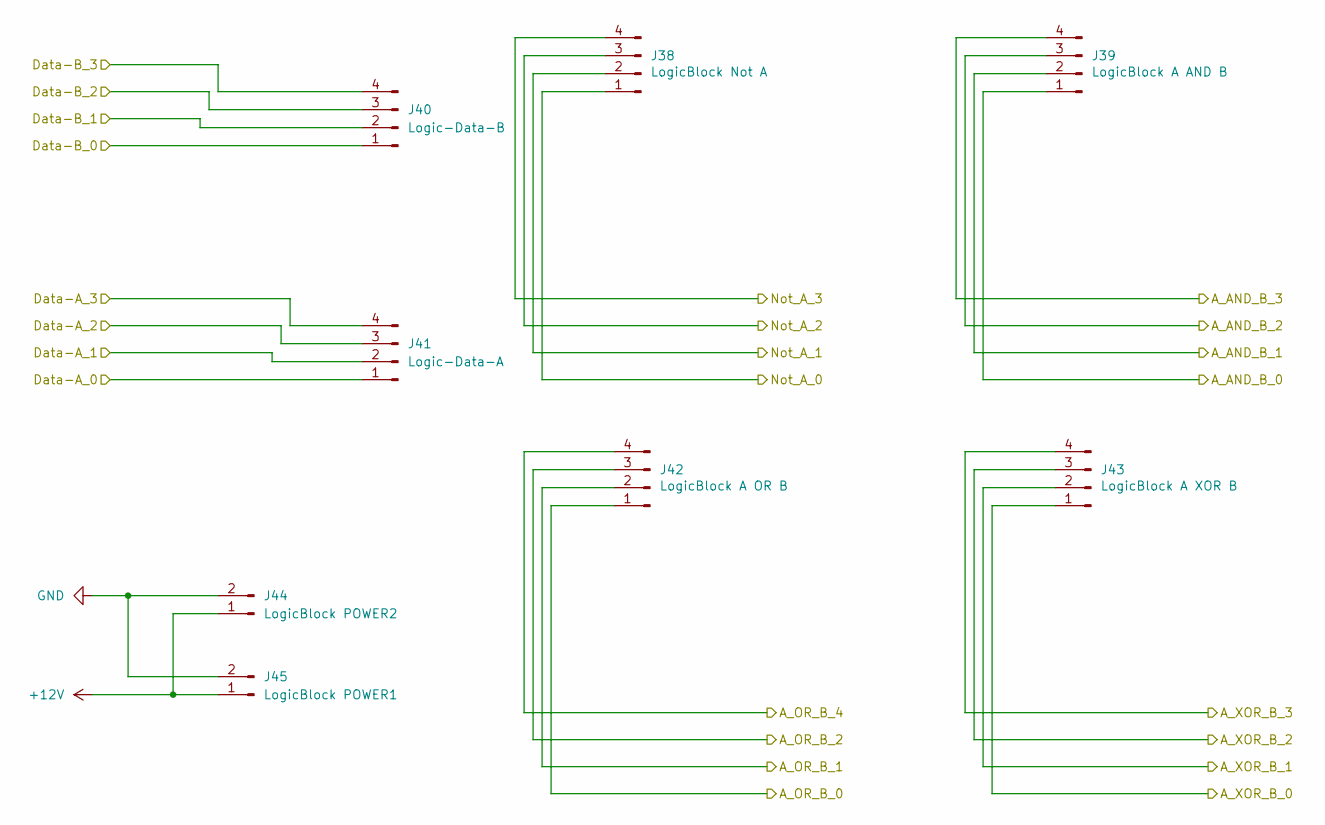
[picture p125: schematic Logic Operation.kicad_sch]

Parts:
J38: LogicBlock Not A; PinHeader_1x04_P2.54mm_Vertical
J39: LogicBlock A AND B; PinHeader_1x04_P2.54mm_Vertical
J40: Logic-Data-B; PinHeader_1x04_P2.54mm_Vertical
J41: Logic-Data-A; PinHeader_1x04_P2.54mm_Vertical
J42: LogicBlock A OR B; PinHeader_1x04_P2.54mm_Vertical
J43: LogicBlock A XOR B; PinHeader_1x04_P2.54mm_Vertical
J44: LogicBlock POWER2; PinHeader_1x02_P2.54mm_Vertical
J45: LogicBlock POWER1; PinHeader_1x02_P2.54mm_Vertical

Connections:
+12V: J44.1, J45.1; also elsewhere on the board
/Arithmetic/Arithmetic-Data-A0: J41.1; also elsewhere on the board
/Arithmetic/Arithmetic-Data-A1: J41.2; also elsewhere on the board
/Arithmetic/Arithmetic-Data-A2: J41.3; also elsewhere on the board
/Arithmetic/Arithmetic-Data-A3: J41.4; also elsewhere on the board
/Arithmetic/Arithmetic-Data-B0: J40.1; also elsewhere on the board
/Arithmetic/Arithmetic-Data-B1: J40.2; also elsewhere on the board
/Arithmetic/Arithmetic-Data-B2: J40.3; also elsewhere on the board
/Arithmetic/Arithmetic-Data-B3: J40.4; also elsewhere on the board
/Logic Operation/A_AND_B_0: J39.1; also elsewhere on the board
/Logic Operation/A_AND_B_1: J39.2; also elsewhere on the board
/Logic Operation/A_AND_B_2: J39.3; also elsewhere on the board
/Logic Operation/A_AND_B_3: J39.4; also elsewhere on the board
/Logic Operation/A_OR_B_0: J42.1; also elsewhere on the board
/Logic Operation/A_OR_B_1: J42.2; also elsewhere on the board
/Logic Operation/A_OR_B_2: J42.3; also elsewhere on the board
/Logic Operation/A_OR_B_4: J42.4; also elsewhere on the board
/Logic Operation/A_XOR_B_0: J43.1; also elsewhere on the board
/Logic Operation/A_XOR_B_1: J43.2; also elsewhere on the board
/Logic Operation/A_XOR_B_2: J43.3; also elsewhere on the board
/Logic Operation/A_XOR_B_3: J43.4; also elsewhere on the board
/Logic Operation/Not_A_0: J38.1; also elsewhere on the board
/Logic Operation/Not_A_1: J38.2; also elsewhere on the board
/Logic Operation/Not_A_2: J38.3; also elsewhere on the board
/Logic Operation/Not_A_3: J38.4; also elsewhere on the board
GND: J44.2, J45.2; also elsewhere on the board

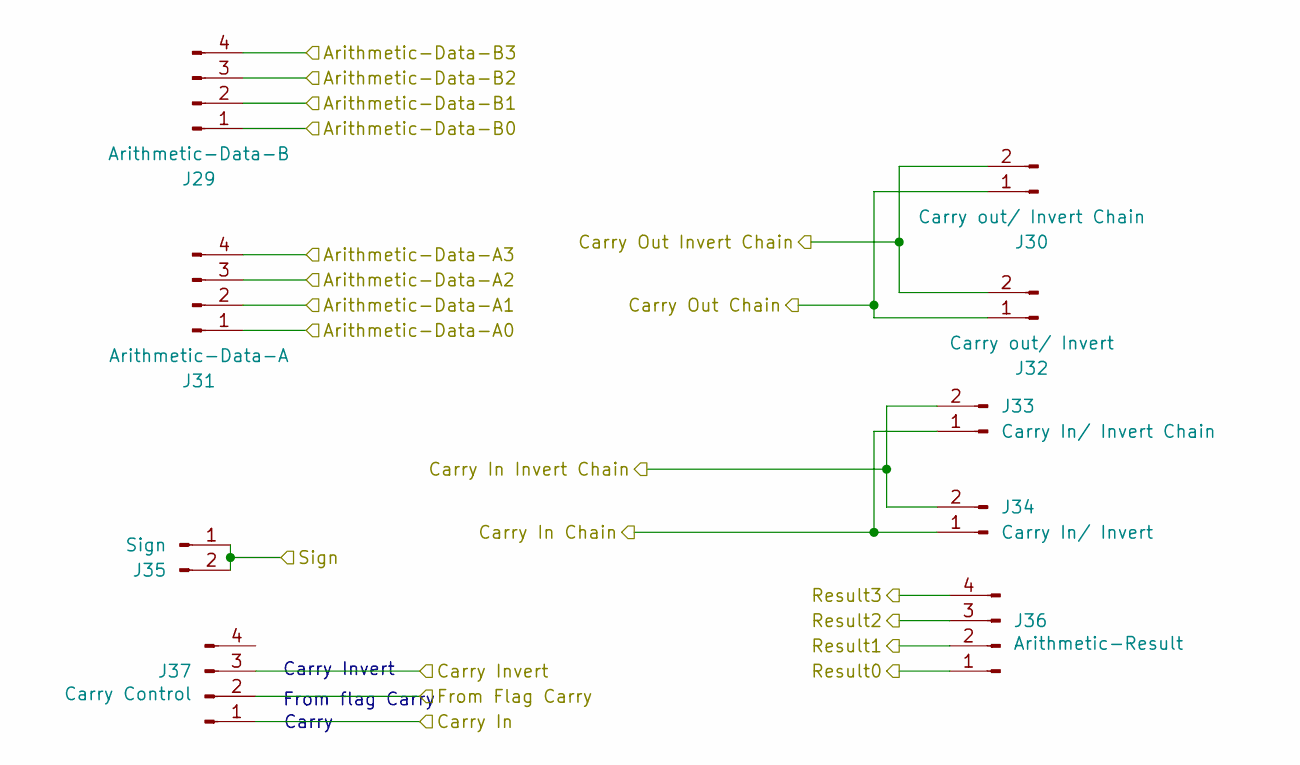
[picture p126: schematic Arithmetic.kicad_sch]

Parts:
J29: Arithmetic-Data-B; PinHeader_1x04_P2.54mm_Vertical
J30: Carry out/ Invert Chain; PinHeader_1x02_P2.54mm_Vertical
J31: Arithmetic-Data-A; PinHeader_1x04_P2.54mm_Vertical
J32: Carry out/ Invert; PinHeader_1x02_P2.54mm_Vertical
J33: Carry In/ Invert Chain; PinHeader_1x02_P2.54mm_Vertical
J34: Carry In/ Invert; PinHeader_1x02_P2.54mm_Vertical
J35: Sign; PinHeader_1x02_P2.54mm_Vertical
J36: Arithmetic-Result; PinHeader_1x04_P2.54mm_Vertical
J37: Carry Control; PinHeader_1x04_P2.54mm_Vertical

Connections:
/Arithmetic/Arithmetic-Data-A0: J31.1; also elsewhere on the board
/Arithmetic/Arithmetic-Data-A1: J31.2; also elsewhere on the board
/Arithmetic/Arithmetic-Data-A2: J31.3; also elsewhere on the board
/Arithmetic/Arithmetic-Data-A3: J31.4; also elsewhere on the board
/Arithmetic/Arithmetic-Data-B0: J29.1; also elsewhere on the board
/Arithmetic/Arithmetic-Data-B1: J29.2; also elsewhere on the board
/Arithmetic/Arithmetic-Data-B2: J29.3; also elsewhere on the board
/Arithmetic/Arithmetic-Data-B3: J29.4; also elsewhere on the board
/Arithmetic/Carry In: J37.1; also elsewhere on the board
/Arithmetic/Carry In Chain: J33.1, J34.1; also elsewhere on the board
/Arithmetic/Carry In Invert Chain: J33.2, J34.2; also elsewhere on the board
/Arithmetic/Carry Invert: J37.3; also elsewhere on the board
/Arithmetic/Carry Out Chain: J30.1, J32.1; also elsewhere on the board
/Arithmetic/Carry Out Invert Chain: J30.2, J32.2; also elsewhere on the board
/Arithmetic/From Flag Carry: J37.2; also elsewhere on the board
/Arithmetic/Result0: J36.1; also elsewhere on the board
/Arithmetic/Result1: J36.2; also elsewhere on the board
/Arithmetic/Result2: J36.3; also elsewhere on the board
/Arithmetic/Result3: J36.4; also elsewhere on the board
/Arithmetic/Sign: J35.1, J35.2; also elsewhere on the board

Notes on the sheet:
Carry
From flag Carry
Carry Invert

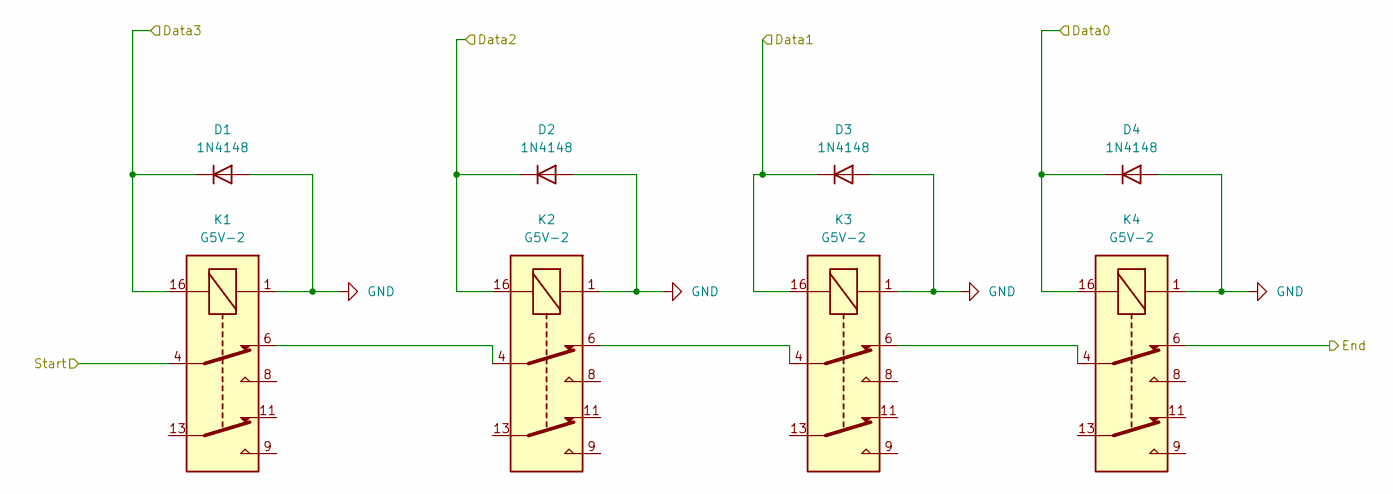
[picture p127: schematic ZeroDetect.kicad_sch]

Parts:
D1, D2, D3, D4: 1N4148; D_DO-35_SOD27_P7.62mm_Horizontal
K1, K2, K3, K4: G5V-2; Relay_DPDT_Omron_G5V-2

Connections:
/ZeroDetect/Data0: D4.1 (K), K4.16; also elsewhere on the board
/ZeroDetect/Data1: D3.1 (K), K3.16; also elsewhere on the board
/ZeroDetect/Data2: D2.1 (K), K2.16; also elsewhere on the board
/ZeroDetect/Data3: D1.1 (K), K1.16; also elsewhere on the board
/ZeroDetect/End: K4.6; also elsewhere on the board
/ZeroDetect/Start: K1.4; also elsewhere on the board
GND: D1.2 (A), D2.2 (A), D3.2 (A), D4.2 (A), K1.1, K2.1, K3.1, K4.1; also elsewhere on the board
unnamed: K1.6, K2.4
unnamed: K2.6, K3.4
unnamed: K3.6, K4.4

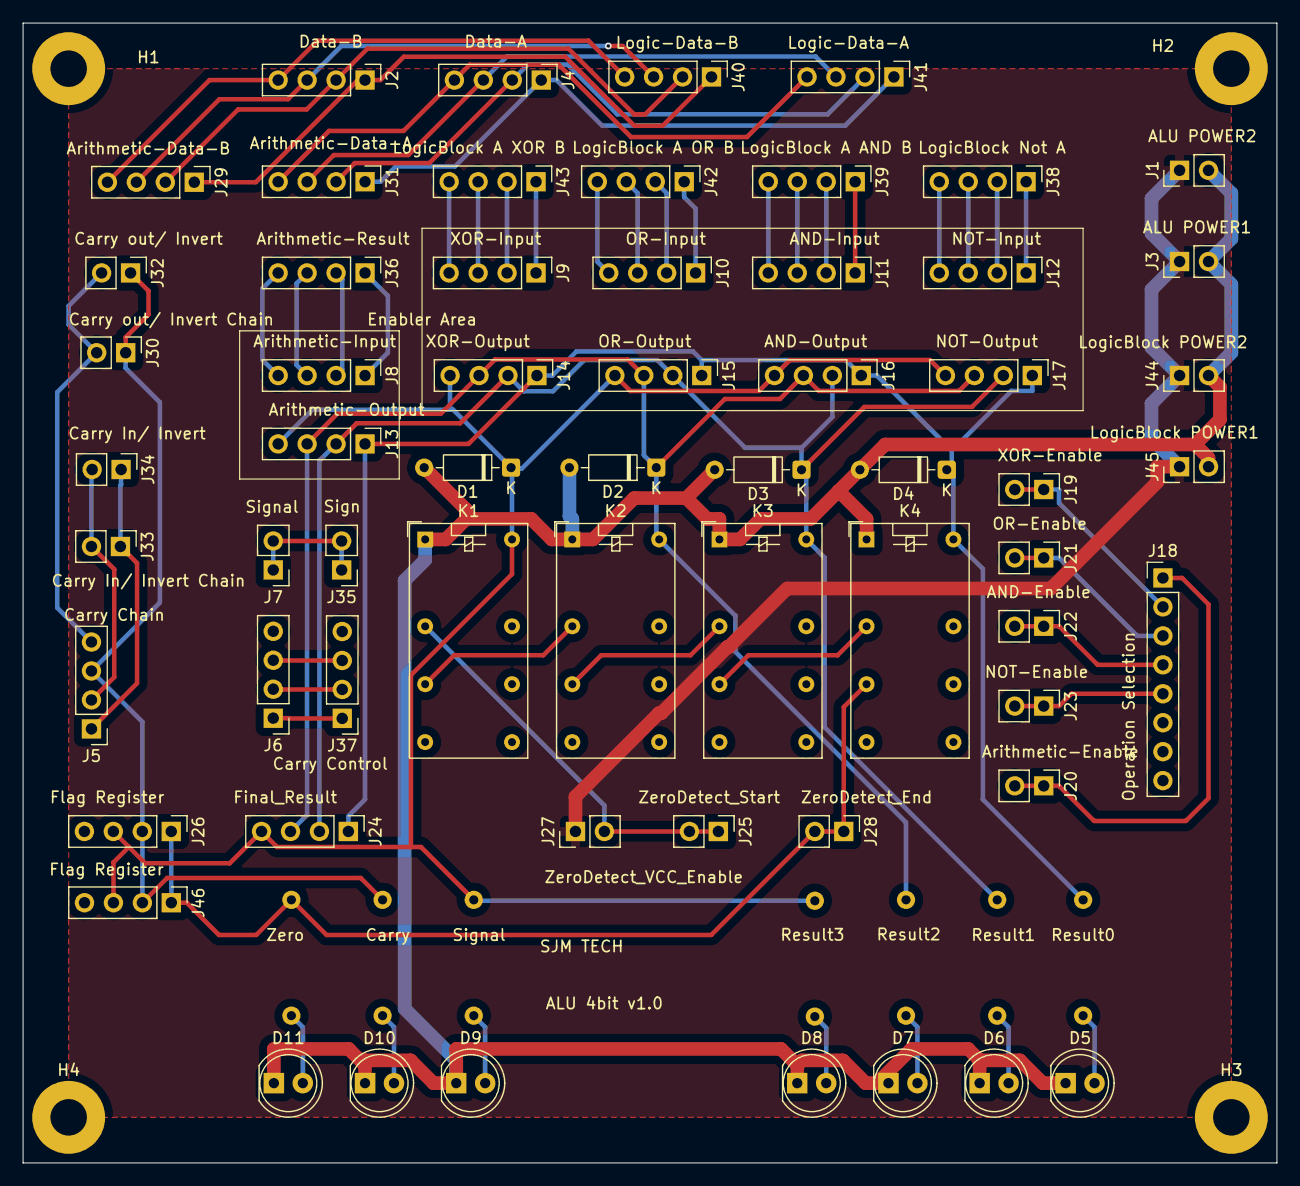
[picture p128: board ALU.kicad_pcb from above]

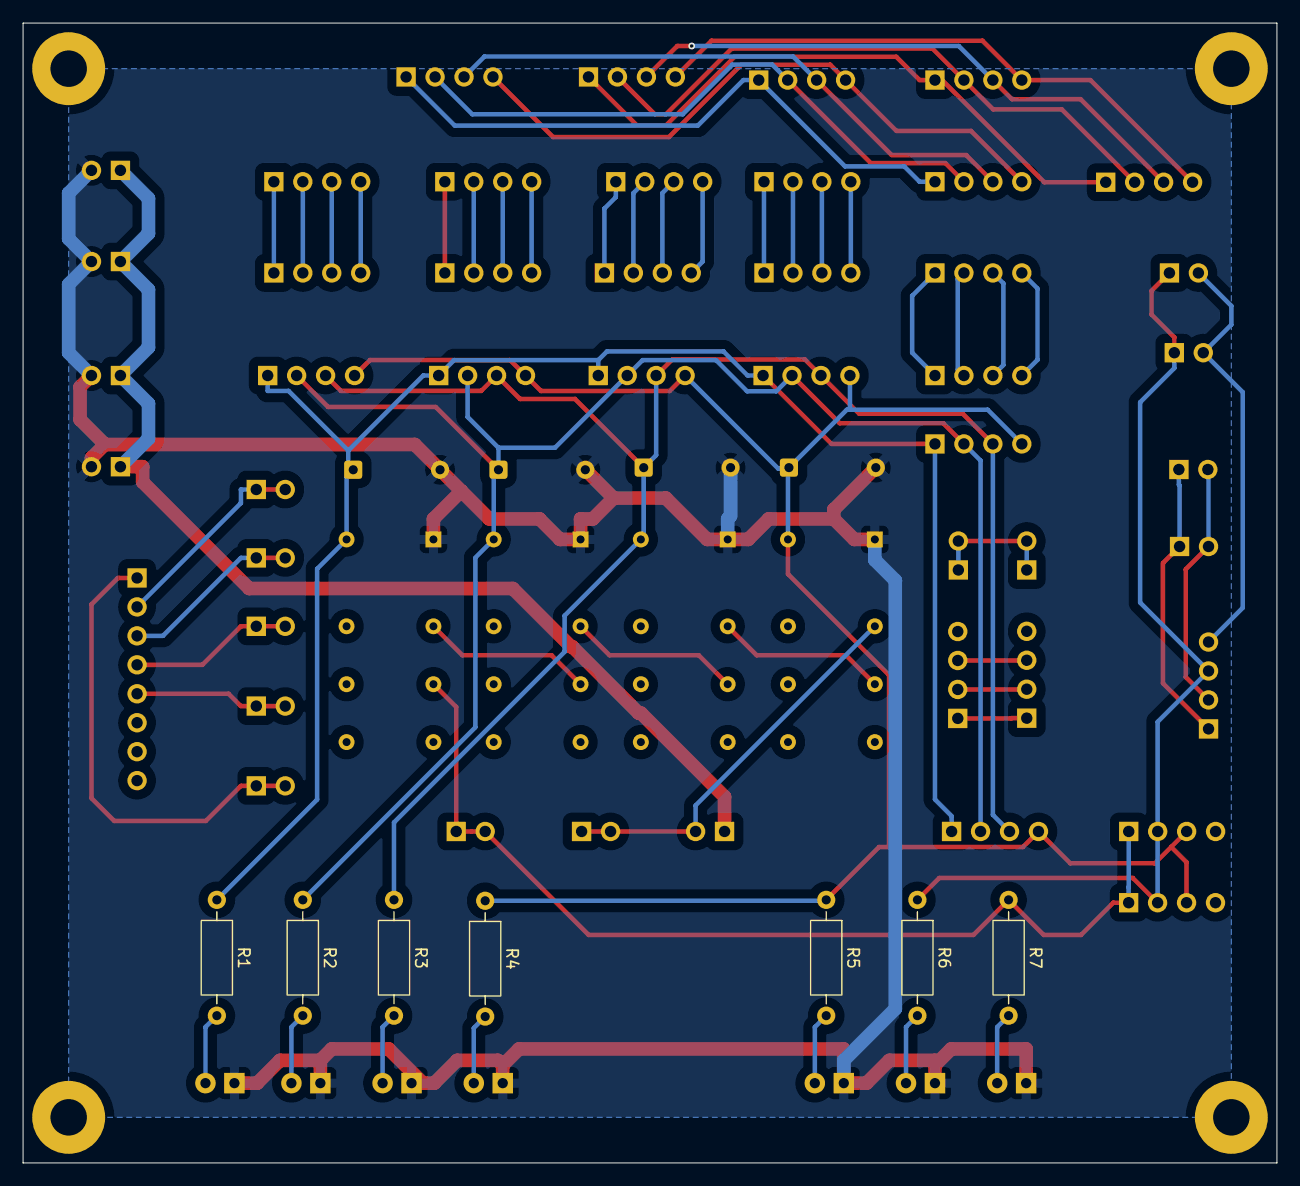
[picture p129: board ALU.kicad_pcb from below]

Board: 2 copper layers, 110.0 x 100.0 mm, 72 parts (7 on the bottom side), 59 nets.
