RadeonHD6750/Relay4bitComputer/Register/Register.kicad_pcb

## KiCad design Register/Register.kicad_pcb (2026-06-11)

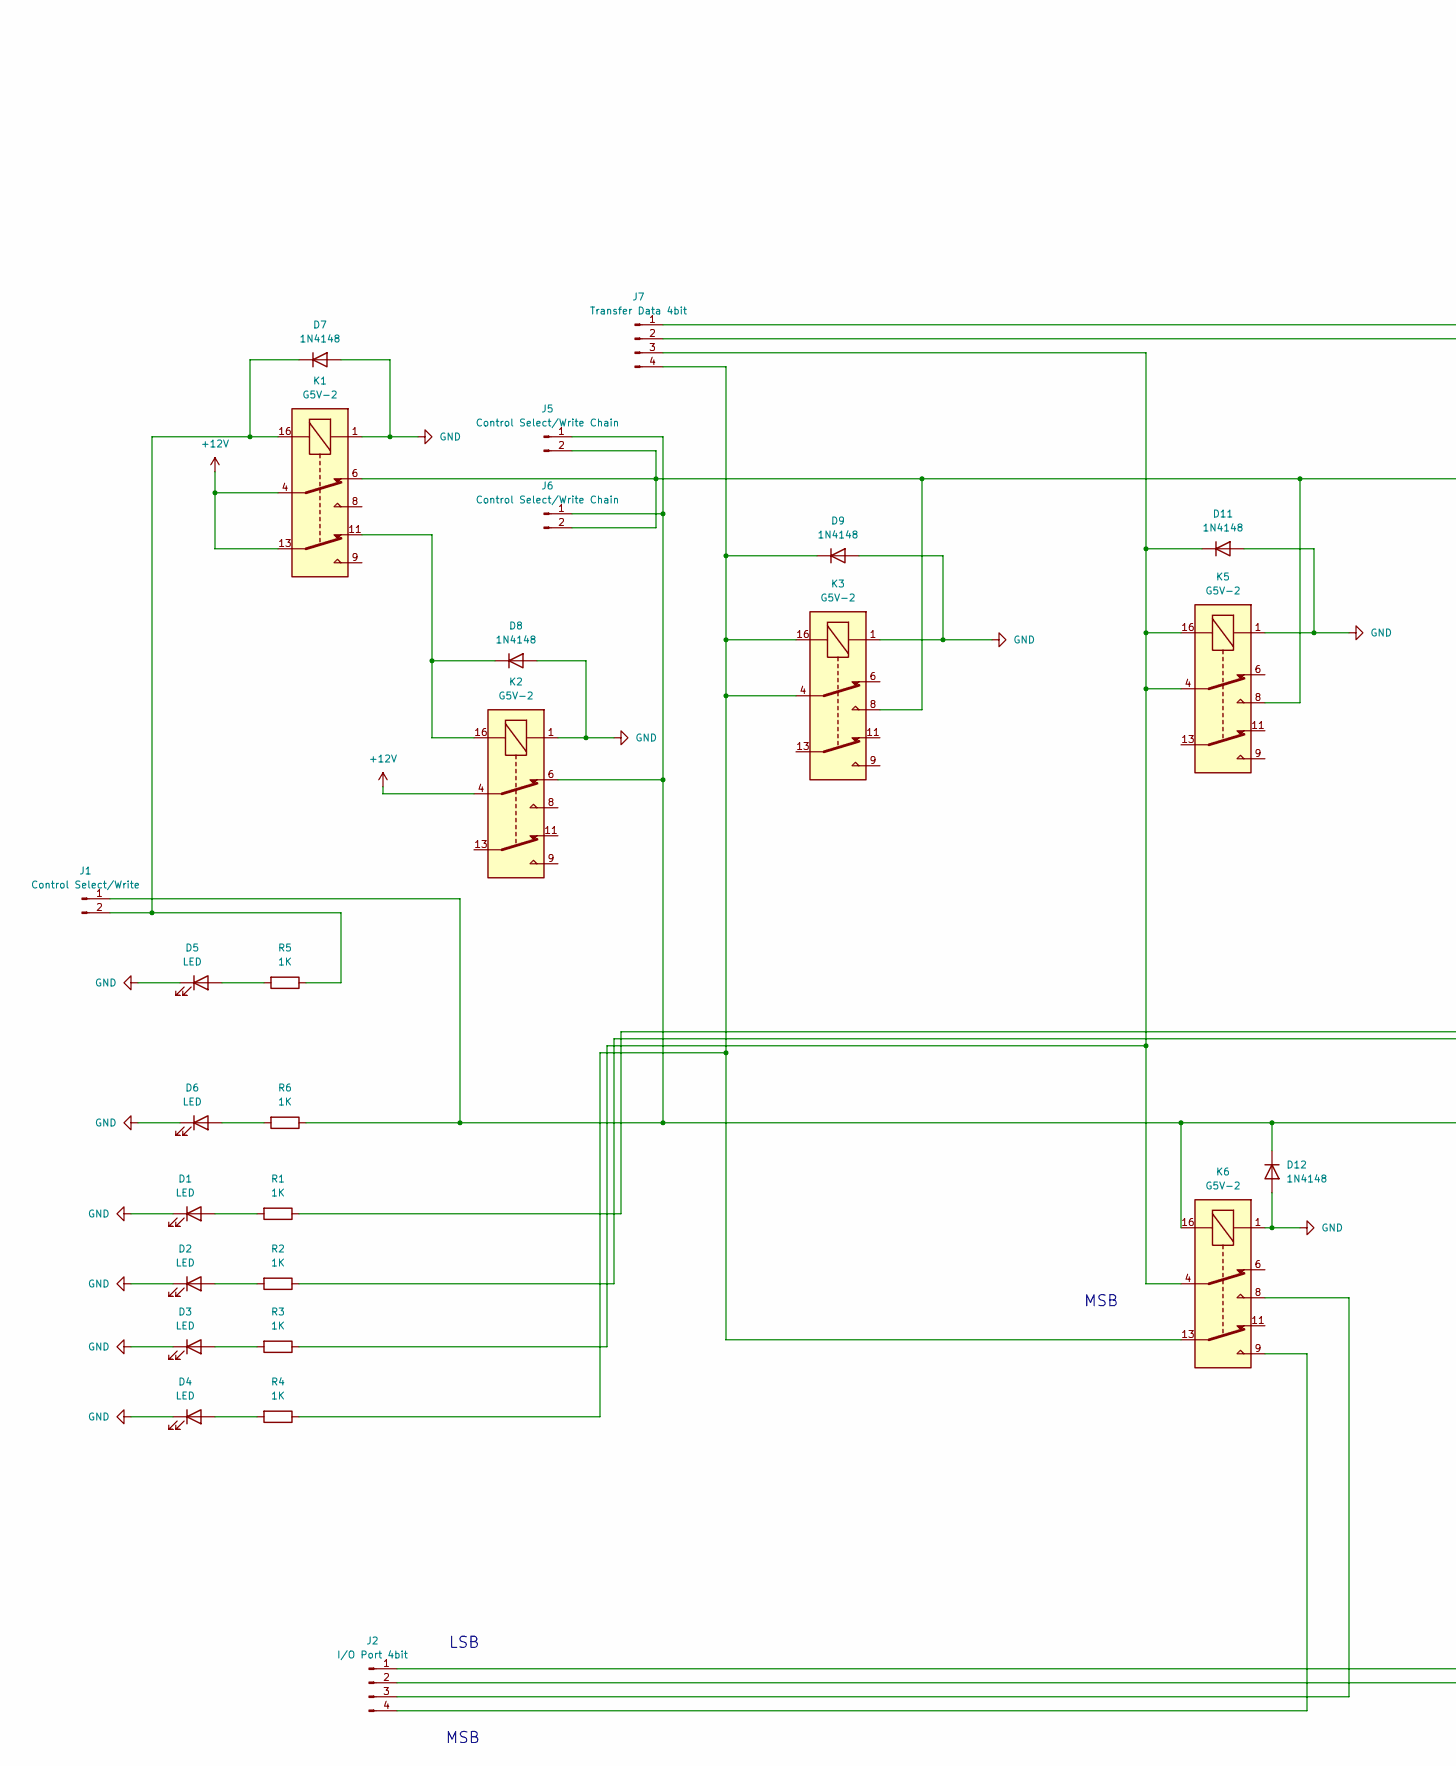
[picture p130: schematic Register.kicad_sch, part in row 1, column 1]

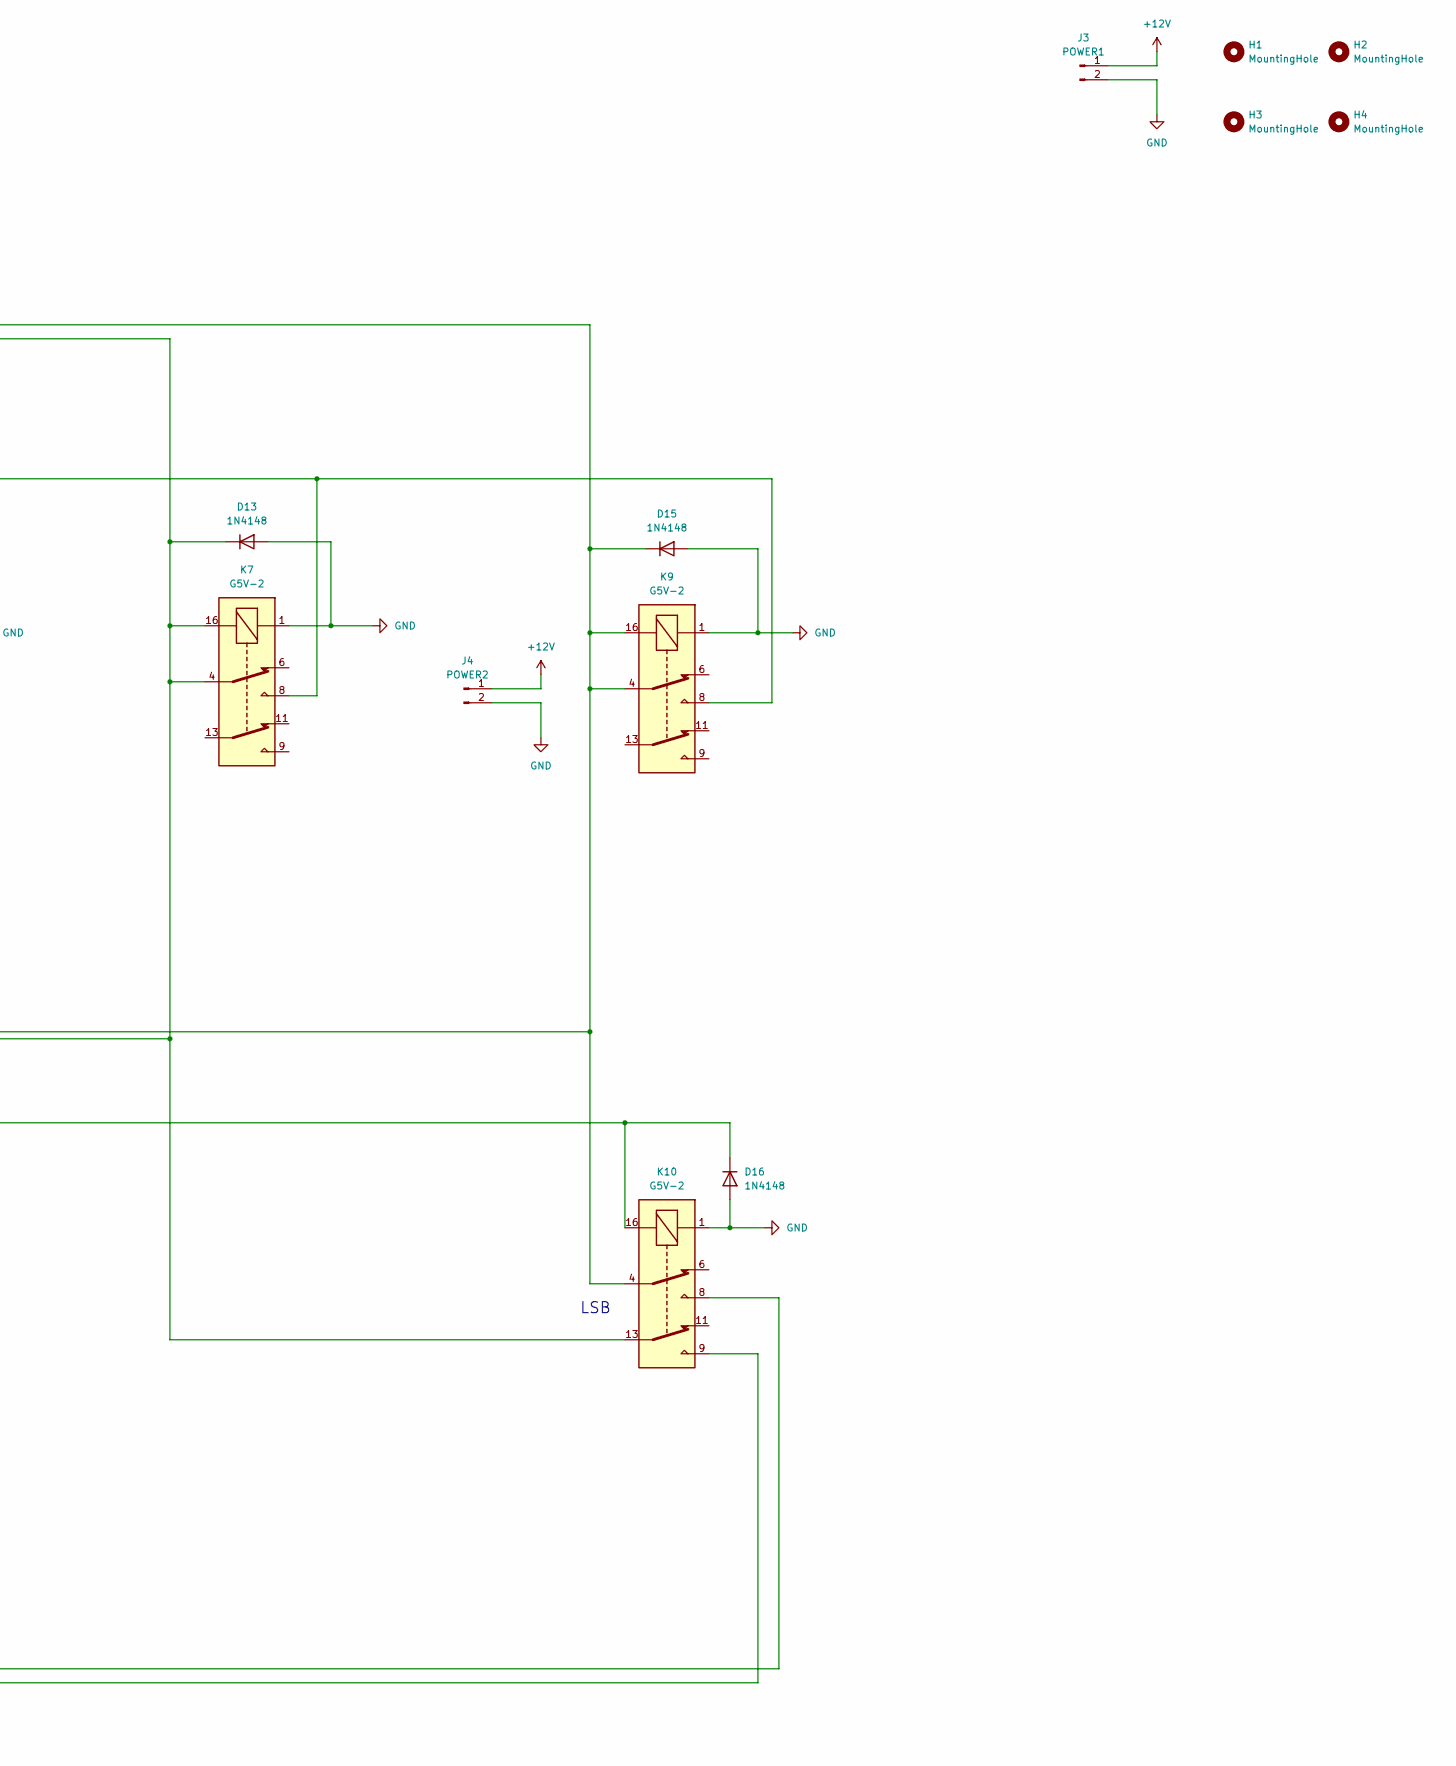
[picture p131: schematic Register.kicad_sch, part in row 1, column 2]

Parts:
D1, D2, D3, D4, D5, D6: LED; LED_D5.0mm
D7, D8, D9, D11, D12, D13, D15, D16: 1N4148; D_DO-35_SOD27_P7.62mm_Horizontal
H1, H2, H3, H4: MountingHole; MountingHole_3.2mm_M3
J1: Control Select/Write; PinHeader_1x02_P2.54mm_Vertical
J2: I/O Port 4bit; PinHeader_1x04_P2.54mm_Vertical
J3: POWER1; PinHeader_1x02_P2.54mm_Vertical
J4: POWER2; PinHeader_1x02_P2.54mm_Vertical
J5, J6: Control Select/Write Chain; PinHeader_1x02_P2.54mm_Vertical
J7: Transfer Data 4bit; PinHeader_1x04_P2.54mm_Vertical
K1, K2, K3, K5, K6, K7, K9, K10: G5V-2; Relay_DPDT_Omron_G5V-2
R1, R2, R3, R4, R5, R6: 1K; R_Axial_DIN0207_L6.3mm_D2.5mm_P10.16mm_Horizontal

Connections:
+12V: J3.1, J4.1, K1.4, K1.13, K2.4
GND: D1.1 (K), D2.1 (K), D3.1 (K), D4.1 (K), D5.1 (K), D6.1 (K), D7.2 (A), D8.2 (A), D9.2 (A), D11.2 (A), D12.2 (A), D13.2 (A), D15.2 (A), D16.2 (A), J3.2, J4.2, K1.1, K2.1, K3.1, K5.1, K6.1, K7.1, K9.1, K10.1
unnamed: D1.2 (A), R1.2
unnamed: D2.2 (A), R2.2
unnamed: D3.2 (A), R3.2
unnamed: D4.2 (A), R4.2
unnamed: D5.2 (A), R5.2
unnamed: D6.2 (A), R6.2
unnamed: D7.1 (K), J1.2, K1.16, R5.1
unnamed: D8.1 (K), K1.11, K2.16
unnamed: D9.1 (K), J7.4, K3.4, K3.16, K6.13, R4.1
unnamed: D11.1 (K), J7.3, K5.4, K5.16, K6.4, R3.1
unnamed: D12.1 (K), D16.1 (K), J1.1, J5.1, J6.1, K2.6, K6.16, K10.16, R6.1
unnamed: D13.1 (K), J7.2, K7.4, K7.16, K10.13, R2.1
unnamed: D15.1 (K), J7.1, K9.4, K9.16, K10.4, R1.1
unnamed: J2.1, K10.8
unnamed: J2.2, K10.9
unnamed: J2.3, K6.8
unnamed: J2.4, K6.9
unnamed: J5.2, J6.2, K1.6, K3.8, K5.8, K7.8, K9.8

Notes on the sheet:
LSB
MSB

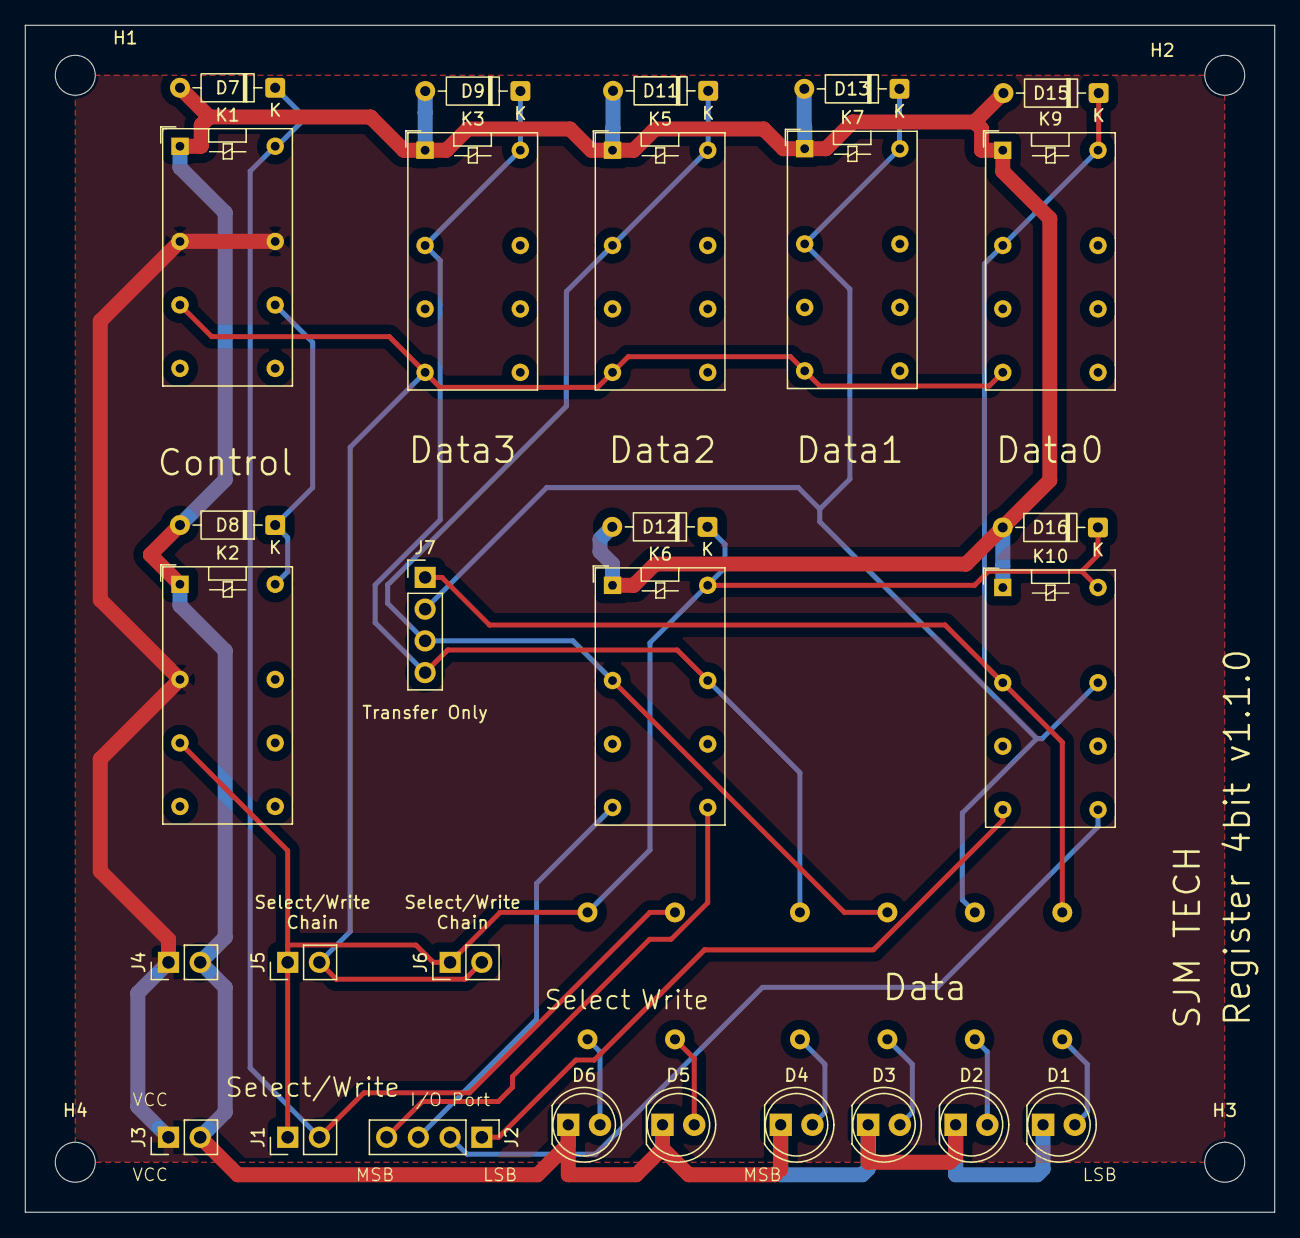
[picture p132: board Register.kicad_pcb from above]

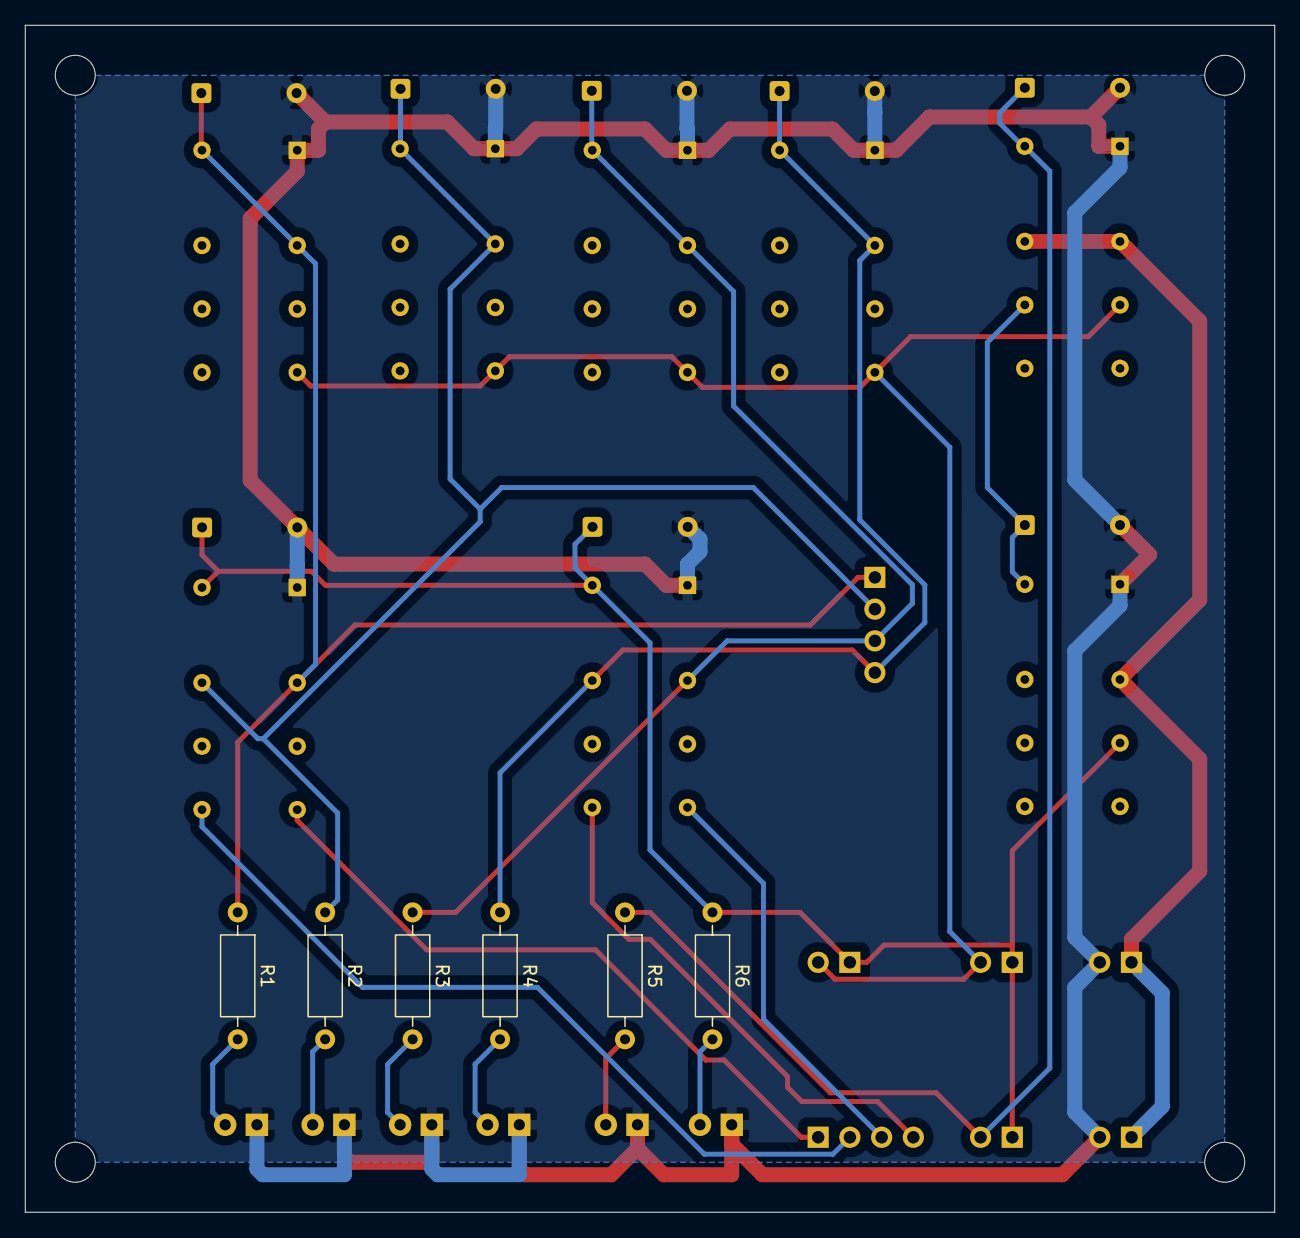
[picture p133: board Register.kicad_pcb from below]

Board: 2 copper layers, 100.0 x 95.0 mm, 39 parts (6 on the bottom side), 20 nets.
