RadeonHD6750/Relay4bitComputer/LogicBlock/LogicBlock.kicad_pcb

## KiCad design LogicBlock/LogicBlock.kicad_pcb (2026-06-10)

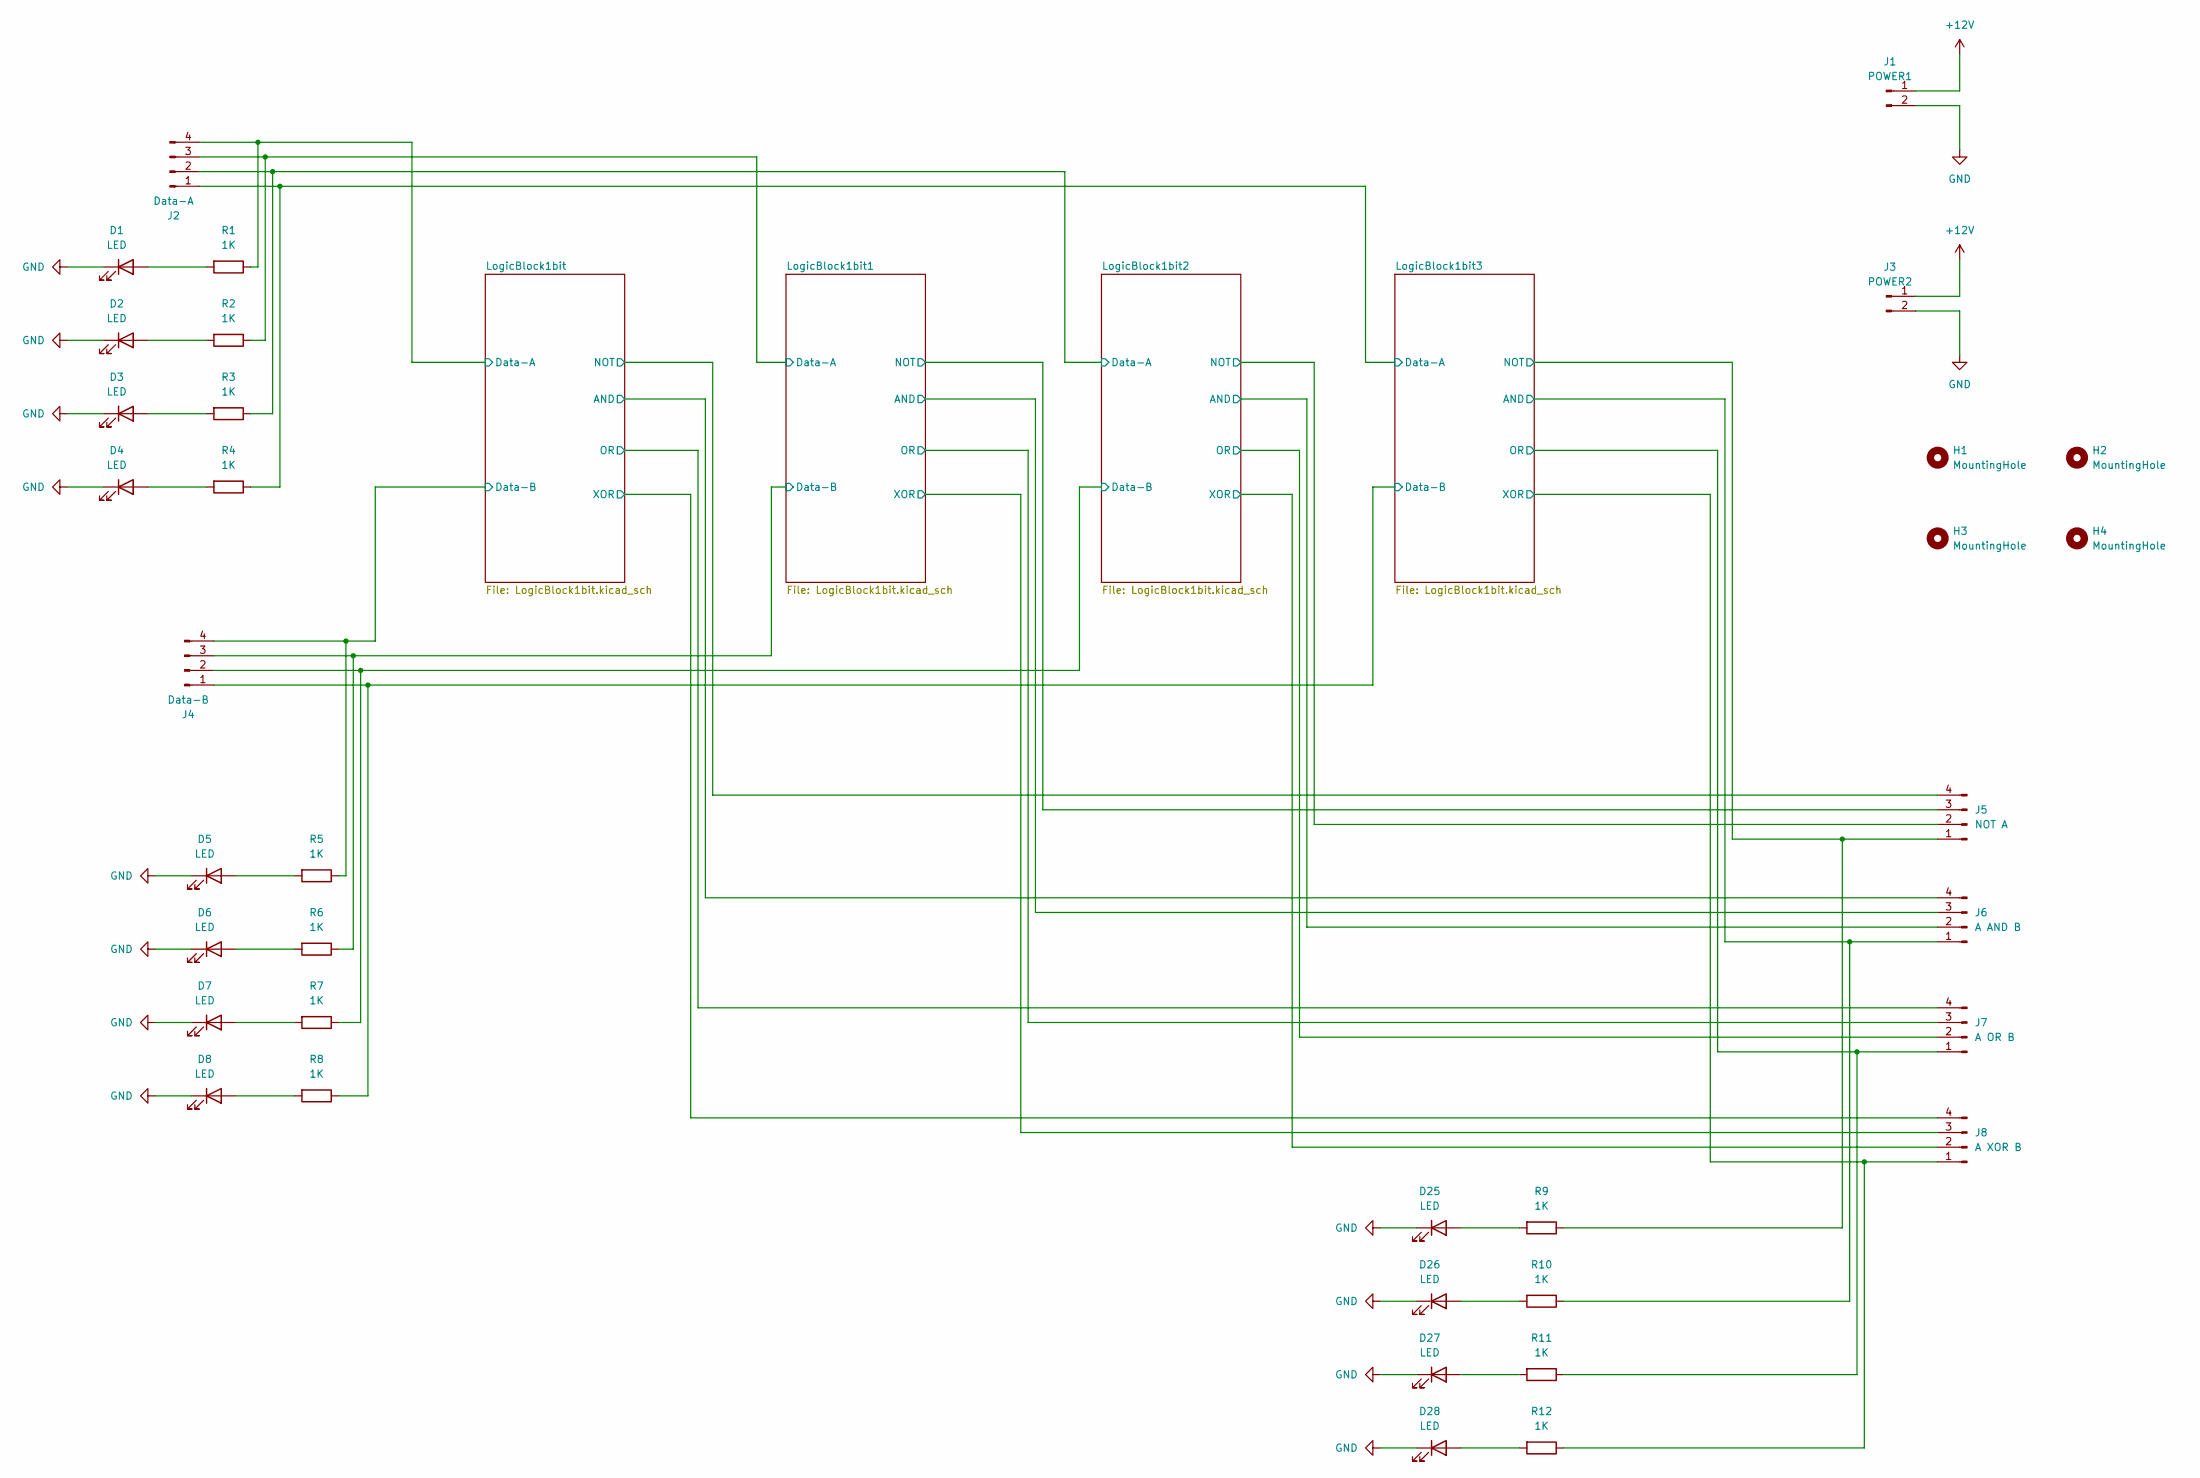
[picture p134: schematic LogicBlock.kicad_sch]

Parts:
D1, D2, D3, D4, D5, D6, D7, D8, D25, D26, D27, D28: LED; LED_D5.0mm
H1, H2, H3, H4: MountingHole; MountingHole_3.2mm_M3
J1: POWER1; PinHeader_1x02_P2.54mm_Vertical
J2: Data-A; PinHeader_1x04_P2.54mm_Vertical
J3: POWER2; PinHeader_1x02_P2.54mm_Vertical
J4: Data-B; PinHeader_1x04_P2.54mm_Vertical
J5: NOT A; PinHeader_1x04_P2.54mm_Vertical
J6: A AND B; PinHeader_1x04_P2.54mm_Vertical
J7: A OR B; PinHeader_1x04_P2.54mm_Vertical
J8: A XOR B; PinHeader_1x04_P2.54mm_Vertical
R1, R2, R3, R4, R5, R6, R7, R8, R9, R10, R11, R12: 1K; R_Axial_DIN0207_L6.3mm_D2.5mm_P10.16mm_Horizontal

Connections:
+12V: J1.1, J3.1; also elsewhere on the board
/LogicBlock1bit1/AND: J6.3; also elsewhere on the board
/LogicBlock1bit1/Data-A: J2.3, R2.1; also elsewhere on the board
/LogicBlock1bit1/Data-B: J4.3, R6.1; also elsewhere on the board
/LogicBlock1bit1/NOT: J5.3; also elsewhere on the board
/LogicBlock1bit1/OR: J7.3; also elsewhere on the board
/LogicBlock1bit1/XOR: J8.3; also elsewhere on the board
/LogicBlock1bit2/AND: J6.2; also elsewhere on the board
/LogicBlock1bit2/Data-A: J2.2, R3.1; also elsewhere on the board
/LogicBlock1bit2/Data-B: J4.2, R7.1; also elsewhere on the board
/LogicBlock1bit2/NOT: J5.2; also elsewhere on the board
/LogicBlock1bit2/OR: J7.2; also elsewhere on the board
/LogicBlock1bit2/XOR: J8.2; also elsewhere on the board
/LogicBlock1bit3/AND: J6.1, R10.1; also elsewhere on the board
/LogicBlock1bit3/Data-A: J2.1, R4.1; also elsewhere on the board
/LogicBlock1bit3/Data-B: J4.1, R8.1; also elsewhere on the board
/LogicBlock1bit3/NOT: J5.1, R9.1; also elsewhere on the board
/LogicBlock1bit3/OR: J7.1, R11.1; also elsewhere on the board
/LogicBlock1bit3/XOR: J8.1, R12.1; also elsewhere on the board
/LogicBlock1bit/AND: J6.4; also elsewhere on the board
/LogicBlock1bit/Data-A: J2.4, R1.1; also elsewhere on the board
/LogicBlock1bit/Data-B: J4.4, R5.1; also elsewhere on the board
/LogicBlock1bit/NOT: J5.4; also elsewhere on the board
/LogicBlock1bit/OR: J7.4; also elsewhere on the board
/LogicBlock1bit/XOR: J8.4; also elsewhere on the board
GND: D1.1 (K), D2.1 (K), D3.1 (K), D4.1 (K), D5.1 (K), D6.1 (K), D7.1 (K), D8.1 (K), D25.1 (K), D26.1 (K), D27.1 (K), D28.1 (K), J1.2, J3.2; also elsewhere on the board
unnamed: D1.2 (A), R1.2
unnamed: D2.2 (A), R2.2
unnamed: D3.2 (A), R3.2
unnamed: D4.2 (A), R4.2
unnamed: D5.2 (A), R5.2
unnamed: D6.2 (A), R6.2
unnamed: D7.2 (A), R7.2
unnamed: D8.2 (A), R8.2
unnamed: D25.2 (A), R9.2
unnamed: D26.2 (A), R10.2
unnamed: D27.2 (A), R11.2
unnamed: D28.2 (A), R12.2

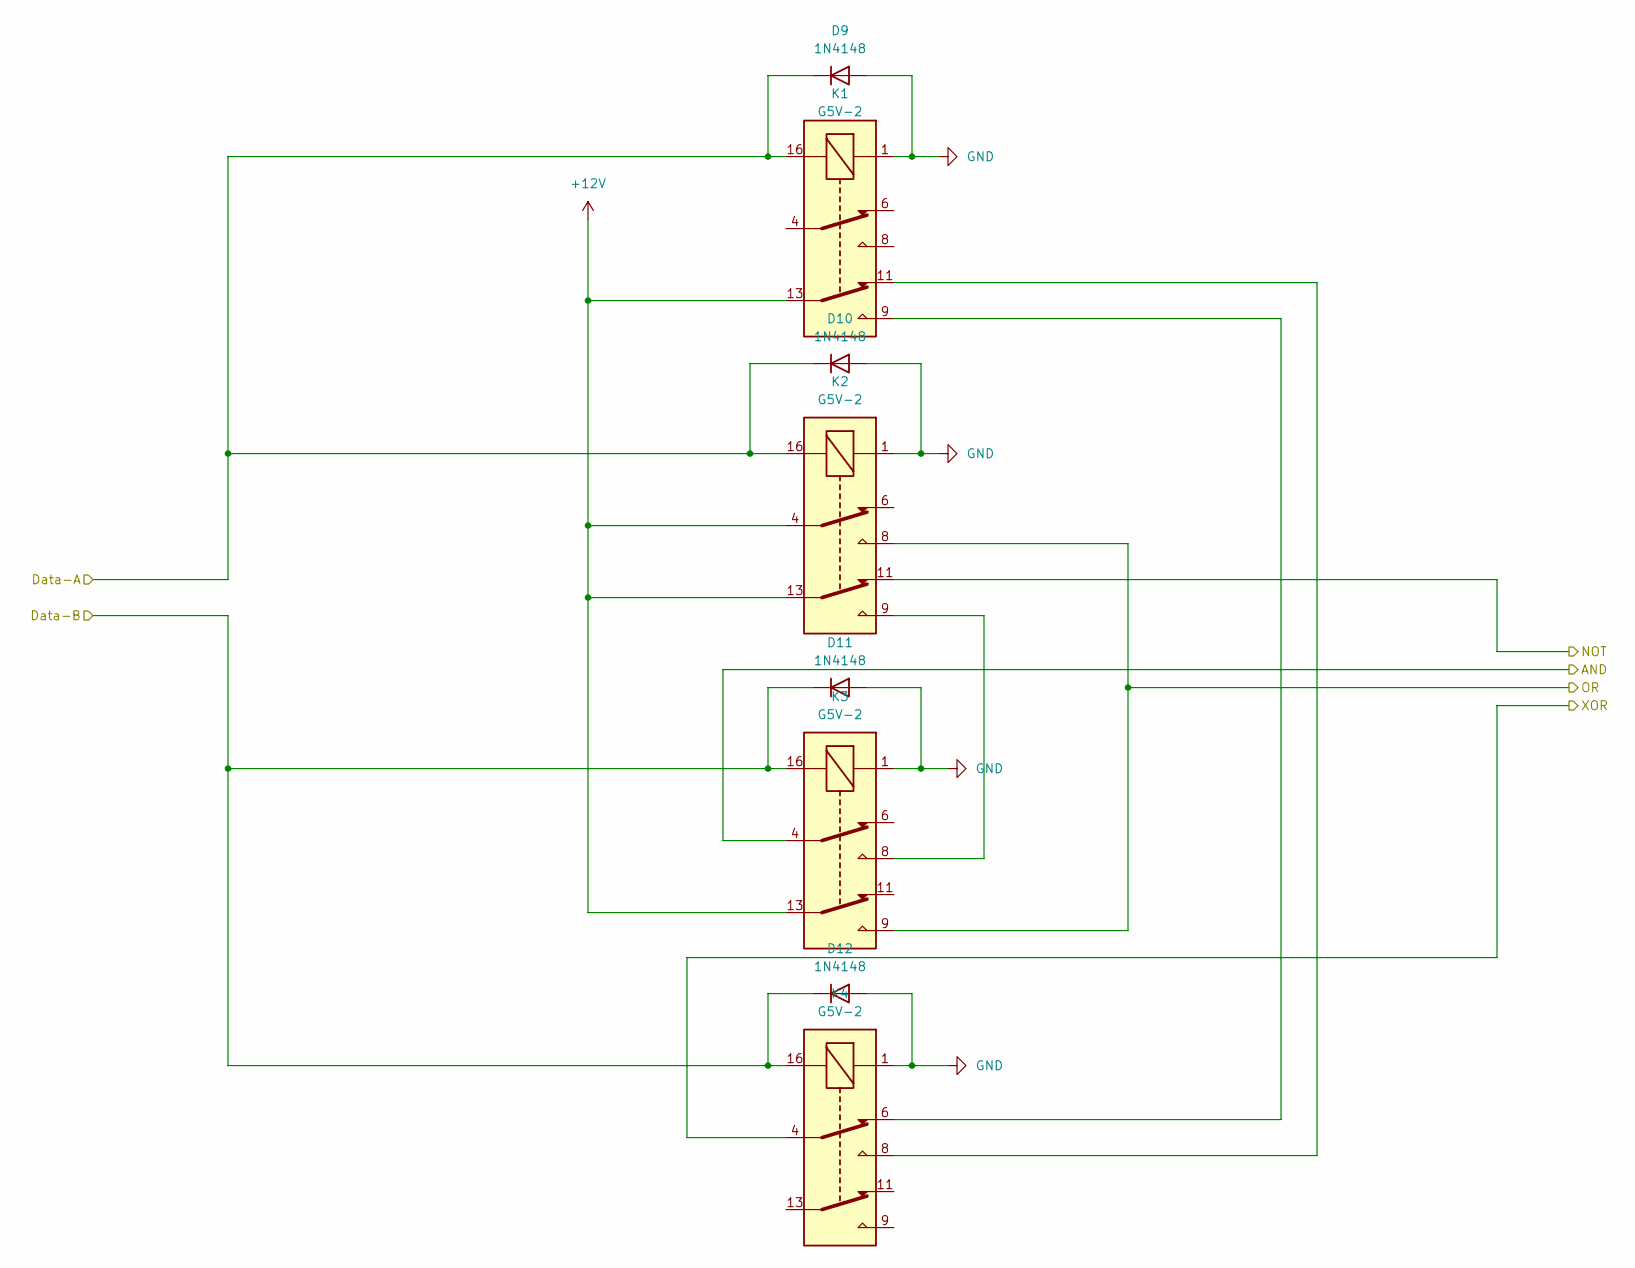
[picture p135: schematic LogicBlock1bit.kicad_sch]

Parts:
D9, D10, D11, D12: 1N4148; D_DO-35_SOD27_P7.62mm_Horizontal
K1, K2, K3, K4: G5V-2; Relay_DPDT_Omron_G5V-2

Connections:
+12V: K1.13, K2.4, K2.13, K3.13; also elsewhere on the board
/LogicBlock1bit/AND: K3.4; also elsewhere on the board
/LogicBlock1bit/Data-A: D9.1 (K), D10.1 (K), K1.16, K2.16; also elsewhere on the board
/LogicBlock1bit/Data-B: D11.1 (K), D12.1 (K), K3.16, K4.16; also elsewhere on the board
/LogicBlock1bit/NOT: K2.11; also elsewhere on the board
/LogicBlock1bit/OR: K2.8, K3.9; also elsewhere on the board
/LogicBlock1bit/XOR: K4.4; also elsewhere on the board
GND: D9.2 (A), D10.2 (A), D11.2 (A), D12.2 (A), K1.1, K2.1, K3.1, K4.1; also elsewhere on the board
unnamed: K1.9, K4.6
unnamed: K1.11, K4.8
unnamed: K2.9, K3.8

Parts of its further copies:
D13, D14, D15, D16, D17, D18, D19, D20, D21, D22, D23, D24: 1N4148; D_DO-35_SOD27_P7.62mm_Horizontal
K5, K6, K7, K8, K9, K10, K11, K12, K13, K14, K15, K16: G5V-2; Relay_DPDT_Omron_G5V-2

Connections of its further copies:
+12V: K5.13, K6.4, K6.13, K7.13, K9.13, K10.4, K10.13, K11.13, K13.13, K14.4, K14.13, K15.13; also elsewhere on the board
/LogicBlock1bit1/AND: K7.4; also elsewhere on the board
/LogicBlock1bit1/Data-A: D13.1 (K), D14.1 (K), K5.16, K6.16; also elsewhere on the board
/LogicBlock1bit1/Data-B: D15.1 (K), D16.1 (K), K7.16, K8.16; also elsewhere on the board
/LogicBlock1bit1/NOT: K6.11; also elsewhere on the board
/LogicBlock1bit1/OR: K6.8, K7.9; also elsewhere on the board
/LogicBlock1bit1/XOR: K8.4; also elsewhere on the board
/LogicBlock1bit2/AND: K11.4; also elsewhere on the board
/LogicBlock1bit2/Data-A: D17.1 (K), D18.1 (K), K9.16, K10.16; also elsewhere on the board
/LogicBlock1bit2/Data-B: D19.1 (K), D20.1 (K), K11.16, K12.16; also elsewhere on the board
/LogicBlock1bit2/NOT: K10.11; also elsewhere on the board
/LogicBlock1bit2/OR: K10.8, K11.9; also elsewhere on the board
/LogicBlock1bit2/XOR: K12.4; also elsewhere on the board
/LogicBlock1bit3/AND: K15.4; also elsewhere on the board
/LogicBlock1bit3/Data-A: D21.1 (K), D22.1 (K), K13.16, K14.16; also elsewhere on the board
/LogicBlock1bit3/Data-B: D23.1 (K), D24.1 (K), K15.16, K16.16; also elsewhere on the board
/LogicBlock1bit3/NOT: K14.11; also elsewhere on the board
/LogicBlock1bit3/OR: K14.8, K15.9; also elsewhere on the board
/LogicBlock1bit3/XOR: K16.4; also elsewhere on the board
GND: D13.2 (A), D14.2 (A), D15.2 (A), D16.2 (A), D17.2 (A), D18.2 (A), D19.2 (A), D20.2 (A), D21.2 (A), D22.2 (A), D23.2 (A), D24.2 (A), K5.1, K6.1, K7.1, K8.1, K9.1, K10.1, K11.1, K12.1, K13.1, K14.1, K15.1, K16.1; also elsewhere on the board
unnamed: K5.9, K8.6
unnamed: K5.11, K8.8
unnamed: K6.9, K7.8
unnamed: K10.9, K11.8
unnamed: K9.9, K12.6
unnamed: K9.11, K12.8
unnamed: K13.9, K16.6
unnamed: K13.11, K16.8
unnamed: K14.9, K15.8

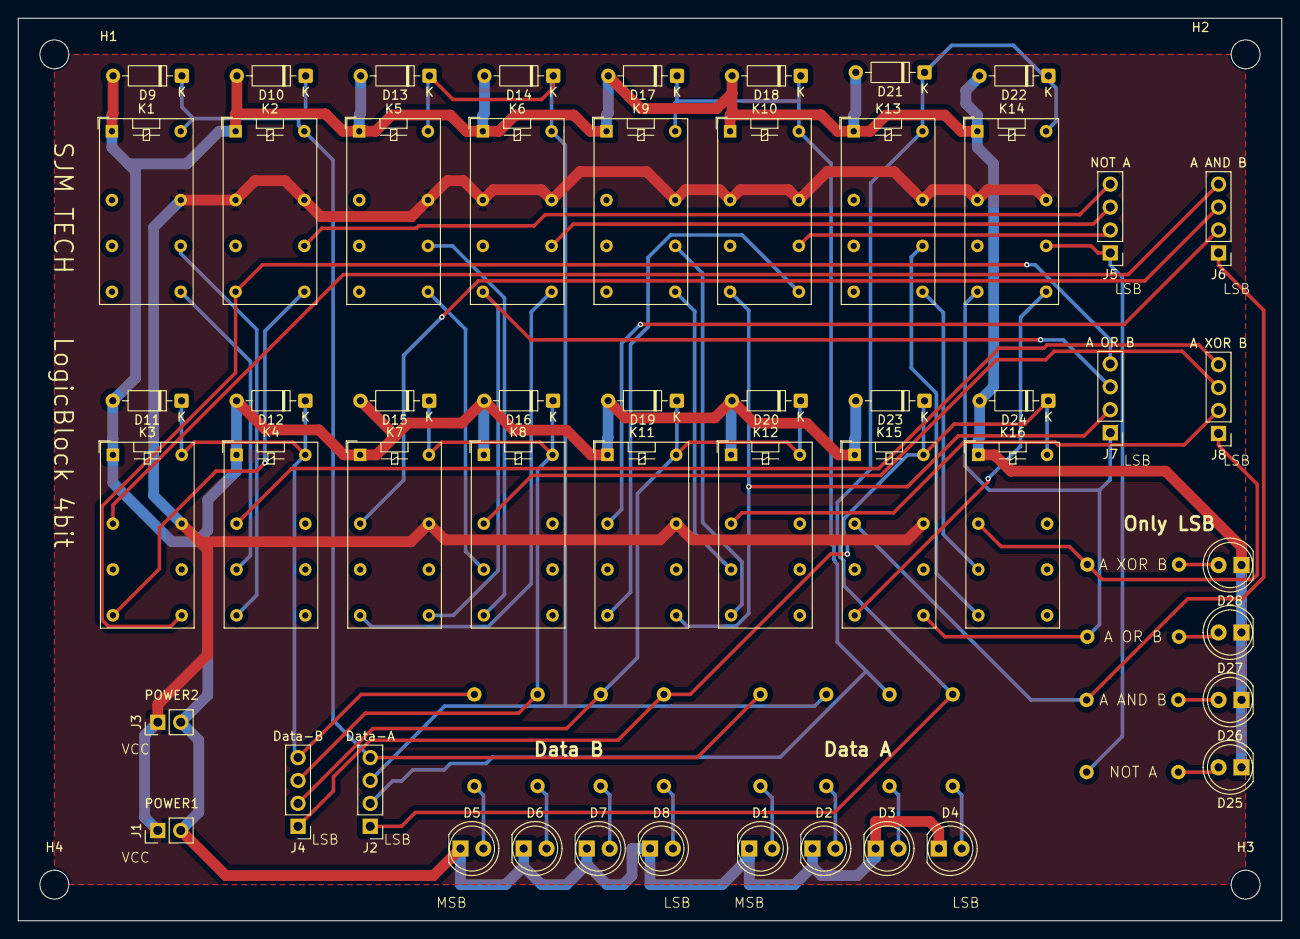
[picture p136: board LogicBlock.kicad_pcb from above]

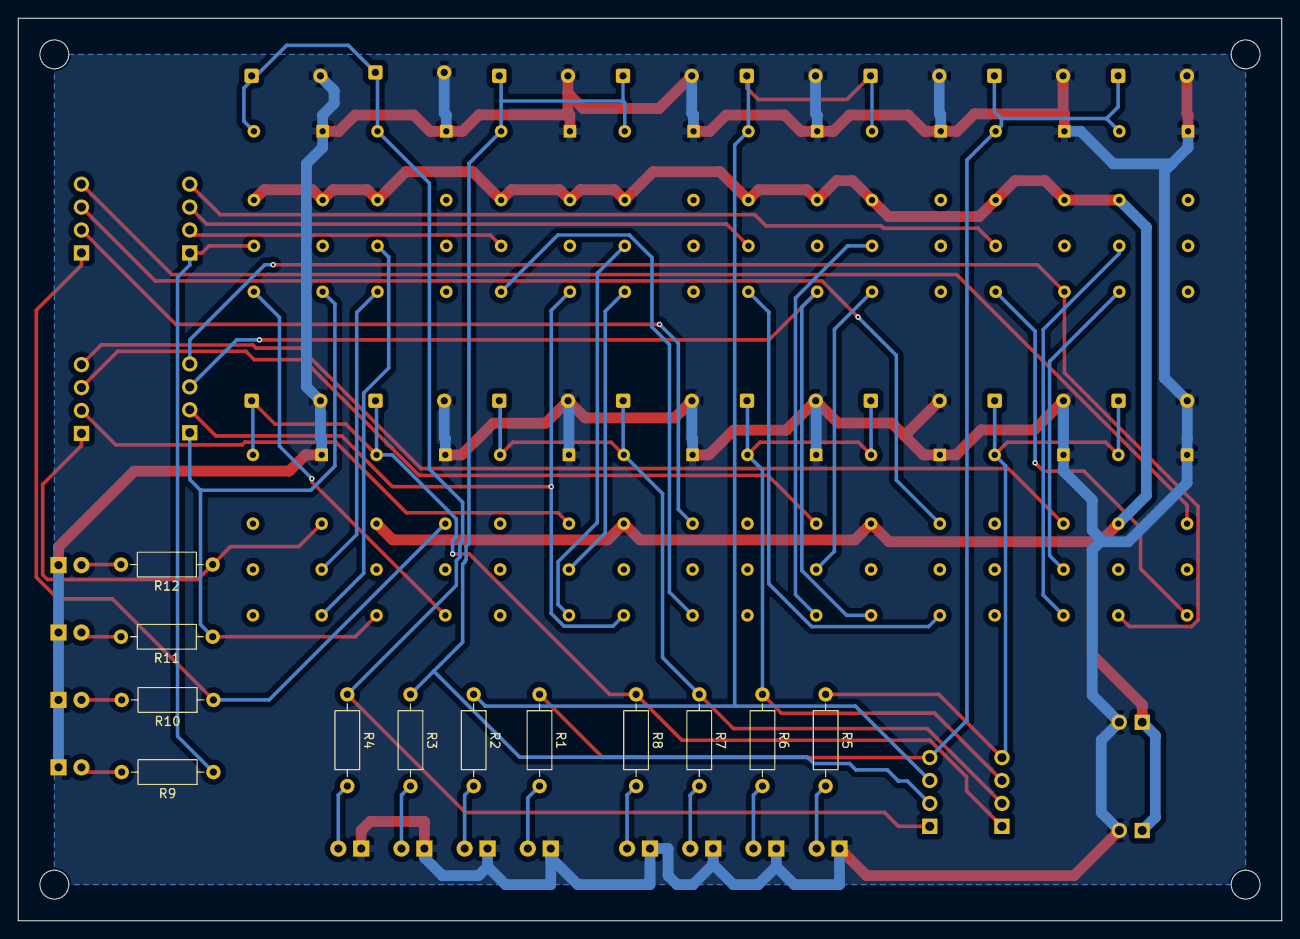
[picture p137: board LogicBlock.kicad_pcb from below]

Board: 2 copper layers, 140.0 x 100.0 mm, 68 parts (12 on the bottom side), 50 nets.
