RadeonHD6750/Relay4bitComputer/Full-Adder/Full-Adder.kicad_pcb

## KiCad design Full-Adder/Full-Adder.kicad_pcb (2026-05-12)

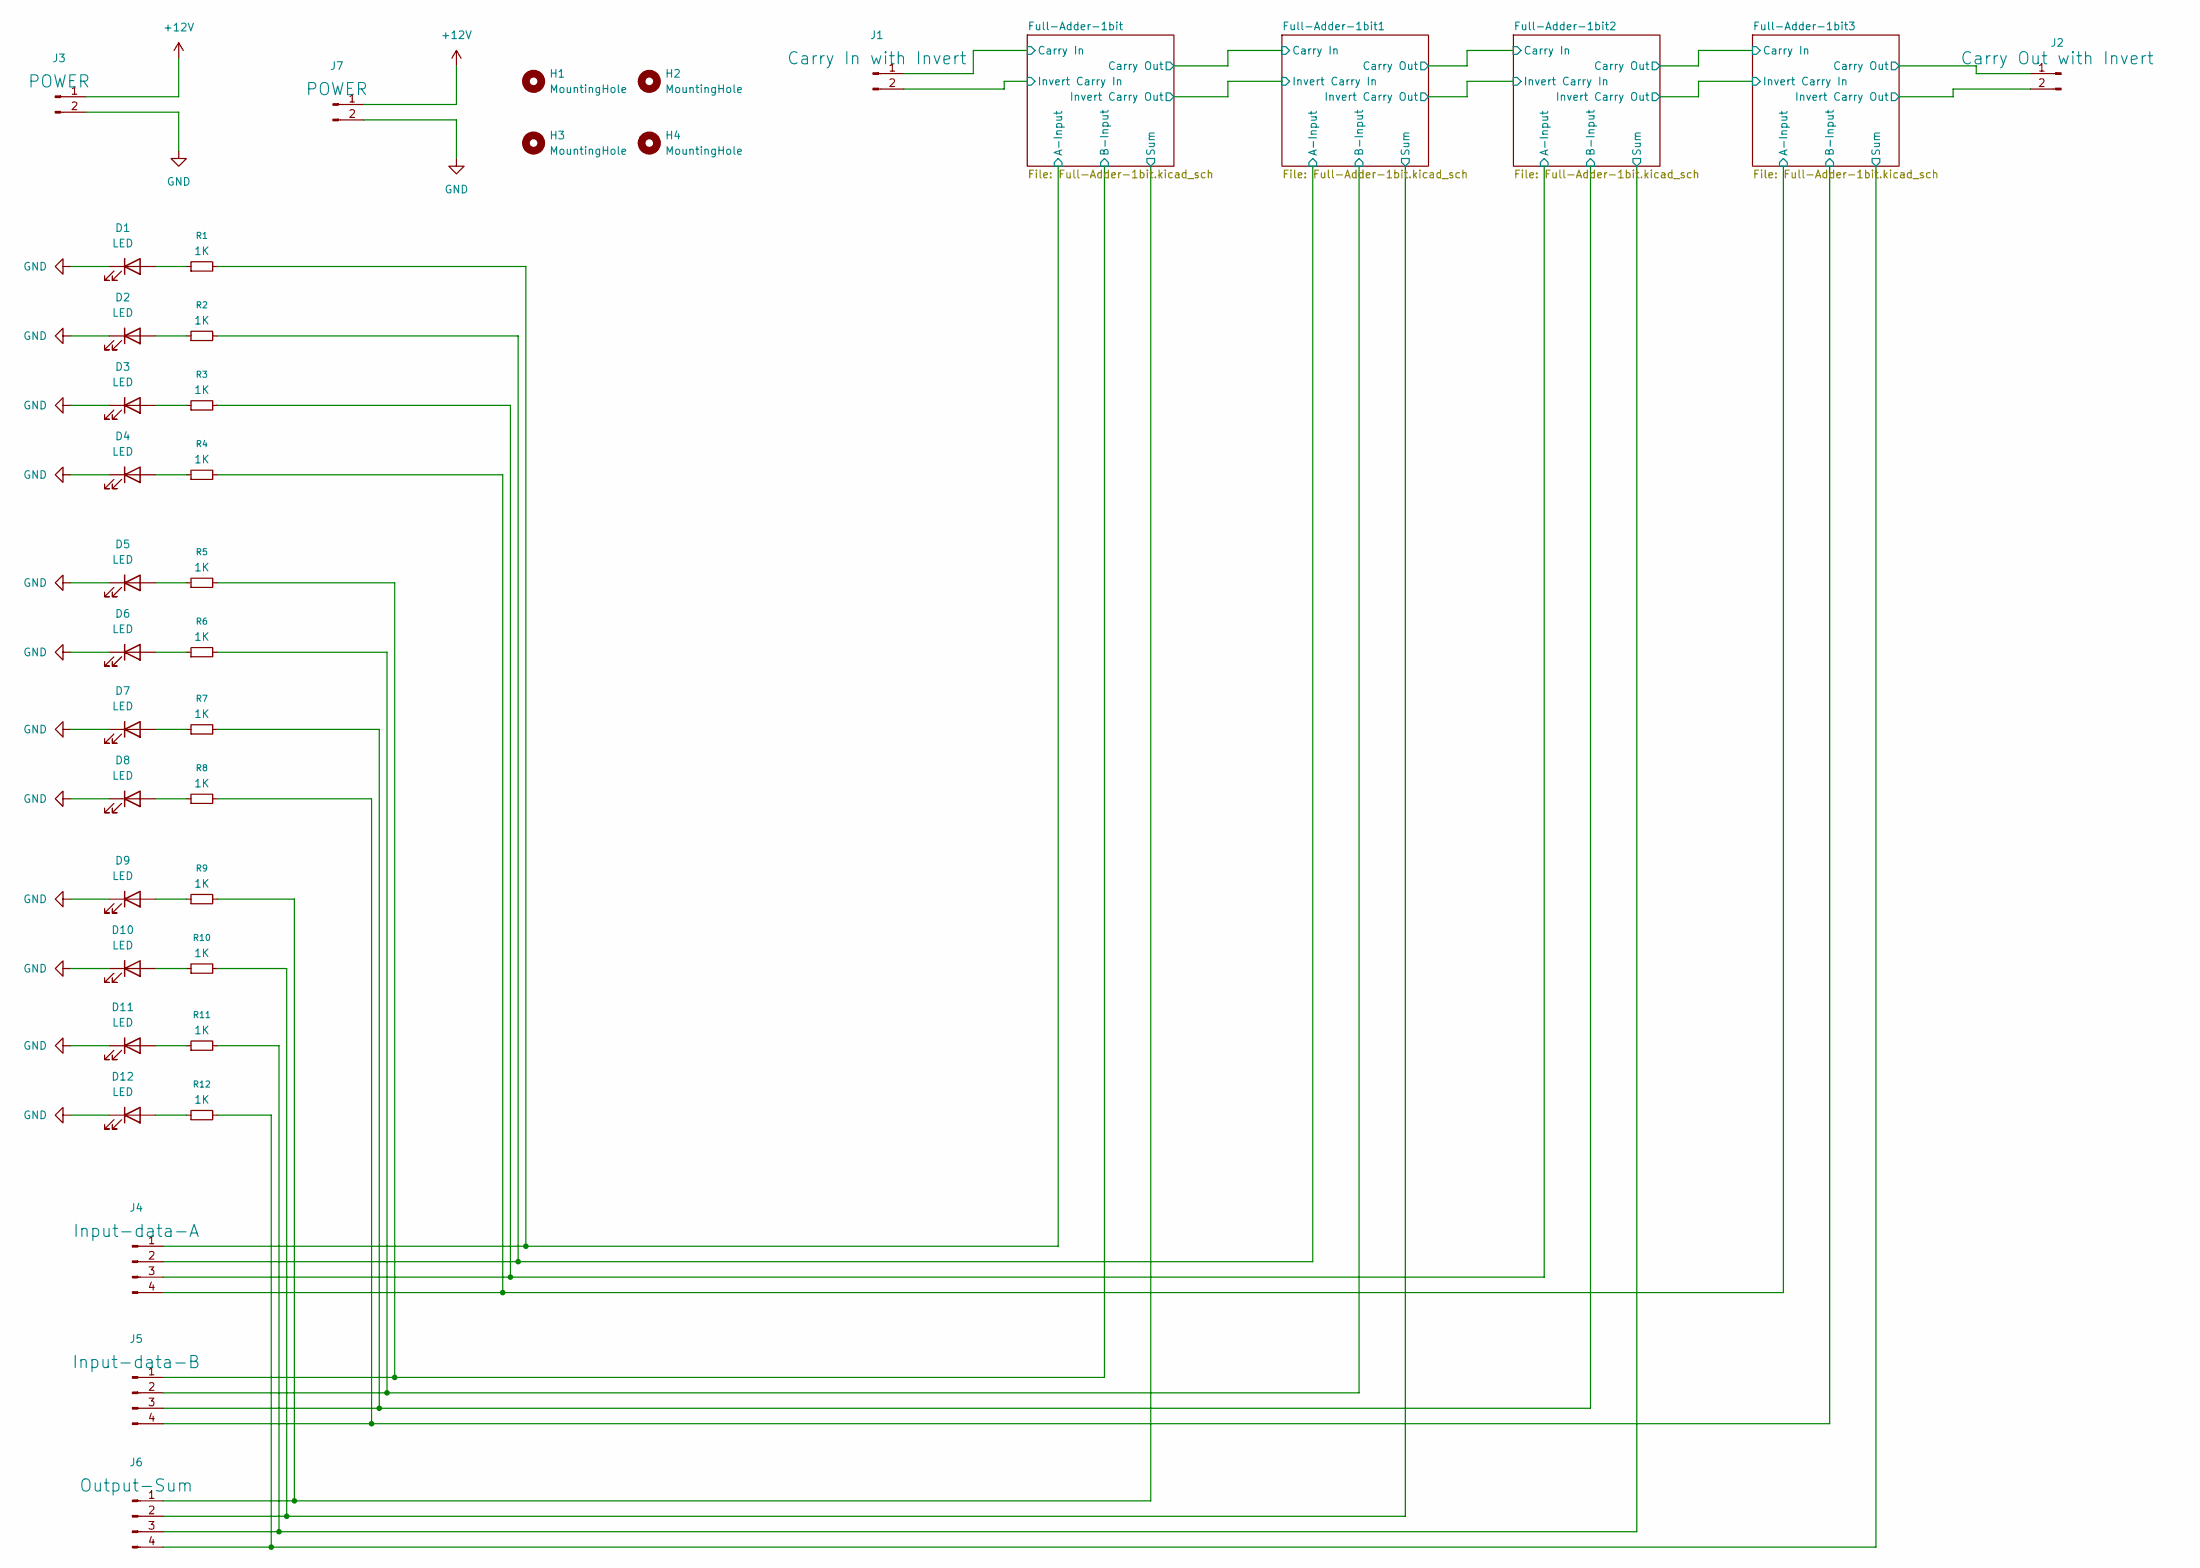
[picture p138: schematic Full-Adder.kicad_sch]

Parts:
D1, D2, D3, D4, D5, D6, D7, D8, D9, D10, D11, D12: LED; LED_D5.0mm
H1, H2, H3, H4: MountingHole; MountingHole_3.2mm_M3_Pad
J1: Carry In with Invert; PinHeader_1x02_P2.54mm_Vertical
J2: Carry Out with Invert; PinHeader_1x02_P2.54mm_Vertical
J3, J7: POWER; PinHeader_1x02_P2.54mm_Vertical
J4: Input-data-A; PinHeader_1x04_P2.54mm_Vertical
J5: Input-data-B; PinHeader_1x04_P2.54mm_Vertical
J6: Output-Sum; PinHeader_1x04_P2.54mm_Vertical
R1, R2, R3, R4, R5, R6, R7, R8, R9, R10, R11, R12: 1K; R_Axial_DIN0207_L6.3mm_D2.5mm_P10.16mm_Horizontal

Connections:
+12V: J3.1, J7.1; also elsewhere on the board
/Full-Adder-1bit1/A-Input: J4.2, R2.2; also elsewhere on the board
/Full-Adder-1bit1/B-Input: J5.2, R6.2; also elsewhere on the board
/Full-Adder-1bit1/Sum: J6.2, R10.2; also elsewhere on the board
/Full-Adder-1bit2/A-Input: J4.3, R3.2; also elsewhere on the board
/Full-Adder-1bit2/B-Input: J5.3, R7.2; also elsewhere on the board
/Full-Adder-1bit2/Sum: J6.3, R11.2; also elsewhere on the board
/Full-Adder-1bit3/A-Input: J4.4, R4.2; also elsewhere on the board
/Full-Adder-1bit3/B-Input: J5.4, R8.2; also elsewhere on the board
/Full-Adder-1bit3/Carry Out: J2.1; also elsewhere on the board
/Full-Adder-1bit3/Invert Carry Out: J2.2; also elsewhere on the board
/Full-Adder-1bit3/Sum: J6.4, R12.2; also elsewhere on the board
/Full-Adder-1bit/A-Input: J4.1, R1.2; also elsewhere on the board
/Full-Adder-1bit/B-Input: J5.1, R5.2; also elsewhere on the board
/Full-Adder-1bit/Carry In: J1.1; also elsewhere on the board
/Full-Adder-1bit/Invert Carry In: J1.2; also elsewhere on the board
/Full-Adder-1bit/Sum: J6.1, R9.2; also elsewhere on the board
GND: D1.1 (K), D2.1 (K), D3.1 (K), D4.1 (K), D5.1 (K), D6.1 (K), D7.1 (K), D8.1 (K), D9.1 (K), D10.1 (K), D11.1 (K), D12.1 (K), J3.2, J7.2; also elsewhere on the board
unnamed: D1.2 (A), R1.1
unnamed: D2.2 (A), R2.1
unnamed: D3.2 (A), R3.1
unnamed: D4.2 (A), R4.1
unnamed: D5.2 (A), R5.1
unnamed: D6.2 (A), R6.1
unnamed: D7.2 (A), R7.1
unnamed: D8.2 (A), R8.1
unnamed: D9.2 (A), R9.1
unnamed: D10.2 (A), R10.1
unnamed: D11.2 (A), R11.1
unnamed: D12.2 (A), R12.1

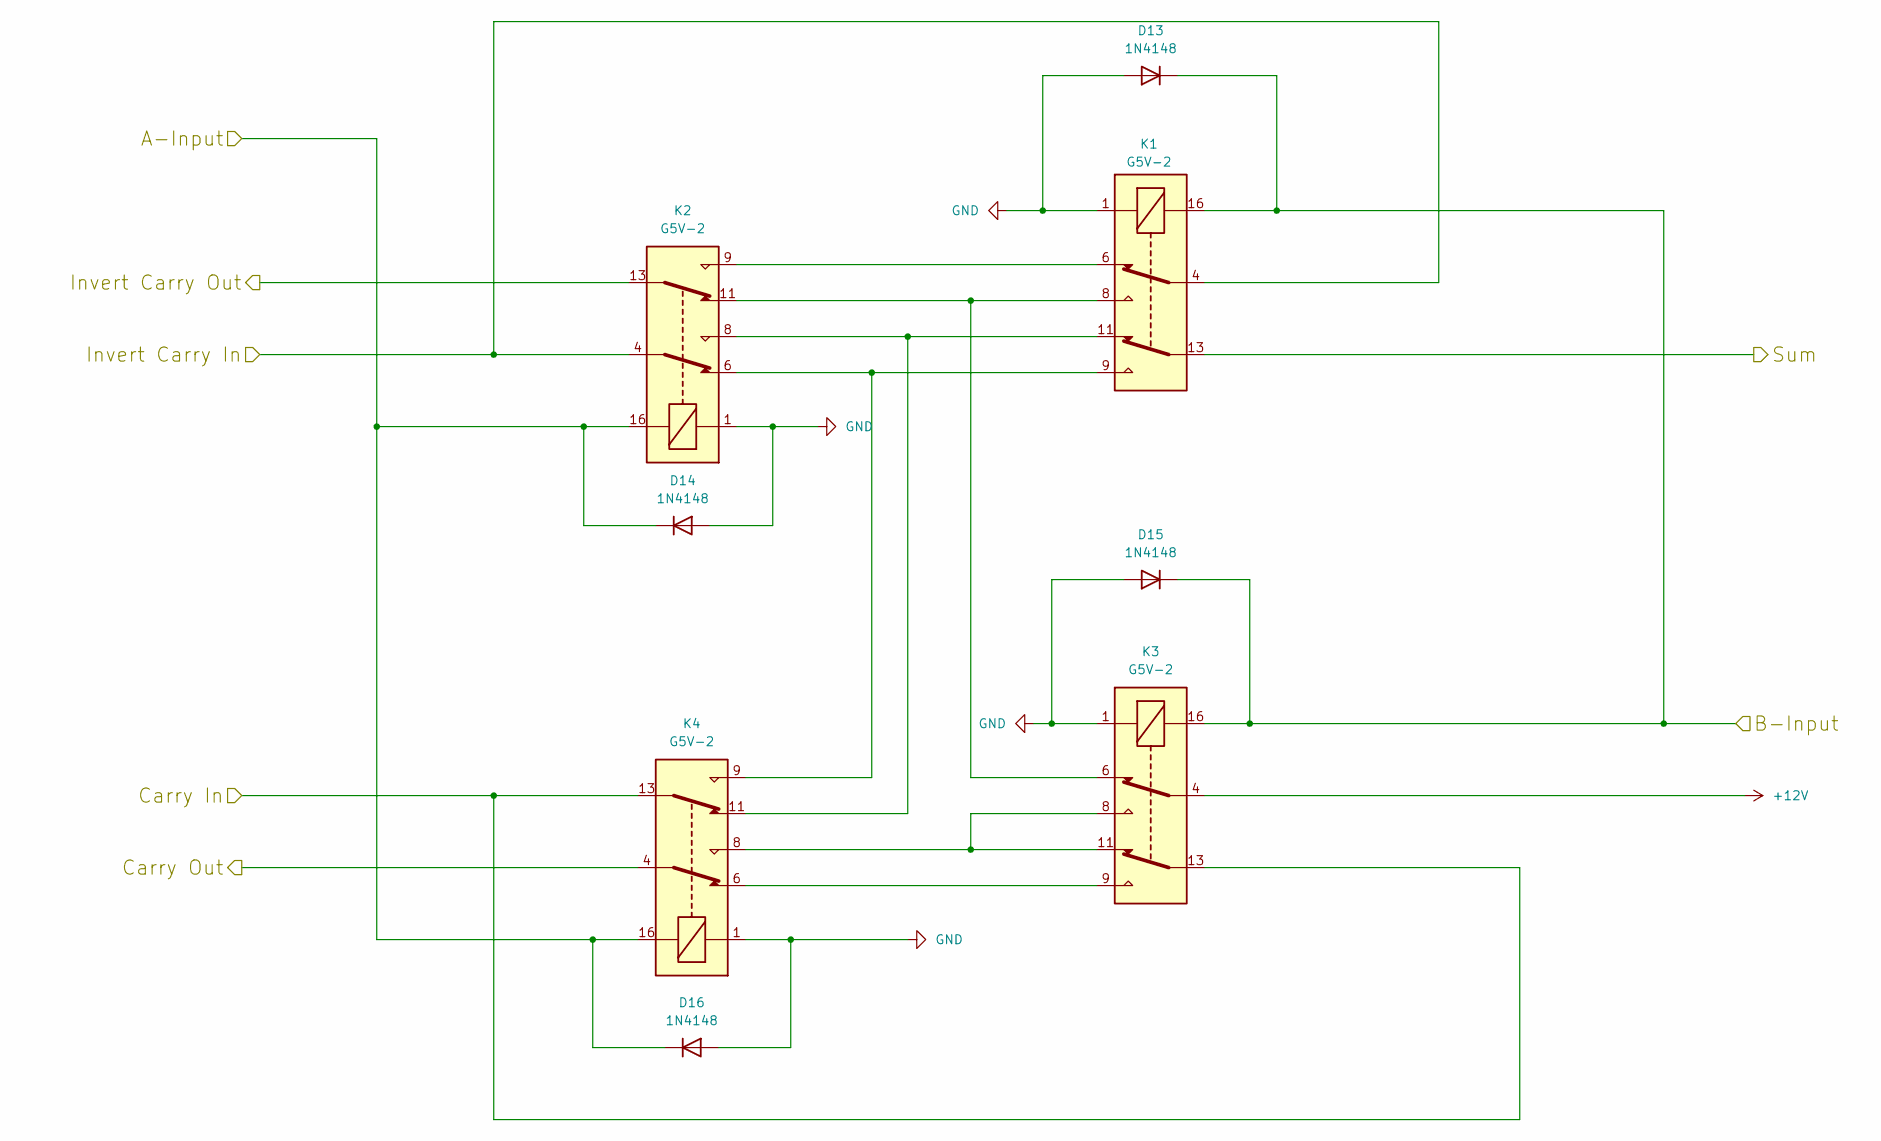
[picture p139: schematic Full-Adder-1bit.kicad_sch]

Parts:
D13, D14, D15, D16: 1N4148; D_DO-35_SOD27_P7.62mm_Horizontal
K1, K2, K3, K4: G5V-2; Relay_DPDT_Omron_G5V-2

Connections:
+12V: K3.4; also elsewhere on the board
/Full-Adder-1bit/A-Input: D14.1 (K), D16.1 (K), K2.16, K4.16; also elsewhere on the board
/Full-Adder-1bit/B-Input: D13.1 (K), D15.1 (K), K1.16, K3.16; also elsewhere on the board
/Full-Adder-1bit/Carry In: K3.13, K4.13; also elsewhere on the board
/Full-Adder-1bit/Carry Out: K4.4; also elsewhere on the board
/Full-Adder-1bit/Invert Carry In: K1.4, K2.4; also elsewhere on the board
/Full-Adder-1bit/Invert Carry Out: K2.13; also elsewhere on the board
/Full-Adder-1bit/Sum: K1.13; also elsewhere on the board
GND: D13.2 (A), D14.2 (A), D15.2 (A), D16.2 (A), K1.1, K2.1, K3.1, K4.1; also elsewhere on the board
unnamed: K1.6, K2.9
unnamed: K1.8, K2.11, K3.6
unnamed: K1.9, K2.6, K4.9
unnamed: K1.11, K2.8, K4.11
unnamed: K3.9, K4.6
unnamed: K3.8, K3.11, K4.8

Parts of its further copies:
D17, D18, D19, D20, D21, D22, D23, D24, D25, D26, D27, D28: 1N4148; D_DO-35_SOD27_P7.62mm_Horizontal
K5, K6, K7, K8, K9, K10, K11, K12, K13, K14, K15, K16: G5V-2; Relay_DPDT_Omron_G5V-2

Connections of its further copies:
+12V: K7.4, K11.4, K15.4; also elsewhere on the board
/Full-Adder-1bit1/A-Input: D18.1 (K), D20.1 (K), K6.16, K8.16; also elsewhere on the board
/Full-Adder-1bit1/B-Input: D17.1 (K), D19.1 (K), K5.16, K7.16; also elsewhere on the board
/Full-Adder-1bit1/Carry Out: K8.4, K11.13, K12.13
/Full-Adder-1bit1/Invert Carry Out: K6.13, K9.4, K10.4
/Full-Adder-1bit1/Sum: K5.13; also elsewhere on the board
/Full-Adder-1bit2/A-Input: D22.1 (K), D24.1 (K), K10.16, K12.16; also elsewhere on the board
/Full-Adder-1bit2/B-Input: D21.1 (K), D23.1 (K), K9.16, K11.16; also elsewhere on the board
/Full-Adder-1bit2/Carry Out: K12.4, K15.13, K16.13
/Full-Adder-1bit2/Invert Carry Out: K10.13, K13.4, K14.4
/Full-Adder-1bit2/Sum: K9.13; also elsewhere on the board
/Full-Adder-1bit3/A-Input: D26.1 (K), D28.1 (K), K14.16, K16.16; also elsewhere on the board
/Full-Adder-1bit3/B-Input: D25.1 (K), D27.1 (K), K13.16, K15.16; also elsewhere on the board
/Full-Adder-1bit3/Carry Out: K16.4; also elsewhere on the board
/Full-Adder-1bit3/Invert Carry Out: K14.13; also elsewhere on the board
/Full-Adder-1bit3/Sum: K13.13; also elsewhere on the board
/Full-Adder-1bit/Carry Out: K7.13, K8.13; also elsewhere on the board
/Full-Adder-1bit/Invert Carry Out: K5.4, K6.4; also elsewhere on the board
GND: D17.2 (A), D18.2 (A), D19.2 (A), D20.2 (A), D21.2 (A), D22.2 (A), D23.2 (A), D24.2 (A), D25.2 (A), D26.2 (A), D27.2 (A), D28.2 (A), K5.1, K6.1, K7.1, K8.1, K9.1, K10.1, K11.1, K12.1, K13.1, K14.1, K15.1, K16.1; also elsewhere on the board
unnamed: K5.6, K6.9
unnamed: K5.8, K6.11, K7.6
unnamed: K5.9, K6.6, K8.9
unnamed: K5.11, K6.8, K8.11
unnamed: K7.9, K8.6
unnamed: K7.8, K7.11, K8.8
unnamed: K9.9, K10.6, K12.9
unnamed: K9.11, K10.8, K12.11
unnamed: K9.6, K10.9
unnamed: K9.8, K10.11, K11.6
unnamed: K11.9, K12.6
unnamed: K11.8, K11.11, K12.8
unnamed: K13.6, K14.9
unnamed: K13.8, K14.11, K15.6
unnamed: K13.9, K14.6, K16.9
unnamed: K13.11, K14.8, K16.11
unnamed: K15.9, K16.6
unnamed: K15.8, K15.11, K16.8

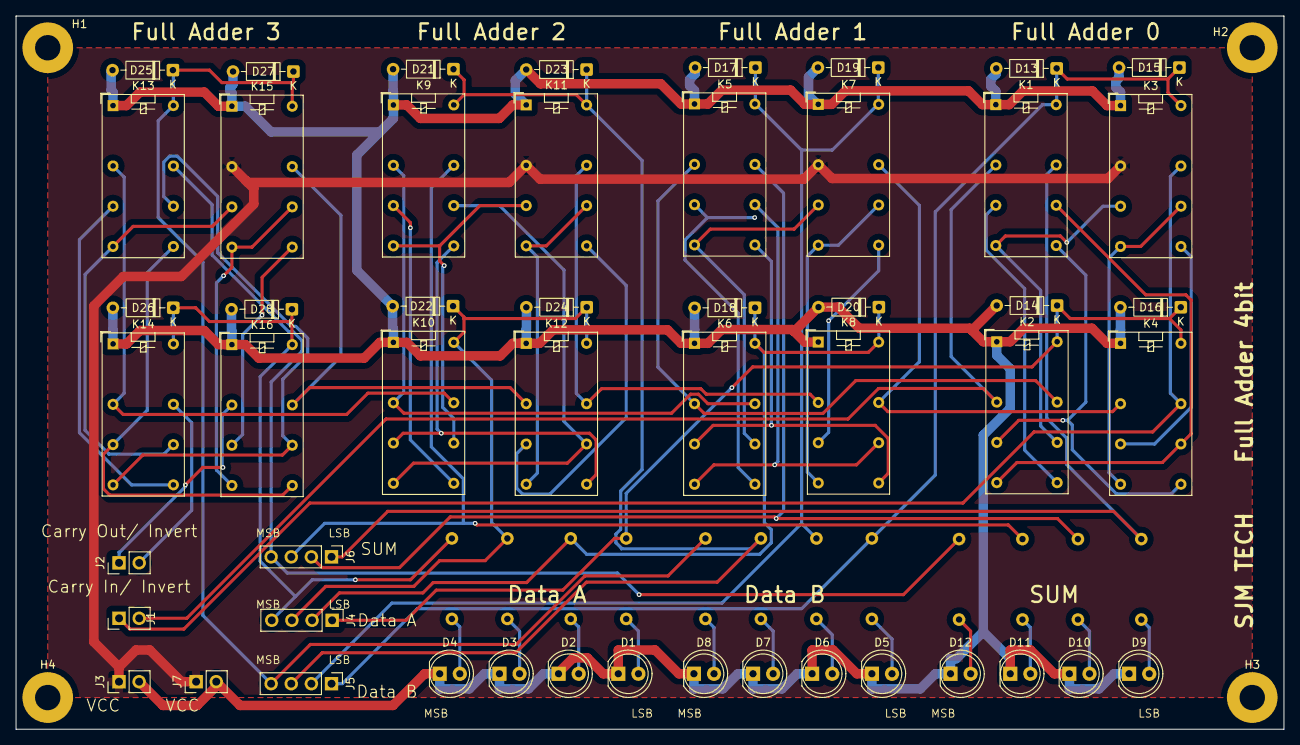
[picture p140: board Full-Adder.kicad_pcb from above]

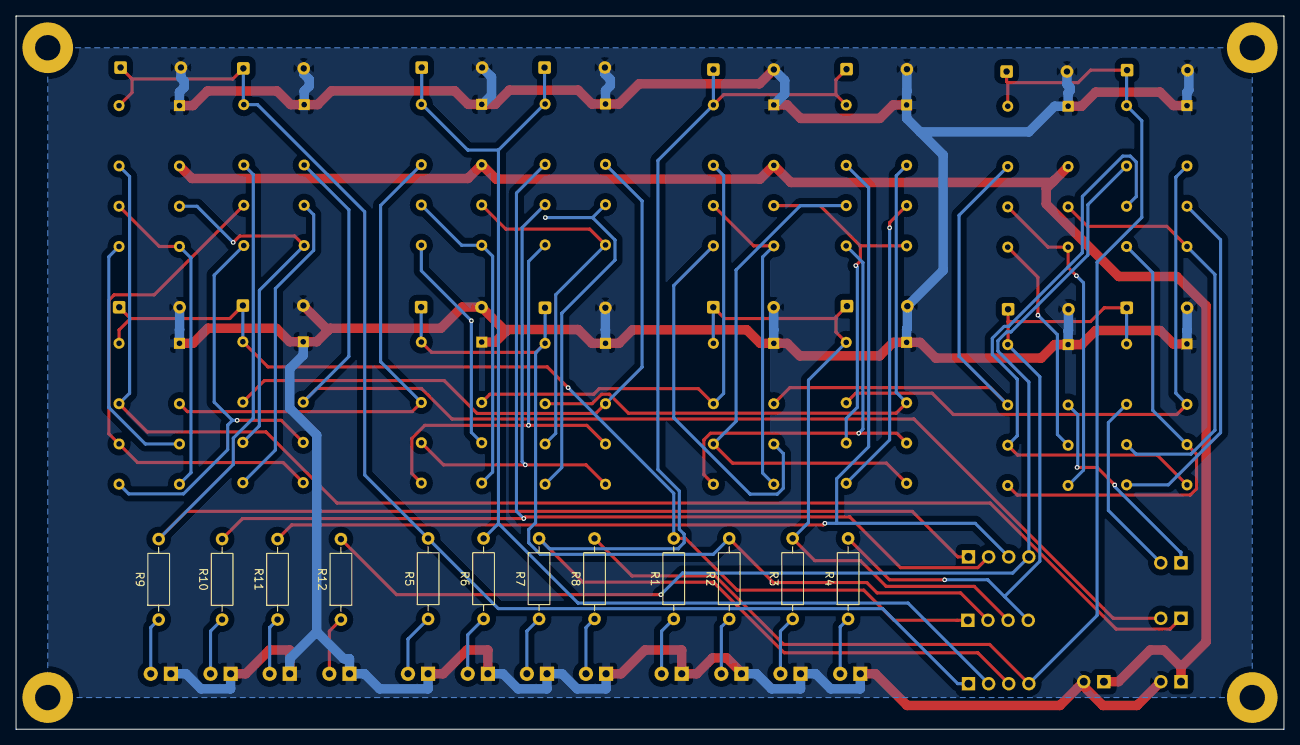
[picture p141: board Full-Adder.kicad_pcb from below]

Board: 2 copper layers, 160.0 x 90.0 mm, 67 parts (12 on the bottom side), 60 nets.
