RadeonHD6750/Relay4bitComputer/(commit log)

2026-04-28 2026-04-28
    초기설정
    [ACC Register.kicad_sch, Address MUX.kicad_sch, Arithmetic.kicad_sch, Decode-Unit.kicad_pcb, Decode-Unit.kicad_sch, Decoder.kicad_sch, Execute-Unit.kicad_pcb, Execute-Unit.kicad_sch]
2026-04-29 2026-04-29
    8bit로 설계변경
2026-04-30 2026-04-30 설계변경
    4bit에서 8bit
2026-05-01 2026-05-01 제어신호 매트릭스
    인출단계, 해독단계, 실행단계 매트릭스 작성완료
    [relay computer.xlsx]
2026-05-01 2026-05-01 참고자료
    참고자료
2026-05-04 2026-05-04 전가산기 시뮬
    전가산기 시뮬 2bit 짜리 완성
2026-05-06 2026-05-06 Full Adder
    전가산기 4bit짜리 설계 아트웤 해야 됨
    [ALU.kicad_pcb, ALU.kicad_sch, Arithmetic.kicad_sch, Counter.kicad_pcb, Counter.kicad_sch, Decoder.kicad_pcb, Decoder.kicad_sch, Full-Adder-1bit.kicad_sch]
2026-05-06 2026-05-06
    LED 추가
    [Full-Adder-1bit.kicad_sch, Full-Adder.kicad_sch]
2026-05-07 2026-05-07 4bit Full Adder 완성
    4bit 전가산기 모듈 완성
    [Full-Adder-1bit.kicad_sch, Full-Adder.kicad_pcb, Full-Adder.kicad_sch]
2026-05-07 2026-05-07 다이오드 변경
    1N4148으로 변경
    [Full-Adder-1bit.kicad_sch, Full-Adder.kicad_pcb, Full-Adder.kicad_sch]
2026-05-08 2026-05-08
    다이오드 교체완료
    [Full-Adder.kicad_pcb]
2026-05-08 2026-05-08 자동배선
    자동배선
    [Full-Adder.kicad_pcb]
2026-05-08 2026-05-08 영역 채우기 완료
    영역 채우기 완료
    [Full-Adder.kicad_pcb]
2026-05-08 2026-05-08 Register 설계완료
    전가산기에 전력선 추가해야 됨.
    레지스터에 라우팅 해야 됨.
    [Register.kicad_pcb, Register.kicad_sch]
2026-05-08 2026-05-08 전가산기 작업
    마운트홀을 그냥 마운트로 변경
    전력단자 추가
    [Full-Adder.kicad_pcb, Full-Adder.kicad_sch]
2026-05-08 2026-05-08 가감산기
    가감산기 논리회로
2026-05-10 2026-05-10, 레지스터,디코더, ROM 완성
    레지스터 배선
    디코더 작업
    ROM 작업
    [Decoder.kicad_pcb, Decoder.kicad_sch, Full-Adder.kicad_pcb, MatrixROM.kicad_pcb, MatrixROM.kicad_sch, Register.kicad_pcb, Register.kicad_sch, relay computer.xlsx]
2026-05-11 2026-05-11 서로 다른 클럭수 구현
    서로 다른 클럭수 구현 방법
2026-05-11 2026-05-11 카운터
    전가산기 + 레지스터 조합으로 만들 예정
    [Counter.kicad_sch, relay computer.xlsx, zNex~$harerelay computer.xlsx]
2026-05-11 2026-05-11 MircoROM 통합
    인출단계 ROM을 실행ROM이랑 통합
    [Counter.kicad_sch, relay computer.xlsx]
2026-05-12 2026-05-12 Counter는 링카운터로
    32개만 있으면 된다.
    [Counter.kicad_sch]
2026-05-12 2026-05-12 ring counter 4bit module
    링카운터로 만들긴 했는데 회로동작 검증이 필요할듯
    [Counter.kicad_sch]
2026-05-12 2026-05-12 배선정리
    배선정리
    [Decoder.kicad_pcb, Decoder.kicad_sch, Full-Adder.kicad_pcb, MatrixROM.kicad_pcb, Register.kicad_pcb]
2026-05-12 2026-05-12 1차 주문
    FA, REG, Decoder, Matrix
    [Decoder-B_Cu.gbr, Decoder-B_Mask.gbr, Decoder-B_Paste.gbr, Decoder-B_Silkscreen.gbr, Decoder-Edge_Cuts.gbr, Decoder-F_Cu.gbr, Decoder-F_Mask.gbr, Decoder-F_Paste.gbr]
2026-05-25 2026-05-25
    Full Adder 실험 결과, 전력이 연산결과에 따라 일정하지 않음. 따라서 Enabler를 통하여 다시 12V로 쏴주는 것이 필요함. 뭐 논리기능으로도 활성 비활성도 같이 겸할 수 있으니 다행인가?
    [Enabler.kicad_pcb, Enabler.kicad_sch]
2026-05-25 2026-05-25 3-8 디코더 문제발견
    디코더 입력단자 디버그 LED들이 순서가 뒤바껴있음. 그나마 기능 자체는 정상동작함. 입력단 LED들만 이상한 순서로 되어 있고, 회로도 자체는 문제없음. 즉, 아트웤에서 풋프린트 배치가 잘못된거임. 기능 자체를 이상없으니 입력단 LED만 제외하고 사용하면 될듯. 그대로 혹시 몰라 일단 아트웤 배선 초기화해둠.
    [Decoder.kicad_pcb]
2026-05-25 2026-05-25
    일지기록 시작
2026-05-25 2026-05-25 레지스터 동작점검 결과
    동작에는 문제없으나 Read/Write 공유를 할 수 없어 4Nbit를 만들 때 N개의 Read/Write를 연결해야 한다. 따라서 체인할 수 있게 단자 추가함.
    [Register.kicad_pcb, Register.kicad_sch]
2026-05-27 2026-05-27
    Select/Write 로직을 수행할 릴레이를 절약하기 위해 공통선으로 묶고 공유 시키기
    [Register.kicad_pcb, Register.kicad_sch]
2026-05-27 2026-05-27
    카운터는 그냥 레지스터와 가산기 활용해서 동기식으로 구현하고, 로직블럭은 4bit 단위로 쪼개서 구현
    [Counter.kicad_sch, LogicBlock.kicad_pcb, LogicBlock.kicad_sch, LogicBlock1bit.kicad_sch, Register.kicad_pcb, Register.kicad_sch]
2026-05-28 2026-05-28
    레지스터에 기억기능을 비활성화하여 단순 전송여부만 결정할 트랜스퍼 기능 추가, 논리연산을 수행할 로직블럭 제작
    [LogicBlock.kicad_sch, Register.kicad_pcb, Register.kicad_sch]
2026-05-29 2026-05-29
    이왕 하는 거, 명령어 16개로 증설
    명령어 매트릭스 수정해야됨
    로직블럭 아트웍 해야됨
    [LogicBlock.kicad_pcb, LogicBlock.kicad_sch, LogicBlock1bit.kicad_sch, relay computer.xlsx]
2026-05-30 2026-05-31
    로직블럭 아트웍 하는 중
    [LogicBlock.kicad_pcb, LogicBlock.kicad_sch, LogicBlock1bit.kicad_sch]
2026-05-31 2026-05-31
    ALU에 디버그를 위한 LED가 필요
    [ALU.kicad_pcb, ALU.kicad_sch, Arithmetic.kicad_sch, FlagCarry Invert.kicad_sch, Logic Operation.kicad_sch, LogicBlock.kicad_pcb, LogicBlock.kicad_sch, XOR.kicad_sch]
2026-06-01 2026-06-01
    ALU 플래그 라벨 추가
    [ALU.kicad_sch, Arithmetic.kicad_sch]
2026-06-03 2026-06-03
    산술장치 분리, ALU 설계 완료
    [ALU.kicad_pcb, ALU.kicad_sch, Arithmetic-Unit.kicad_pcb, Arithmetic-Unit.kicad_sch, Arithmetic.kicad_sch, CarryInvertOperation.kicad_sch, Logic Operation.kicad_sch, Logic-Unit.kicad_pcb]
2026-06-04 2026-06-04
    BIU까지는 만들어야 결합할듯
    [Bus-Interface-Unit.kicad_pcb, Bus-Interface-Unit.kicad_sch]
2026-06-05 2026-06-05
    BIU 시작
    [Bus-Interface-Unit.kicad_sch]
2026-06-07 2026-06-07
    BIU 배선 해야 됨
    [Bus-Interface-Unit.kicad_pcb, Bus-Interface-Unit.kicad_sch, relay computer.xlsx]
2026-06-09 2026-06-09
    BIU 초안 완료
    [Bus-Interface-Unit.kicad_pcb]
2026-06-10 2026-06-10
    Register, Arithmetic, LogicBlock, ALU 라우팅 완료, 거버 생성은 해야 됨
    [ALU.kicad_pcb, ALU.kicad_sch, Arithmetic-Unit.kicad_pcb, Arithmetic-Unit.kicad_sch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]
2026-06-11 2026-06-11
    8만원 정도로 PCB 주문
    [ALU-B_Cu.gbr, ALU-B_Mask.gbr, ALU-B_Paste.gbr, ALU-B_Silkscreen.gbr, ALU-Edge_Cuts.gbr, ALU-F_Cu.gbr, ALU-F_Mask.gbr, ALU-F_Paste.gbr]
2026-06-16 2026-06-16
    동일된 사이클로 명령어를 처리하기 위한 회로도 작성
    [Enabler.kicad_sch, relay computer.xlsx, zNex~$harerelay computer.xlsx]
2026-06-16 타이밍 단자 추가
    타이밍 단자 추가
    [Enabler.kicad_sch, zNex~$harerelay computer.xlsx]
2026-06-18 2026-06-18
    회로 점검
    [Enabler.kicad_sch]
2026-06-28 타이밍 보강해야 함
    지금 타이밍2스텝인데 4스텝까지도 생각해야됨
    [Enabler.kicad_sch]
2026-06-30 2026-06-30
    어느 정도는 된 것 같은데 좀 더 봐야 할듯
    [Enabler.kicad_sch]
2026-07-01 2026-07-01
    링카운터 남았다
    [Enabler-B_Cu.gbr, Enabler-B_Mask.gbr, Enabler-B_Paste.gbr, Enabler-B_Silkscreen.gbr, Enabler-Edge_Cuts.gbr, Enabler-F_Cu.gbr, Enabler-F_Mask.gbr, Enabler-F_Paste.gbr]
2026-07-02 2026-07-02
    링카운터 설계 거의 끝남
    [Counter.kicad_sch]
2026-07-04 디코더, Enabler, 카운터
    디코더 수정완료, Enabler 완료
    카운터는 좀더 고민이 필요함.
    확실한 스타트를 위한 회로가 필요함
    [Counter.kicad_pcb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]
2026-07-05 2026-07-05
    ROM이 기능 자체는 문제 없는데 표기가 너무 엉망임
    active HIGH로 되어 있어서 점퍼가 필요함
    새로운 회로는 LOW로 변경함
    [MatrixROM.kicad_pcb, MatrixROM.kicad_sch, relay computer.xlsx]
2026-07-09 INC
    스택은 1포인트만 하자
    [relay computer.xlsx]
2026-07-11 3차 PCB 주문
    Enabler와 레지스터 추가 주문
    [Counter.kicad_pcb, Counter.kicad_sch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]
2026-07-26 2026-07-26
    설계서 검토
    [relay computer.xlsx]
2026-08-02 38 디코더 입력 체인 추가
    4bit를 만드려면 지금은 점퍼 해야 됨
    [Decoder.kicad_pcb, Decoder.kicad_sch]
